Tommydag/BLDC-Motor-Controller/Documentation/PhotosOfBoard/IMG_7694.JPG

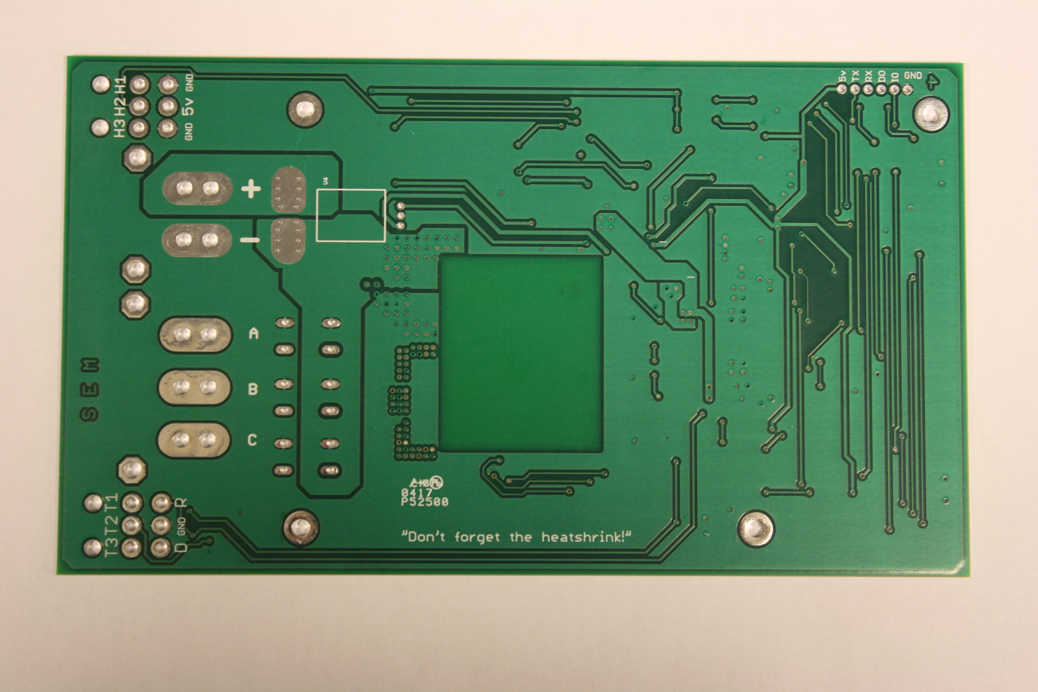
Documentation/PhotosOfBoard/IMG_7694.JPG
