Tommydag/BLDC-Motor-Controller/Documentation/PhotosOfBoard/IMG_7686.JPG

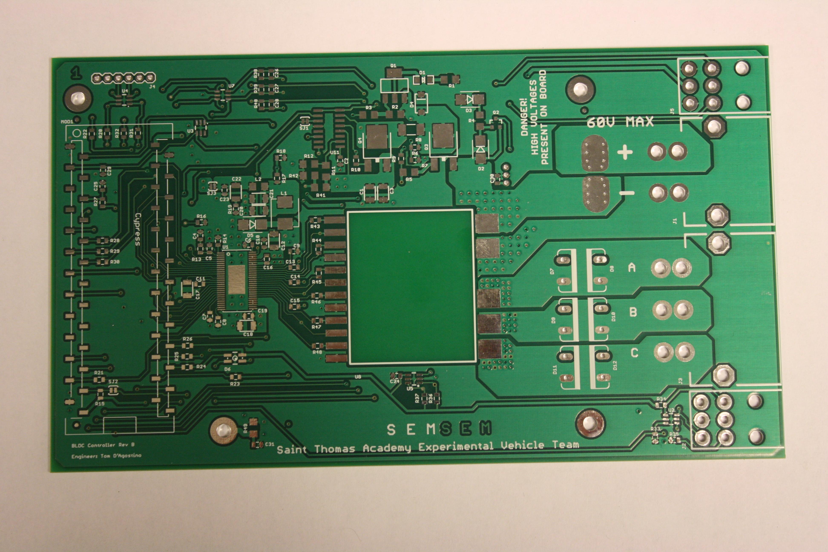
Documentation/PhotosOfBoard/IMG_7686.JPG
