Tommydag/BLDC-Motor-Controller/README.md

# BLDC-Motor-Controller
A BLDC Motor Controller for small electric vehicles
