Tommydag/BLDC-Motor-Controller/Documentation/RevC Documents/psoc_pinout.xlsx

PSOC Pin Planning
 |  |  |  |  |  |  | Signals that need to be routed | Type
PSOC Pin | Chip Region | Chip Features | Additional chip features | Side (L/R) | Board Features | Assigned Function | H1 | D in
2.0 | Mixed |  |  | L |  | reverse | H2 | D in
2.1 | Mixed |  |  | L | user LED |  | H3 | D in
2.2 | Mixed |  |  | L | user Pushbutton |  | T Alert | D in
2.3 | Mixed |  |  | L |  | inh a | GPIO_TBD | DIO
2.4 | Mixed |  |  | L |  | inl a | REVERSE | D in
2.5 | Mixed |  |  | L |  | inh b | VIN Fault | D in
2.6 | Mixed |  |  | L |  | inl b | disp_out | D out
2.7 | Mixed |  |  | L |  | inh c | disable | D in
12.7 | Mixed | SIO |  | L |  | inl c | led blue | D out
12.6 | Mixed | SIO |  | L |  | led blue | led green | Dout
12.5 | Mixed | SIO |  | L |  | led green | led red | D out
12.4 | Mixed | SIO |  | L |  | led red | inh a | D out
12.3 | Mixed | SIO |  | L |  | gpio_tbd | inl a | D out
12.2 | Mixed | SIO |  | L |  | H1 | inh b | D out
12.1 | Mixed | SIO |  | L |  | H2 | inl b | D out
12.0 | Mixed | SIO |  | L |  | H3 | inh c | D out
1.0 | Digital | DEBUG |  | L |  |  | inl c | D out
1.1 | Digital | DEBUG |  | L |  |  | monitor tx | D out
1.2 | Digital | reset |  | L |  | PULLUP | monitor rx | D in
1.3 | Digital | DEBUG |  | L |  |  | throttle | Analog in
1.4 | Digital |  |  | L |  | monitor tx | vbat in | Analog in
1.5 | Digital |  |  | L |  | monitor rx | ibat in | Analog in
1.6 | Digital |  |  | L |  | vin_fault | sda | DIO
1.7 | Digital |  |  | L |  | disp_out | scl | DO
3.0 | Analog |  |  | R |  | modeset 1
3.1 | Analog |  |  | R |  | modeset 2 | bypass cap adc1 | Analog in
3.2 | Analog | opamp3 inverting | internal reference bypass cap | R | Bypass cap | bypass cap | bypass cap adc2 | Analog in
3.3 | Analog | opamp3 non-inverting |  | R |  | modeset 3 | modeset 1 | D in
3.4 | Analog | opamp 1 inverting |  | R |  | modeset 4 | modeset 2 | D in
3.5 | Analog | opamp 1 non-inverting |  | R |  | throttle | modeset 3 | D in
3.6 | Analog | opamp1 out |  | R |  |  | modeset 4 | D in
3.7 | Analog | opamp3 out |  | R
15.0 | Digital |  |  | R |  | sda
15.1 | Digital |  |  | R |  | scl
15.2 | Digital |  |  | R |  | T alert
15.3 | Digital |  |  | R |  | disable
15.4 | Digital |  |  | R | cmod cap
15.5 | Digital |  |  | R
0.0 | Analog | OpAmp2 Out |  | R
0.1 | Analog | OpAmp0 Out |  | R |  | vbat in
0.2 | Analog | OpAmp0 non-inverting | SAR ADC refernce input | R | Bypass cap
0.3 | Analog | OpAmp0 inverting | internal reference bypass cap | R | Bypass cap | bypass cap
0.4 | Analog | OpAmp2 non-inverting |  | R | Bypass cap
0.5 | Analog | OpAmp2 inverting |  | R |  | ibat in
0.6 | Analog |  |  | R
0.7 | Analog |  |  | R
RST |  |  |  | R
