Tommydag/BLDC-Motor-Controller/Documentation/RevC Documents/PSU/LT8631 Vout1 Efficiency Chart.png

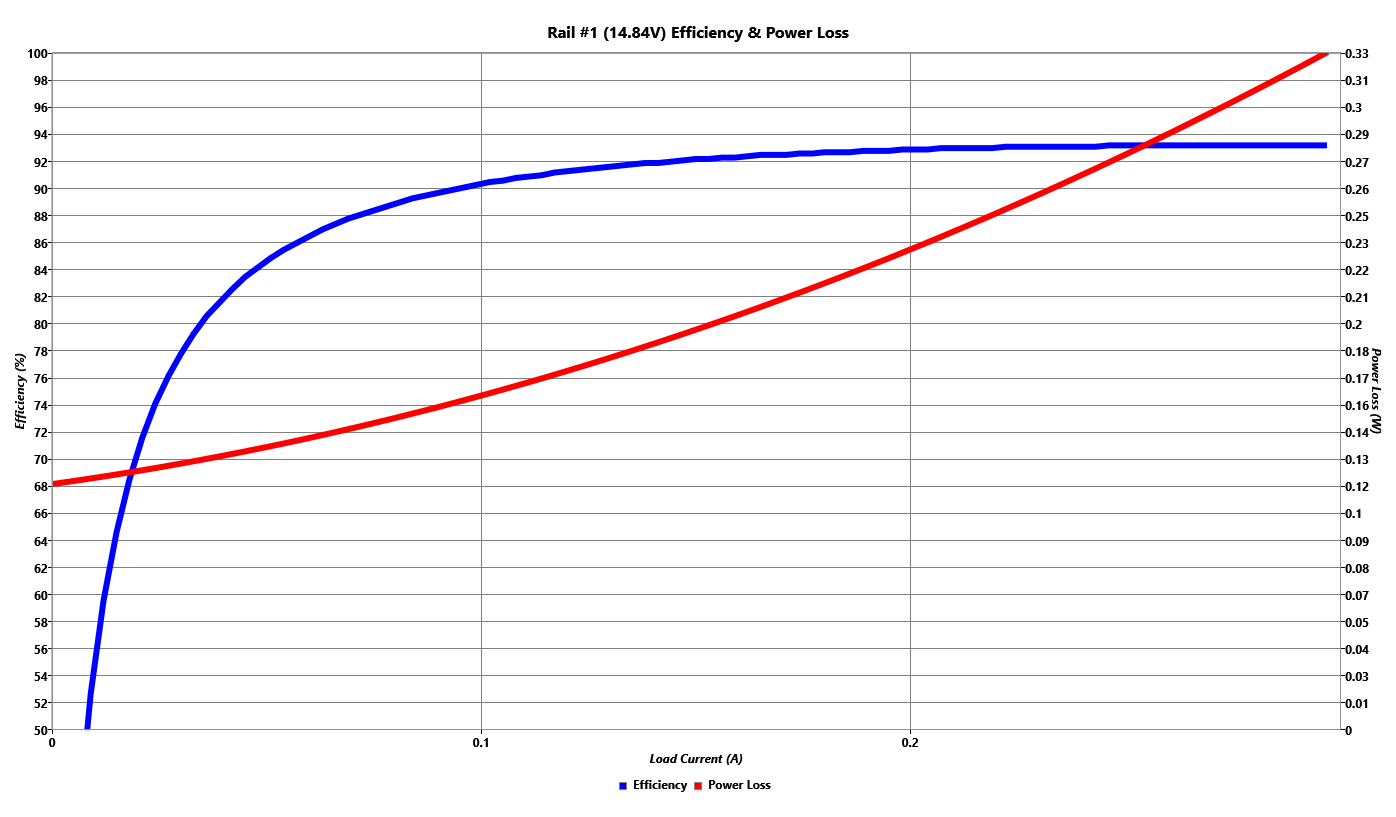
Documentation/RevC Documents/PSU/LT8631 Vout1 Efficiency Chart.png
