Tommydag/BLDC-Motor-Controller/PCBs/Projects/MotorController/CAM/BOM_reformatted.xlsx

 |  | PCB Revision: B | BOM Rev: 1
 |  | Engineer: Tom D'Agostino | Date: 1/20/2017
BOM Number | Qty | Value | Device | Package | Parts | Notes | Manufacturer | Manufacturer Part Number | Supplier | Supplier Part Number
1 | 4 | 4.7u | CAP1210 | 1210 | C1, C3, C12, C18 | 70v | Murata | GRM32ER71K475KE14L (https://www.digikey.com/product-detail/en/murata-electronics-north-america/GRM32ER71K475KE14L/490-9972-1-ND/5026477) | Digikey | 490-9972-1-ND (https://www.digikey.com/product-detail/en/murata-electronics-north-america/GRM32ER71K475KE14L/490-9972-1-ND/5026477)
2 | 9 | 0.1u | CAP0805 | 0805 | C10, C13, C14, C15, C16, C19, C24, C25, C30 | 70v | Samsung | CL21B104KCFNNNE | Digikey | 1276-6840-1-ND
3 | 1 | 2.2u | CAP1210 | 1210 | C17 | 25v | Samsung | CL32B225KAINNNE | Digikey | 1276-1313-1-ND
4 | 1 | 47n | CAP0805 | 0805 | C2 | 10v,NP0 | Kemet | C0805C473J3GACAUTO | Digikey | 399-6970-1-ND
5 | 3 | 47u | CAP1210 | 1210 | C20, C21, C22 | 10v | Taiyo Yuden | LMK325B7476MM-TR | Digikey | 587-2783-1-ND
6 | 2 | 0.01u | CAP0805 | 0805 | C23, C31 | 80v | AVX Corporation | 08051C103KAT2A | Digikey | 478-1358-1-ND
7 | 4 | 10n | CAP0805 | 0805 | C26, C27, C28, C29 | 10v | AVX Corporation | 08051C103KAT2A | Digikey | 478-1358-1-ND
8 | 1 | 6.8n | CAP0805 | 0805 | C4 | 70v,NP0 | TDK Corp. | CGA4J2C0G2A682J125AA | Digikey | 445-15555-1-ND
9 | 1 | 120p | CAP0805 | 0805 | C5 | 70v,NP0 | Yageo | CC0805JRNPO0BN121 | Digikey | 311-1836-1-ND
10 | 3 | 22n | CAP0805 | 0805 | C6, C9, C11 | 70v,NP0 | TDK Corp. | CGA4J1C0G2A223J125AC | Digikey | 445-172690-1-ND
11 | 2 | 1u | CAP0805 | 0805 | C7, C8 | 15v | Yageo | CC0805KKX7R7BB105 | Digikey | 311-1365-1-ND
12 | 1 | RED | LED-RED1206 | LED-1206 | D1 |  | Broadcom | HSMH-C150 (http://www.digikey.com/product-detail/en/broadcom-limited/HSMH-C150/516-1439-1-ND/637763) | Digikey | 516-1439-1-ND (http://www.digikey.com/product-detail/en/broadcom-limited/HSMH-C150/516-1439-1-ND/637763)
13 | 2 | S3BB | DIODES3BB | SMB-DIODE | D2, D3 |  | Diodes Inc. | S3BB-13-F | Digikey | S3BB-FDICT-ND
14 | 1 | SMAJ70CA | SMAJ70CA | SMA-DIODE | D4 |  | ON Semi. | 1SMA70CAT3G | Digikey | 1SMA70CAT3GOSCT-ND
15 | 1 | PMEG10030ELPX | PMEG10030ELPX | SMB-DIODE | D5 |  | NXP USA | PMEG10030ELPX | Digikey | 568-12696-1-ND
16 | 1 | CLV1A-FKB | 0.13_RGB_LEDCLV1A-FKB | P-LCC-4-3 | D6 |  | Cree Inc. | CLV1A-FKB-CK1N1G1BB7R4S3 | Digikey | CLV1A-FKB-CK1N1G1BB7R4S3TR-ND
17 | 6 | MBRF1090 | DIODE-SCHOTTKY-MBRF1090_V | TO220V_2 | D7, D8, D9, D10, D11, D12 |  | Vishay | MBRF10H100-E3/45 | Digikey | MBRF10H100-E3/45GI-ND
18 | 1 | Power header | M02MINIFIT-SR | MINIFIT_SR | J1 |  | Molex | 428202213 | Digikey | WM6461-ND
19 | 2 | Signals header | M03X2MINIFIT_JR | 2X03_MINIFIT_JR | J2, J5 |  | Molex | 39301061 | Digikey | WM1365-ND
20 | 1 | Motor header | M03MINIFIT-SR3 | MINIFIT-SRX3 | J3 |  | Molex | 428203213 | Digikey | WM11180-ND
21 | 1 | Optional Header | M06SILK_FEMALE_PTH | 1X06 | J4 | Optional | Sullins Connector | PPPC061LFBN-RC (http://www.digikey.com/product-detail/en/sullins-connector-solutions/PPPC061LFBN-RC/S7039-ND/810178) | Digikey | S7039-ND (http://www.digikey.com/product-detail/en/sullins-connector-solutions/PPPC061LFBN-RC/S7039-ND/810178)
22 | 1 | 22u | INDUCTORSRP7050TA-220M | IND_SMD_SRP7050TA | L1 | Shielded, 2.5A | Bourns, Inc. | SRP7050TA-220M (http://www.digikey.com/product-detail/en/bourns-inc/SRP7050TA-220M/SRP7050TA-220MCT-ND/5429771) | Digikey | SRP7050TA-220MCT-ND (http://www.digikey.com/product-detail/en/bourns-inc/SRP7050TA-220M/SRP7050TA-220MCT-ND/5429771)
23 | 1 |  | FERRITE-1206 | FB1206 | L2 | 2.5A | Wurth Electronics | 74279221601 (http://www.digikey.com/product-detail/en/wurth-electronics-inc/74279221601/732-6133-1-ND/5050869) | Digikey | 732-6133-1-ND (http://www.digikey.com/product-detail/en/wurth-electronics-inc/74279221601/732-6133-1-ND/5050869)
24 | 1 | PSOC5LP-DEVBRDCY8CKIT-059 | PSOC5LP-DEVBRDCY8CKIT-059 | CYKIT059 | MOD1 |  | Cypress Semi. | CY8CKIT-059 | Digikey | 428-3390-ND
25 | 1 | ZXMP10A17GQ | MOSFET-PCHANNELZXMP10A17GQ | SOT223 | Q1 |  | Diodes Inc. | ZXMP10A17GQTA | Digikey | ZXMP10A17GQTADICT-ND
26 | 1 | MMBT5551LT1G | TRANSISTOR_NPNMMBT5551LT1G | SOT23-3 | Q2 |  | ON Semi. | SMMBT5551LT1G (http://www.digikey.com/product-detail/en/on-semiconductor/SMMBT5551LT1G/SMMBT5551LT1GOSCT-ND/5213406) | Digikey | SMMBT5551LT1GOSCT-ND
27 | 2 | BUK9240-100A.118 | MOSFET-NCHANNELBUK9240-100A.118 | DPAK | Q3, Q4 |  | NXP USA | BUK9240-100A,118 | Digikey | 568-9670-1-ND
28 | 1 | 2.8k | RESISTOR1206 | 1206 | R1 |  | Yageo | RC1206FR-072K8L | Digikey | 311-2.80KFRCT-ND
29 | 8 | 10 | RESISTOR0805-RES | 0805 | R10, R19, R43, R44, R45, R46, R47, R48 | Non-Inductive | Rohm Semi. | ESR10EZPF10R0 (http://www.digikey.com/product-detail/en/rohm-semiconductor/ESR10EZPF10R0/RHM10.0AECT-ND/1983807) | Digikey | RHM10.0AECT-ND (http://www.digikey.com/product-detail/en/rohm-semiconductor/ESR10EZPF10R0/RHM10.0AECT-ND/1983807)
30 | 1 | 274K | RESISTOR1206 | 1206 | R11 | TOL 1% | Panasonic | ERJ-8ENF2743V (http://www.digikey.com/product-detail/en/panasonic-electronic-components/ERJ-8ENF2743V/P274KFCT-ND/89960) | Digikey | P274KFCT-ND (http://www.digikey.com/product-detail/en/panasonic-electronic-components/ERJ-8ENF2743V/P274KFCT-ND/89960)
31 | 1 | 4.99K | RESISTOR1206 | 1206 | R12 | TOL 1% | Yageo | RC1206FR-074K99L (http://www.digikey.com/product-detail/en/yageo/RC1206FR-074K99L/311-4.99KFRCT-ND/731843) | Digikey | 311-4.99KFRCT-ND (http://www.digikey.com/product-detail/en/yageo/RC1206FR-074K99L/311-4.99KFRCT-ND/731843)
32 | 1 | 16.2K | RESISTOR0805-RES | 0805 | R13 |  | Yageo | RC0805FR-0716K2L | Digikey | 311-16.2KCRCT-ND
33 | 1 | 249k | RESISTOR0805-RES | 0805 | R14 |  | Vishay Dale | TNPW0805249KBEEA (http://www.digikey.com/product-detail/en/vishay-dale/TNPW0805249KBEEA/TNP249KABCT-ND/1857110) | Digikey | TNP249KABCT-ND (http://www.digikey.com/product-detail/en/vishay-dale/TNPW0805249KBEEA/TNP249KABCT-ND/1857110)
34 | 1 | 47k | RESISTOR0805-RES | 0805 | R15 |  | Yageo | RC0805FR-0747KL (http://www.digikey.com/product-detail/en/yageo/RC0805FR-0747KL/311-47.0KCRCT-ND/730920) | Digikey | 311-47.0KCRCT-ND (http://www.digikey.com/product-detail/en/yageo/RC0805FR-0747KL/311-47.0KCRCT-ND/730920)
35 | 11 | 100 | RESISTOR0805-RES | 0805 | R16, R20, R21, R22, R23, R27, R28, R29, R30, R31, R32 |  | Stackpole Electronics | RNCP0805FTD100R (http://www.digikey.com/product-detail/en/stackpole-electronics-inc/RNCP0805FTD100R/RNCP0805FTD100RCT-ND/2240548) | Digikey | RNCP0805FTD100RCT-ND (http://www.digikey.com/product-detail/en/stackpole-electronics-inc/RNCP0805FTD100R/RNCP0805FTD100RCT-ND/2240548)
36 | 1 | 51k | RESISTOR0805-RES | 0805 | R17 |  | Panasonic | ERA-6AEB513V (http://www.digikey.com/product-detail/en/panasonic-electronic-components/ERA-6AEB513V/P51KDACT-ND/1465988) | Digikey | P51KDACT-ND (http://www.digikey.com/product-detail/en/panasonic-electronic-components/ERA-6AEB513V/P51KDACT-ND/1465988)
37 | 1 | 30k | RESISTOR1206 | 1206 | R2 |  | Yageo | RC1206FR-0730KL (http://www.digikey.com/product-detail/en/yageo/RC1206FR-0730KL/311-30.0KFRCT-ND/731746) | Digikey | 311-30.0KFRCT-ND (http://www.digikey.com/product-detail/en/yageo/RC1206FR-0730KL/311-30.0KFRCT-ND/731746)
38 | 3 | 330 | RESISTOR0805-RES | 0805 | R24, R25, R26 |  | Rohm Semi. | ESR10EZPF3300 (http://www.digikey.com/product-detail/en/rohm-semiconductor/ESR10EZPF3300/RHM330AECT-ND/1983845) | Digikey | RHM330AECT-ND (http://www.digikey.com/product-detail/en/rohm-semiconductor/ESR10EZPF3300/RHM330AECT-ND/1983845)
39 | 1 | 51 | RESISTOR1206 | 1206 | R3 |  | Yageo | RC1206FR-0751RL (http://www.digikey.com/product-detail/en/yageo/RC1206FR-0751RL/311-51.0FRCT-ND/731920) | Digikey | 311-51.0FRCT-ND (http://www.digikey.com/product-detail/en/yageo/RC1206FR-0751RL/311-51.0FRCT-ND/731920)
40 | 1 | 510k | RESISTOR0805-RES | 0805 | R33 |  | Yageo | RT0805BRD07510KL (http://www.digikey.com/product-detail/en/yageo/RT0805BRD07510KL/YAG1922CT-ND/5139370) | Digikey | YAG1922CT-ND (http://www.digikey.com/product-detail/en/yageo/RT0805BRD07510KL/YAG1922CT-ND/5139370)
41 | 2 | 1k | RESISTOR0805-RES | 0805 | R34, R35 | TOL 1% | Panasonic | ERA-6AEB102V (http://www.digikey.com/product-detail/en/panasonic-electronic-components/ERA-6AEB102V/P1.0KDACT-ND/1465947) | Digikey | P1.0KDACT-ND (http://www.digikey.com/product-detail/en/panasonic-electronic-components/ERA-6AEB102V/P1.0KDACT-ND/1465947)
42 | 2 | 4.7k | RESISTOR0805-RES | 0805 | R36, R37 |  | Panasonic | ERA-6AEB472V (http://www.digikey.com/product-detail/en/panasonic-electronic-components/ERA-6AEB472V/P4.7KDACT-ND/1465963) | Digikey | P4.7KDACT-ND (http://www.digikey.com/product-detail/en/panasonic-electronic-components/ERA-6AEB472V/P4.7KDACT-ND/1465963)
43 | 1 | 10k | RESISTOR1206 | 1206 | R4 |  | Yageo | RC1206FR-0710KL (http://www.digikey.com/product-detail/en/yageo/RC1206FR-0710KL/311-10.0KFRCT-ND/731430) | Digikey | 311-10.0KFRCT-ND (http://www.digikey.com/product-detail/en/yageo/RC1206FR-0710KL/311-10.0KFRCT-ND/731430)
44 | 1 | 100k | RESISTOR1206 | 1206 | R41 | TOL <1% | Yageo | RC1206FR-07100KL (http://www.digikey.com/product-detail/en/yageo/RC1206FR-07100KL/311-100KFRCT-ND/731439) | Digikey | 311-100KFRCT-ND (http://www.digikey.com/product-detail/en/yageo/RC1206FR-07100KL/311-100KFRCT-ND/731439)
45 | 1 | 5.1k | RESISTOR1206 | 1206 | R42 | TOL <1% | Yageo | RT1206DRD075K1L (http://www.digikey.com/product-detail/en/yageo/RT1206DRD075K1L/311-2947-1-ND/6129366) | Digikey | 311-2947-1-ND (http://www.digikey.com/product-detail/en/yageo/RT1206DRD075K1L/311-2947-1-ND/6129366)
46 | 1 | 1M | RESISTOR1206 | 1206 | R49 | Non-Inductive | Stackpole Electronics | RMCF1206FT1M00 (http://www.digikey.com/product-detail/en/stackpole-electronics-inc/RMCF1206FT1M00/RMCF1206FT1M00CT-ND/1942746) | Digikey | RMCF1206FT1M00CT-ND (http://www.digikey.com/product-detail/en/stackpole-electronics-inc/RMCF1206FT1M00/RMCF1206FT1M00CT-ND/1942746)
47 | 1 | 10 | RESISTOR1206 | 1206 | R5 |  | Panasonic | ERJ-8ENF10R0V (http://www.digikey.com/product-detail/en/panasonic-electronic-components/ERJ-8ENF10R0V/P10.0FCT-ND/89026) | Digikey | P10.0FCT-ND (http://www.digikey.com/product-detail/en/panasonic-electronic-components/ERJ-8ENF10R0V/P10.0FCT-ND/89026)
48 | 1 | 133k | RESISTOR0805-RES | 0805 | R6 | TOL 1% | Rohm Semi. | KTR10EZPF1333 (http://www.digikey.com/product-detail/en/rohm-semiconductor/KTR10EZPF1333/RHM133KAHCT-ND/4054299) | Digikey | RHM133KAHCT-ND (http://www.digikey.com/product-detail/en/rohm-semiconductor/KTR10EZPF1333/RHM133KAHCT-ND/4054299)
49 | 5 | 10k | RESISTOR0805-RES | 0805 | R7, R18, R38, R39, R40 | TOL 1% | Yageo | AT0805DRD0710KL (http://www.digikey.com/product-detail/en/yageo/AT0805DRD0710KL/311-2121-1-ND/6128540) | Digikey | 311-2121-1-ND (http://www.digikey.com/product-detail/en/yageo/AT0805DRD0710KL/311-2121-1-ND/6128540)
50 | 1 | 0.016 | RESISTOR2010 | R2010 | R8 | TOL <1% | Vishay Dale | WSL2010R0330FEA | Digikey | WSLE-.033CT-ND
51 | 1 | 1M | RESISTOR0805-RES | 0805 | R9 |  | Panasonic | ERJ-6ENF1004V (http://www.digikey.com/product-detail/en/panasonic-electronic-components/ERJ-6ENF1004V/P1.00MCCT-ND/119836) | Digikey | P1.00MCCT-ND (http://www.digikey.com/product-detail/en/panasonic-electronic-components/ERJ-6ENF1004V/P1.00MCCT-ND/119836)
52 | 4 | STANDOFF_ELECTRICAL | STANDOFF_ELECTRICAL | STANDOFF-ELECTRICAL | S1, S2, S3, S4 |  | Schurter | 9832.53 (http://www.digikey.com/product-detail/en/schurter-inc/9832.5300/486-2424-ND/3533952) | Digikey | 486-2424-ND (http://www.digikey.com/product-detail/en/schurter-inc/9832.5300/486-2424-ND/3533952)
53 | 1 | DRV8301 | DRV8301 | HTSSOP_56 | U1 |  | TI | DRV8301DCAR | Digikey | 296-29433-1-ND
54 | 1 | LT4356-2 | LT4356-2 | SOIC-16 | U11 |  | Linear Technologies | LT4356HS-2#PBF | Digikey | LT4356HS-2#PBF-ND
55 | 4 | ESDA6V1SC6Y | ESDA6V1SC6Y | SOT23-6 | U2, U3, U4, U7 |  | STMicro | ESDA6V1SC6Y | Digikey | 497-13409-1-ND
56 | 1 | TMP101 | TMP101 | SOT23-6 | U5 |  | TI | TMP101NA/3K (http://www.digikey.com/product-detail/en/texas-instruments/TMP101NA-3K/296-27725-1-ND/2356441) | Digikey | 296-27725-1-ND (http://www.digikey.com/product-detail/en/texas-instruments/TMP101NA-3K/296-27725-1-ND/2356441)
57 | 1 | ACS758LCB | ACS758LCB | CB5PIN | U6 |  | Allegro | ACS758LCB-100U-PFF-T | Digikey | 620-1354-ND
58 | 1 | MTI85W100GC | MTI85W100GC | ISOPLUS-DIL | U8 |  | IXYS | MTI85W100GC | Mouser | 747-MTI85W100GC
Non-PCB related items
59 | 1 | Receptical for J1 | MINIFIT_SR_RECEPT_2POS |  | CON1 |  | Molex | 428160212 | Digikey | WM1927-ND
60 | 1 | Receptical for J3 | MINIFIT_SR_RECEPT_3POS |  | CON2 |  | Molex | 428160312 | Digikey | WM1928-ND
61 | 5 | 8 AWG contacts for CON1 and CON2 | MINIFIT_SR_8AWG_CONTACTS |  |  | Choose if using 8AWG wiring | Molex | 428150032 | Digikey | WM9167CT-ND
62 | 5 | 10-12 AWG contacts for CON1 and CON2 | MINIFIT_SR_10-12AWG_CONTACTS |  |  | Choose if using 10-12AWG wiring | Molex | 428150012 (http://www.digikey.com/product-detail/en/molex-llc/0428150012/WM9166CT-ND/3829574) | Digikey | WM9166CT-ND (http://www.digikey.com/product-detail/en/molex-llc/0428150012/WM9166CT-ND/3829574)
63 | 2 | Receptical for J2,J5 | MINIFIT_JR_RECEPT_6POS |  | CON3,CON4 |  | Molex | 39039062 | Digikey | WM12978-ND
64 | 12 | 18-24AWG contacts for CON3 and CON4 | MINIFIT_JR_18-24AWG_CONTACTS |  |  |  | Molex | 39000182 | Digikey | WM18518-ND
65 | 2 | Receptical for MOD1 | MOD1_RECEPT_28POS |  | CON5,CON6 |  | Samtech | SSM-128-L-SV | Digikey | SAM1148-28-ND
66 | 2 | Headers for MOD1 | MOD1_HEADER_28POS |  |  |  | Sullins Connector | PRPC028SAAN-RC | Digikey | S1011EC-28-ND
67 | 1 |  | 16x2 LCD |  |  | Optional External LCD Display | Sparkfun | LCD-09395 | Sparkfun | LCD-09395
