Tommydag/BLDC-Motor-Controller/PCBs/Projects/MotorController/CAM/revC/revC-bom.xlsx

Sheet: Sheet1
Digi-Key Part Number | Manufacturer Name | Manufacturer Part Number | Customer Reference | Quantity 1 | Quantity 2

Sheet: Sheet2
 |  | PCB Revision: C | BOM Rev: 1
 |  | Engineer: Tom D'Agostino | Date: 3/9/2017
BOM Number | Qty | Value | Device | Package | Parts | Notes | Manufacturer | Manufacturer Part Number | Supplier | Supplier Part Number
 | 5 | 4.7u | CAP1210 | 1210 | C1,3,27,28,29 | 70v | Murata | GRM32ER71K475KE14L (https://www.digikey.com/product-detail/en/murata-electronics-north-america/GRM32ER71K475KE14L/490-9972-1-ND/5026477) | Digikey | 490-9972-1-ND (https://www.digikey.com/product-detail/en/murata-electronics-north-america/GRM32ER71K475KE14L/490-9972-1-ND/5026477)
 | 1 | 0.047u | CAP0805 | 0805 | C2 | 10v,NP0 | Kemet | C0805C473J3GACAUTO | Digikey | 399-6970-1-ND
 | 1 | 2.2u | CAP1210 | 1210 | C4 | 25v | Samsung | CL32B225KAINNNE | Digikey | 1276-1313-1-ND
 | 11 | 0.1u | CAP0805 | 0805 | C5,10,18,19,20,21,26,30,31,32,33 | 70v | Samsung | CL21B104KCFNNNE | Digikey | 1276-6840-1-ND
 | 2 | 10u | CAP1210 | 1210 | C6,15 | 80v | AVX Corporation | 08051C103KAT2A | Digikey | 478-1358-1-ND
 | 6 | 0.01u | CAP0805 | 0805 | C7,22,23,24,25,34 | 10v | AVX Corporation | 08051C103KAT2A | Digikey | 478-1358-1-ND
 | 1 | 5600p | CAP0805 | 0805 | C9 | 100v,NP0 | TDK Corp. | CGA4J2C0G2A562J125AA (http://www.digikey.com/product-detail/en/tdk-corporation/CGA4J2C0G2A562J125AA/445-15554-1-ND/4278727) | Digikey | 445-15554-1-ND (http://www.digikey.com/product-detail/en/tdk-corporation/CGA4J2C0G2A562J125AA/445-15554-1-ND/4278727)
 | 1 | 4.7u | CAP_POL1206 | EIA3216 | C11 | 10v,Tant-poly | Vishay | T55A475M010C0200 (http://www.digikey.com/product-detail/en/vishay-sprague/T55A475M010C0200/718-2007-1-ND/4989603) | Digikey | 718-2007-1-ND (http://www.digikey.com/product-detail/en/vishay-sprague/T55A475M010C0200/718-2007-1-ND/4989603)
 | 1 | 200p | CAP0805 | 0805 | C12 | 100v,NP0 | Murata | GQM2195C2A201GB12D (http://www.digikey.com/product-detail/en/murata-electronics-north-america/GQM2195C2A201GB12D/490-7182-1-ND/3900433) | Digikey | 490-7182-1-ND (http://www.digikey.com/product-detail/en/murata-electronics-north-america/GQM2195C2A201GB12D/490-7182-1-ND/3900433)
 | 1 | DNP | CAP0805 | 0805 | C13 | 35v | TDK Corp. | CGA4J1X7R1V225K125AE (http://www.digikey.com/product-detail/en/tdk-corporation/CGA4J1X7R1V225K125AE/445-8787-1-ND/3248549) | Digikey | 445-8787-1-ND (http://www.digikey.com/product-detail/en/tdk-corporation/CGA4J1X7R1V225K125AE/445-8787-1-ND/3248549)
 | 3 | 47u | CAP1210 | 1210 | C14,16,17 | 10v | Taiyo Yuden | LMK325B7476MM-TR | Digikey | 587-2783-1-ND
 | 1 | 2.2u | CAP0805 | 0805 | C8 | 35v | TDK Corp. | CGA4J1X7R1V225M125AE (http://www.digikey.com/product-detail/en/tdk-corporation/CGA4J1X7R1V225M125AE/445-7956-1-ND/2782524) | Digikey | 445-7956-1-ND (http://www.digikey.com/product-detail/en/tdk-corporation/CGA4J1X7R1V225M125AE/445-7956-1-ND/2782524)
 | 1 | RED | LED-RED1206 | LED-1206 | D1 |  | Broadcom | HSMH-C150 (http://www.digikey.com/product-detail/en/broadcom-limited/HSMH-C150/516-1439-1-ND/637763) | Digikey | 516-1439-1-ND (http://www.digikey.com/product-detail/en/broadcom-limited/HSMH-C150/516-1439-1-ND/637763)
 | 2 | S3BB | DIODES3BB | SMB-DIODE | D2,3 |  | Diodes Inc. | S3BB-13-F | Digikey | S3BB-FDICT-ND
 | 1 | SMAJ70CA | SMAJ70CABIDIRECTIONAL | SMA-DIODE-BI | D4 |  | ON Semi. | 1SMA70CAT3G | Digikey | 1SMA70CAT3GOSCT-ND
 | 2 | GREEN | LED-RED1206 | LED-1206 | D5,6 |  | Broadcom | HSMG-C150 (http://www.digikey.com/product-detail/en/broadcom-limited/HSMG-C150/516-1443-1-ND/637767) | Digikey | 516-1443-1-ND (http://www.digikey.com/product-detail/en/broadcom-limited/HSMG-C150/516-1443-1-ND/637767)
 | 1 | CLV1A-FKB | 0.13_RGB_LEDCLV1A-FKB | P-LCC-4-3 | D7 |  | Cree Inc. | CLV1A-FKB-CK1N1G1BB7R4S3 | Digikey | CLV1A-FKB-CK1N1G1BB7R4S3TR-ND
 | 3 | SZMM3Z18VST1G | DIODE-ZENERSZMM3Z18VST1G | SOD-323 | D8,9,10 |  | ON Semiconducto (http://www.digikey.com/en/supplier-centers/o/on-semiconductor) | SZMM3Z18VST1G (http://www.digikey.com/product-detail/en/on-semiconductor/SZMM3Z18VST1G/SZMM3Z18VST1GOSCT-ND/5969228) | Digikey | SZMM3Z18VST1GOSCT-ND (http://www.digikey.com/product-detail/en/on-semiconductor/SZMM3Z18VST1G/SZMM3Z18VST1GOSCT-ND/5969228)
 | 6 | MBRF10H100 | DIODE-SCHOTTKY-MBRF1090_V | TO220V_2 | D11,12,13,14,15,16 |  | Vishay | MBRF10H100-E3/45 | Digikey | MBRF10H100-E3/45GI-ND
 | 2 | B59607A120A62 | PTC1210 | 1210 | F1,2 |  | EPCOS | B59607A120A62 (http://www.digikey.com/product-detail/en/epcos-tdk/B59607A120A62/495-2417-1-ND/1087551) | Digikey | 495-2417-1-ND (http://www.digikey.com/product-detail/en/epcos-tdk/B59607A120A62/495-2417-1-ND/1087551)
 | 1 | M02MINIFIT-SR | MINIFIT_SR | 0.1 header | J1 |  | Molex | 428202213 | Digikey | WM6461-ND
 | 2 | M03X2MINIFIT_JR | 2X03_MINIFIT_JR | 2x3 .1 header | J2,5 |  | Molex | 39301061 | Digikey | WM1365-ND
 | 1 | M03MINIFIT-SR3 | MINIFIT-SRX3 | Header 3 | J3 |  | Molex | 428203213 | Digikey | WM11180-ND
 | 1 | M06SILK_FEMALE_PTH | 1X06 | Header 6 | J4 |  | Sullins Connector | PPPC061LFBN-RC (http://www.digikey.com/product-detail/en/sullins-connector-solutions/PPPC061LFBN-RC/S7039-ND/810178) | Digikey | S7039-ND (http://www.digikey.com/product-detail/en/sullins-connector-solutions/PPPC061LFBN-RC/S7039-ND/810178)
 | 1 | 22u | INDUCTORSRP7050TA-220M | IND_SMD_SRP7050TA | L1 |  | Bourns, Inc. | SRP7050TA-220M (http://www.digikey.com/product-detail/en/bourns-inc/SRP7050TA-220M/SRP7050TA-220MCT-ND/5429771) | Digikey | SRP7050TA-220MCT-ND (http://www.digikey.com/product-detail/en/bourns-inc/SRP7050TA-220M/SRP7050TA-220MCT-ND/5429771)
 | 1 | PSOC5LP-DEVBRDCY8CKIT-059 | PSOC5LP-DEVBRDCY8CKIT-059 | CYKIT059 | MOD1 |  | Cypress Semi. | CY8CKIT-059 | Digikey | 428-3390-ND
 | 1 | ZXMP10A17GQ | MOSFET-PCHANNELZXMP10A17GQ | SOT223 | Q1 |  | Diodes Inc. | ZXMP10A17GQTA | Digikey | ZXMP10A17GQTADICT-ND
 | 1 | MMBT5551LT1G | TRANSISTOR_NPNMMBT5551LT1G | SOT23-3 | Q2 |  | ON Semi. | SMMBT5551LT1G (http://www.digikey.com/product-detail/en/on-semiconductor/SMMBT5551LT1G/SMMBT5551LT1GOSCT-ND/5213406) | Digikey | SMMBT5551LT1GOSCT-ND
 | 2 | BUK9240-100A.118 | MOSFET-NCHANNELBUK9240-100A.118 | DPAK | Q3,4 |  | NXP USA | BUK9240-100A,118 | Digikey | 568-9670-1-ND | 568-9670-1-ND
 | 2 | NCV8440 | MOSFET-NCHANNELNCV8440 | SOT223 | Q5,6 |  | ON Semi. | NCV8440ASTT1G (http://www.digikey.com/product-detail/en/on-semiconductor/NCV8440ASTT1G/NCV8440ASTT1GOSCT-ND/5969305) | Digikey | NCV8440ASTT1GOSCT-ND (http://www.digikey.com/product-detail/en/on-semiconductor/NCV8440ASTT1G/NCV8440ASTT1GOSCT-ND/5969305)
 | 1 | 0.2 | RESISTOR1206 | 1206 | R8 |  | Vishay | WSL1206R2000FEA (http://www.digikey.com/product-detail/en/vishay-dale/WSL1206R2000FEA/WSLC-.20CT-ND/713435) | Digikey | WSLC-.20CT-ND (http://www.digikey.com/product-detail/en/vishay-dale/WSL1206R2000FEA/WSLC-.20CT-ND/713435)
 | 1 | 0.5 | RESISTOR0805-RES | 0805 | R14 |  | Yageo | RL0805FR-7W0R5L (http://www.digikey.com/product-detail/en/yageo/RL0805FR-7W0R5L/311-.5LUCT-ND/3885461) | Digikey | 311-.5LUCT-ND (http://www.digikey.com/product-detail/en/yageo/RL0805FR-7W0R5L/311-.5LUCT-ND/3885461)
 | 9 | 10 | RESISTOR0805-RES | 0805 | R5,10,13,56,57,58,59,60,61 | Non-Inductive | Rohm Semi. | ESR10EZPF10R0 (http://www.digikey.com/product-detail/en/rohm-semiconductor/ESR10EZPF10R0/RHM10.0AECT-ND/1983807) | Digikey | RHM10.0AECT-ND (http://www.digikey.com/product-detail/en/rohm-semiconductor/ESR10EZPF10R0/RHM10.0AECT-ND/1983807)
 | 15 | 100 | RESISTOR0805-RES | 0805 | R3,29,30,31,32,34,35,36,37,38,39,40,41,45,47 |  | Stackpole Electronics | RNCP0805FTD100R (http://www.digikey.com/product-detail/en/stackpole-electronics-inc/RNCP0805FTD100R/RNCP0805FTD100RCT-ND/2240548) | Digikey | RNCP0805FTD100RCT-ND (http://www.digikey.com/product-detail/en/stackpole-electronics-inc/RNCP0805FTD100R/RNCP0805FTD100RCT-ND/2240548)
 | 1 | 100k | RESISTOR1206 | 1206 | R48 | TOL <1% | Yageo | RC1206FR-07100KL (http://www.digikey.com/product-detail/en/yageo/RC1206FR-07100KL/311-100KFRCT-ND/731439) | Digikey | 311-100KFRCT-ND (http://www.digikey.com/product-detail/en/yageo/RC1206FR-07100KL/311-100KFRCT-ND/731439)
 | 7 | 10k | RESISTOR0805-RES | 0805 | R4,7,17,26,50,51,52 |  | Yageo | RC1206FR-0710KL (http://www.digikey.com/product-detail/en/yageo/RC1206FR-0710KL/311-10.0KFRCT-ND/731430) | Digikey | 311-10.0KFRCT-ND (http://www.digikey.com/product-detail/en/yageo/RC1206FR-0710KL/311-10.0KFRCT-ND/731430)
 | 2 | 124k | RESISTOR0805-RES | 0805 | R6,16 |  | Panasonic | ERJ-6ENF1243V (http://www.digikey.com/product-detail/en/panasonic-electronic-components/ERJ-6ENF1243V/P124KCCT-ND/119578) | Digikey | P124KCCT-ND (http://www.digikey.com/product-detail/en/panasonic-electronic-components/ERJ-6ENF1243V/P124KCCT-ND/119578)
 | 1 | 140k | RESISTOR0805-RES | 0805 | R25 |  | Panasonic | ERJ-6ENF1403V (http://www.digikey.com/product-detail/en/panasonic-electronic-components/ERJ-6ENF1403V/P140KCCT-ND/119593) | Digikey | P140KCCT-ND (http://www.digikey.com/product-detail/en/panasonic-electronic-components/ERJ-6ENF1403V/P140KCCT-ND/119593)
 | 6 | 1k | RESISTOR0805-RES | 0805 | R28,42,43,44,54,55 | TOL 1% | Panasonic | ERA-6AEB102V (http://www.digikey.com/product-detail/en/panasonic-electronic-components/ERA-6AEB102V/P1.0KDACT-ND/1465947) | Digikey | P1.0KDACT-ND (http://www.digikey.com/product-detail/en/panasonic-electronic-components/ERA-6AEB102V/P1.0KDACT-ND/1465947)
 | 2 | 1M | RESISTOR0805-RES | 0805 | R9,22 |  | Panasonic | ERJ-6ENF1004V (http://www.digikey.com/product-detail/en/panasonic-electronic-components/ERJ-6ENF1004V/P1.00MCCT-ND/119836) | Digikey | P1.00MCCT-ND (http://www.digikey.com/product-detail/en/panasonic-electronic-components/ERJ-6ENF1004V/P1.00MCCT-ND/119836)
 | 1 | 1M | RESISTOR1206 | 1206 | R62 | Non-Inductive | Stackpole Electronics | RMCF1206FT1M00 (http://www.digikey.com/product-detail/en/stackpole-electronics-inc/RMCF1206FT1M00/RMCF1206FT1M00CT-ND/1942746) | Digikey | RMCF1206FT1M00CT-ND (http://www.digikey.com/product-detail/en/stackpole-electronics-inc/RMCF1206FT1M00/RMCF1206FT1M00CT-ND/1942746)
 | 1 | 2 | RESISTOR1206 | 1206 | R15 |  | Vishay | PCNM1206K2R00FST5 (http://www.digikey.com/product-detail/en/vishay-thin-film/PCNM1206K2R00FST5/764-1258-1-ND/6073265) | Digikey | 764-1258-1-ND (http://www.digikey.com/product-detail/en/vishay-thin-film/PCNM1206K2R00FST5/764-1258-1-ND/6073265)
 | 1 | 2.7k | RESISTOR0805-RES | 0805 | R27 |  | Yageo | RC0805FR-072K7L (http://www.digikey.com/product-detail/en/yageo/RC0805FR-072K7L/311-2.70KCRCT-ND/730653) | Digikey | 311-2.70KCRCT-ND (http://www.digikey.com/product-detail/en/yageo/RC0805FR-072K7L/311-2.70KCRCT-ND/730653)
 | 1 | 2.8k | RESISTOR1206 | 1206 | R1 |  | Panasonic | ERJ-8ENF2801V (http://www.digikey.com/product-detail/en/panasonic-electronic-components/ERJ-8ENF2801V/P2.80KFCT-ND/89737) | Digikey | P2.80KFCT-ND (http://www.digikey.com/product-detail/en/panasonic-electronic-components/ERJ-8ENF2801V/P2.80KFCT-ND/89737)
 | 1 | 25.5k | RESISTOR0805-RES | 0805 | R19 |  | Panasonic | ERJ-6ENF2552V (http://www.digikey.com/product-detail/en/panasonic-electronic-components/ERJ-6ENF2552V/P25.5KCCT-ND/119378) | Digikey | P25.5KCCT-ND (http://www.digikey.com/product-detail/en/panasonic-electronic-components/ERJ-6ENF2552V/P25.5KCCT-ND/119378)
 | 1 | 274k | RESISTOR0805-RES | 0805 | R11 | TOL 1% | Panasonic | ERJ-8ENF2743V (http://www.digikey.com/product-detail/en/panasonic-electronic-components/ERJ-8ENF2743V/P274KFCT-ND/89960) | Digikey | P274KFCT-ND (http://www.digikey.com/product-detail/en/panasonic-electronic-components/ERJ-8ENF2743V/P274KFCT-ND/89960)
 | 2 | 4.7k | RESISTOR0805-RES | 0805 | R33,46 |  | Panasonic | ERA-6AEB472V (http://www.digikey.com/product-detail/en/panasonic-electronic-components/ERA-6AEB472V/P4.7KDACT-ND/1465963) | Digikey | P4.7KDACT-ND (http://www.digikey.com/product-detail/en/panasonic-electronic-components/ERA-6AEB472V/P4.7KDACT-ND/1465963)
 | 1 | 4.99k | RESISTOR0805-RES | 0805 | R12 | TOL 1% | Yageo | RC1206FR-074K99L (http://www.digikey.com/product-detail/en/yageo/RC1206FR-074K99L/311-4.99KFRCT-ND/731843) | Digikey | 311-4.99KFRCT-ND (http://www.digikey.com/product-detail/en/yageo/RC1206FR-074K99L/311-4.99KFRCT-ND/731843)
 | 3 | 47k | RESISTOR0805-RES | 0805 | R2,18,21 |  | Yageo | RC0805FR-0747KL (http://www.digikey.com/product-detail/en/yageo/RC0805FR-0747KL/311-47.0KCRCT-ND/730920) | Digikey | 311-47.0KCRCT-ND (http://www.digikey.com/product-detail/en/yageo/RC0805FR-0747KL/311-47.0KCRCT-ND/730920)
 | 1 | 49.9k | RESISTOR0805-RES | 0805 | R24 |  | Stackpole Electronics | RMCF0805FT49K9 (http://www.digikey.com/product-detail/en/stackpole-electronics-inc/RMCF0805FT49K9/RMCF0805FT49K9CT-ND/1942474) | Digikey | RMCF0805FT49K9CT-ND (http://www.digikey.com/product-detail/en/stackpole-electronics-inc/RMCF0805FT49K9/RMCF0805FT49K9CT-ND/1942474)
 | 1 | 499 | RESISTOR0805-RES | 0805 | R20 |  | Stackpole Electronics | RMCF0805FT499R (http://www.digikey.com/product-detail/en/stackpole-electronics-inc/RMCF0805FT499R/RMCF0805FT499RCT-ND/1942358) | Digikey | RMCF0805FT499RCT-ND (http://www.digikey.com/product-detail/en/stackpole-electronics-inc/RMCF0805FT499R/RMCF0805FT499RCT-ND/1942358)
 | 1 | 5.1k | RESISTOR1206 | 1206 | R49 | TOL <1% | Yageo | RT1206DRD075K1L (http://www.digikey.com/product-detail/en/yageo/RT1206DRD075K1L/311-2947-1-ND/6129366) | Digikey | 311-2947-1-ND (http://www.digikey.com/product-detail/en/yageo/RT1206DRD075K1L/311-2947-1-ND/6129366)
 | 1 | 510k | RESISTOR0805-RES | 0805 | R53 |  | Yageo | RT0805BRD07510KL (http://www.digikey.com/product-detail/en/yageo/RT0805BRD07510KL/YAG1922CT-ND/5139370) | Digikey | YAG1922CT-ND (http://www.digikey.com/product-detail/en/yageo/RT0805BRD07510KL/YAG1922CT-ND/5139370)
 | 1 | 57.6k | RESISTOR0805-RES | 0805 | R23 |  | Panasonic | ERJ-6ENF5762V (http://www.digikey.com/product-detail/en/panasonic-electronic-components/ERJ-6ENF5762V/P57.6KCCT-ND/119481) | Digikey | P57.6KCCT-ND (http://www.digikey.com/product-detail/en/panasonic-electronic-components/ERJ-6ENF5762V/P57.6KCCT-ND/119481)
 | 1 | CD16RM0SBR | DIP-SWTCH-16POSCD16RM0SBR | DIP-8MM | SW1 |  | C&K | CD16RM0SBR (http://www.digikey.com/product-detail/en/c-k/CD16RM0SBR/CKN10630CT-ND/5799616) | Digikey | CKN10630CT-ND (http://www.digikey.com/product-detail/en/c-k/CD16RM0SBR/CKN10630CT-ND/5799616)
 | 17 | RCT-0C | TEST-POINTRCT-0C | TEST-POINT-MINI | TP1-17 |  | TE Connectivity | RCT-0C (http://www.digikey.com/product-detail/en/te-connectivity-amp-connectors/RCT-0C/A106144CT-ND/3477801) | Digikey | A106144CT-ND (http://www.digikey.com/product-detail/en/te-connectivity-amp-connectors/RCT-0C/A106144CT-ND/3477801)
 | 1 | LT4356-2 | LT4356-2 | SOIC-16 | U1 |  | Linear Technologies | LT4356HS-2#PBF | Digikey | LT4356HS-2#PBF-ND
 | 1 | LT8631 | LT8631 | TSSOP-20-FE | U2 |  | Linear Technologies | LT8631IFE#PBF | Digikey | LT8631IFE#PBF-ND
 | 1 | LT3045 | LT3045 | MSOP-12-EP | U3 |  | Linear Technologies | LT3045IMSE#PBF (http://www.digikey.com/product-detail/en/linear-technology/LT3045IMSE-PBF/LT3045IMSE-PBF-ND/6234773) | Digikey | LT3045IMSE#PBF-ND (http://www.digikey.com/product-detail/en/linear-technology/LT3045IMSE-PBF/LT3045IMSE-PBF-ND/6234773)
 | 1 | TMP101 | TMP101 | SOT23-6 | U4 |  | TI | TMP101NA/3K (http://www.digikey.com/product-detail/en/texas-instruments/TMP101NA-3K/296-27725-1-ND/2356441) | Digikey | 296-27725-1-ND (http://www.digikey.com/product-detail/en/texas-instruments/TMP101NA-3K/296-27725-1-ND/2356441)
 | 1 | ACS758LCB | ACS758LCB | CB5PIN | U5 |  | Allegro | ACS758LCB-100U-PFF-T | Digikey | 620-1354-ND
 | 4 | ESDA6V1SC6Y | ESDA6V1SC6Y | SOT23-6 | U6,7,8,9 |  | STMicro | ESDA6V1SC6Y | Digikey | 497-13409-1-ND
 | 3 | UCC27211A-Q1 | UCC27211A-Q1 | SOIC-8-EP | U10,11,12 |  | TI | UCC27211AQDDARQ1 (http://www.digikey.com/product-detail/en/texas-instruments/UCC27211AQDDARQ1/296-43737-1-ND/5825160) | Digikey | 296-43737-1-ND (http://www.digikey.com/product-detail/en/texas-instruments/UCC27211AQDDARQ1/296-43737-1-ND/5825160)
 | 1 | MTI85W100GC | MTI85W100GC | ISOPLUS-DIL | U13 |  | IXYS | MTI85W100GC | Mouser | 747-MTI85W100GC
