Tommydag/BLDC-Motor-Controller/(list of files, cad)

Other CAD files:
PCBs/Projects/MotorController/CAM/RevAFiles/Output2ForQuote/motorcon_fab.DWG
