Tommydag/BLDC-Motor-Controller/Documentation/Datasheets/CY8CKIT-059_Assembly.pdf

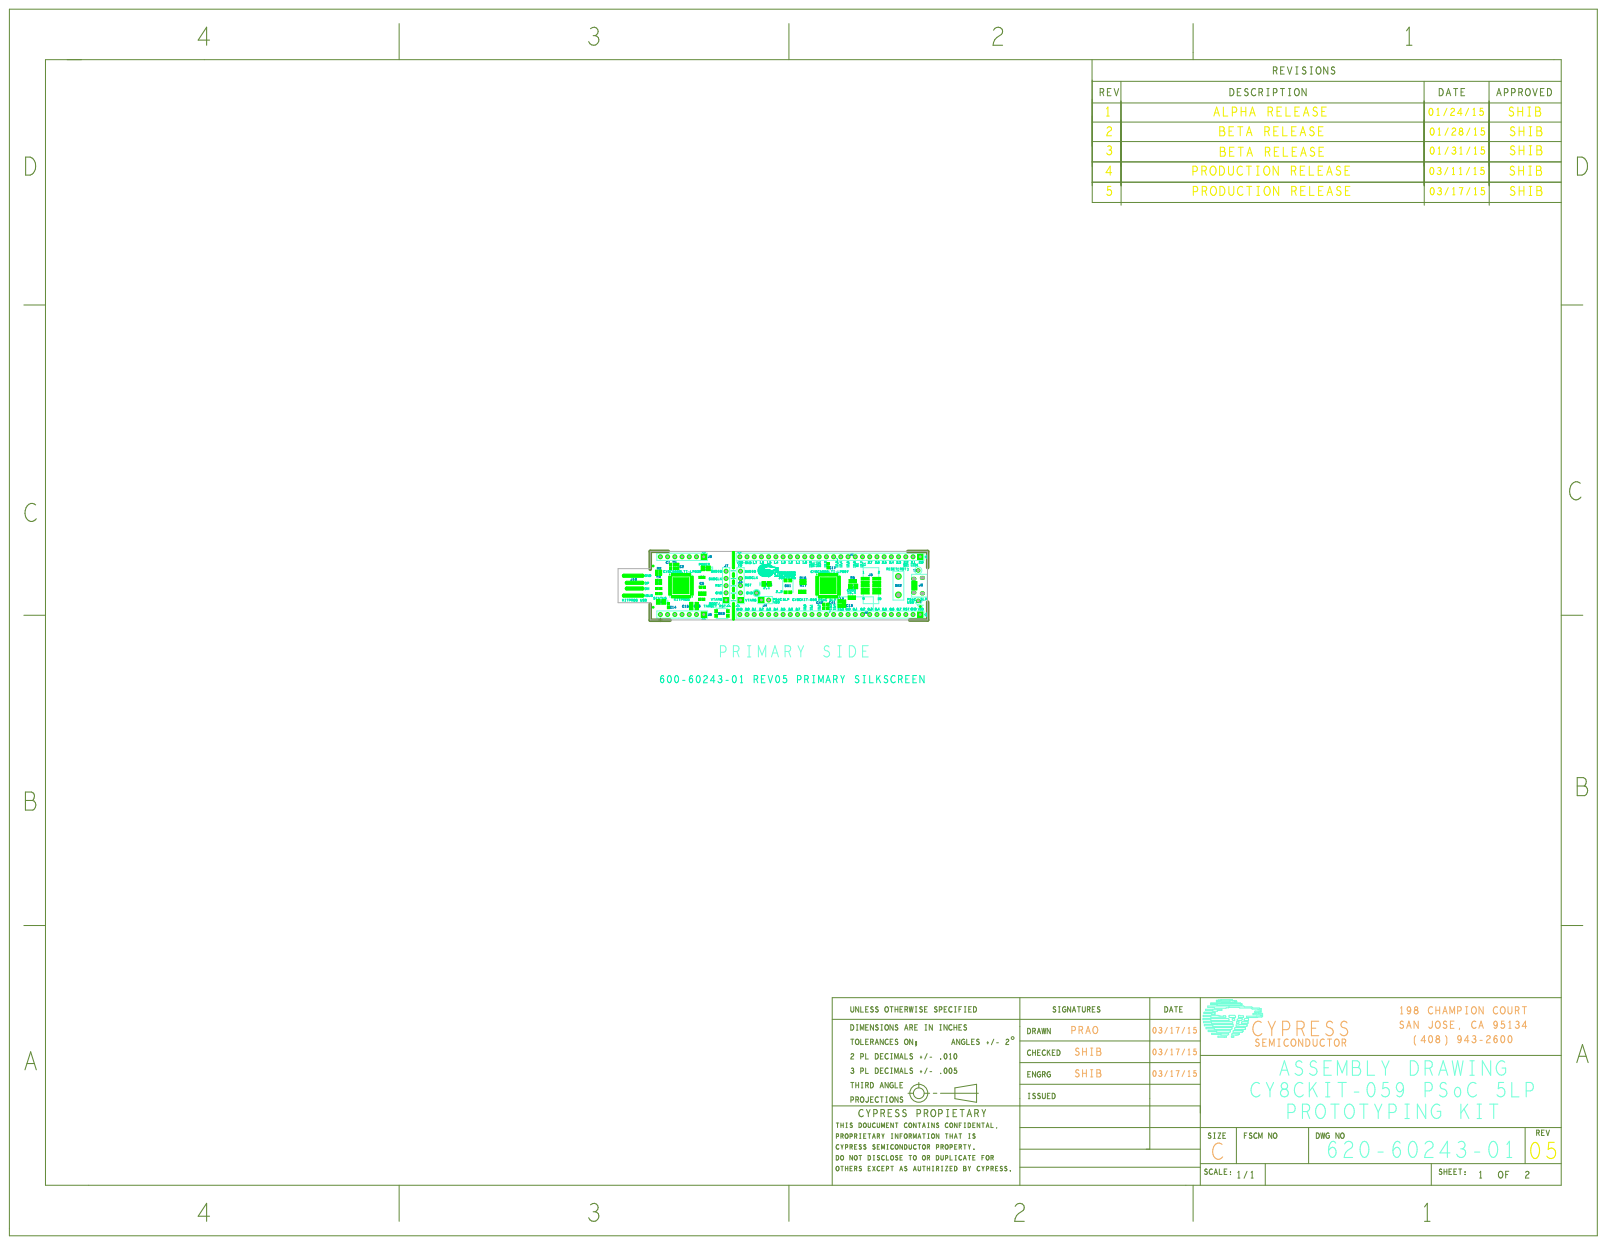
[picture p4: page 1]

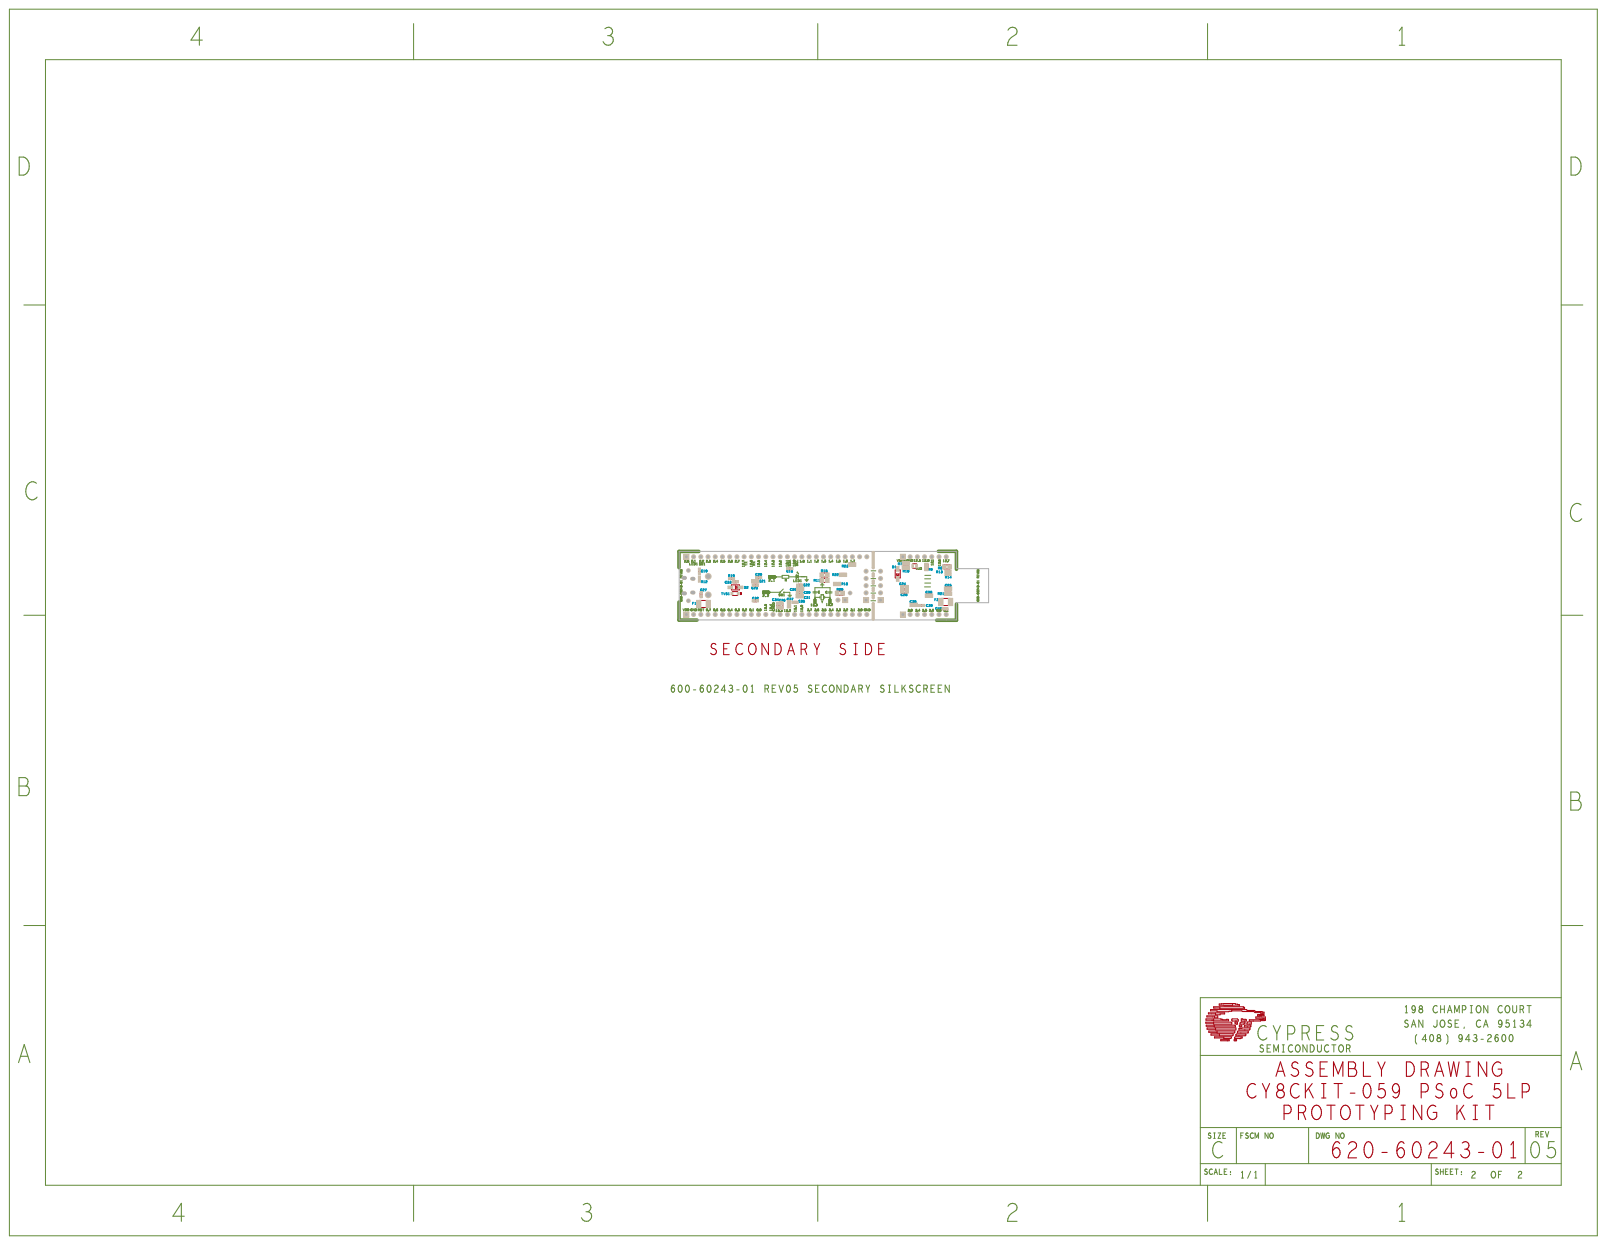
[picture p5: page 2]
