Tommydag/BLDC-Motor-Controller/PCBs/Projects/MotorController/CAM/RevAFiles/Output2ForQuote/freeDFMresult.pdf

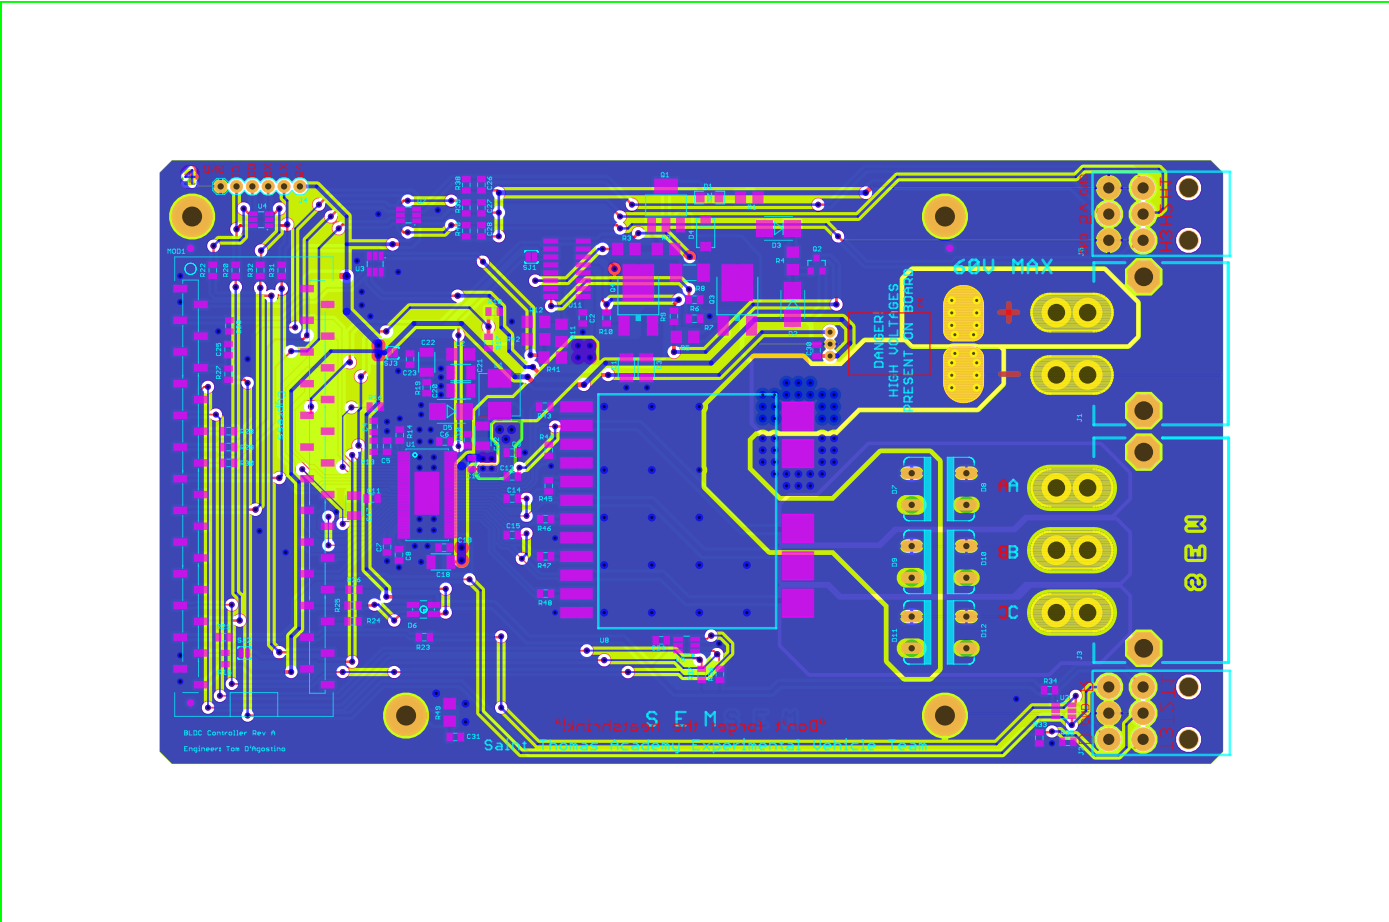
[picture p6: page 1]
