Tommydag/BLDC-Motor-Controller/Documentation/RevB Documents/revB_schematic.pdf

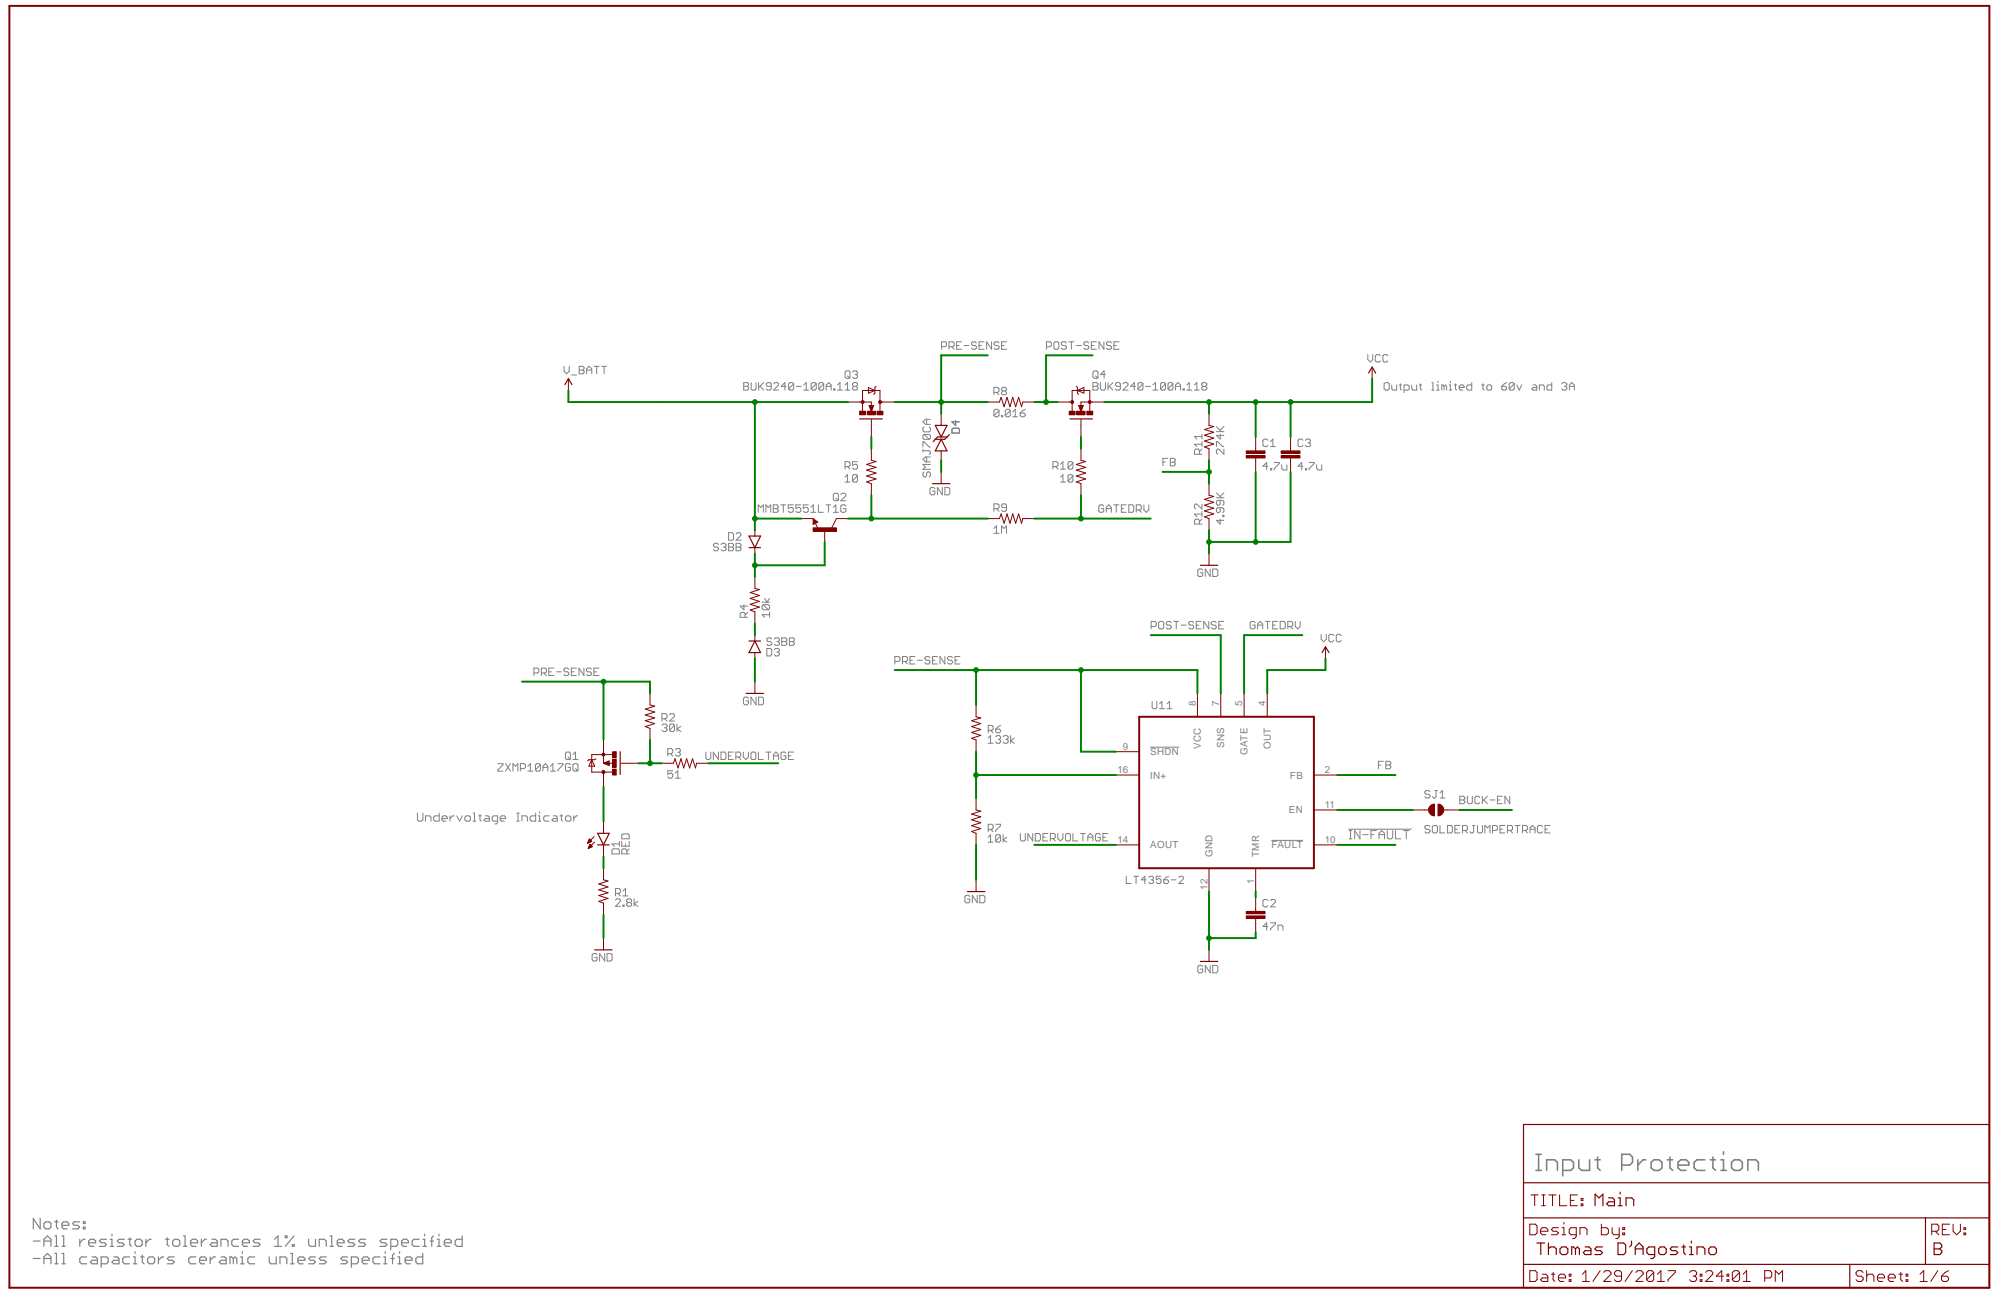
[picture p7: page 1]
SHDN 9; AOUT 14; FAULT; GND 12; TMR; VCC; SNS; GATE; OUT

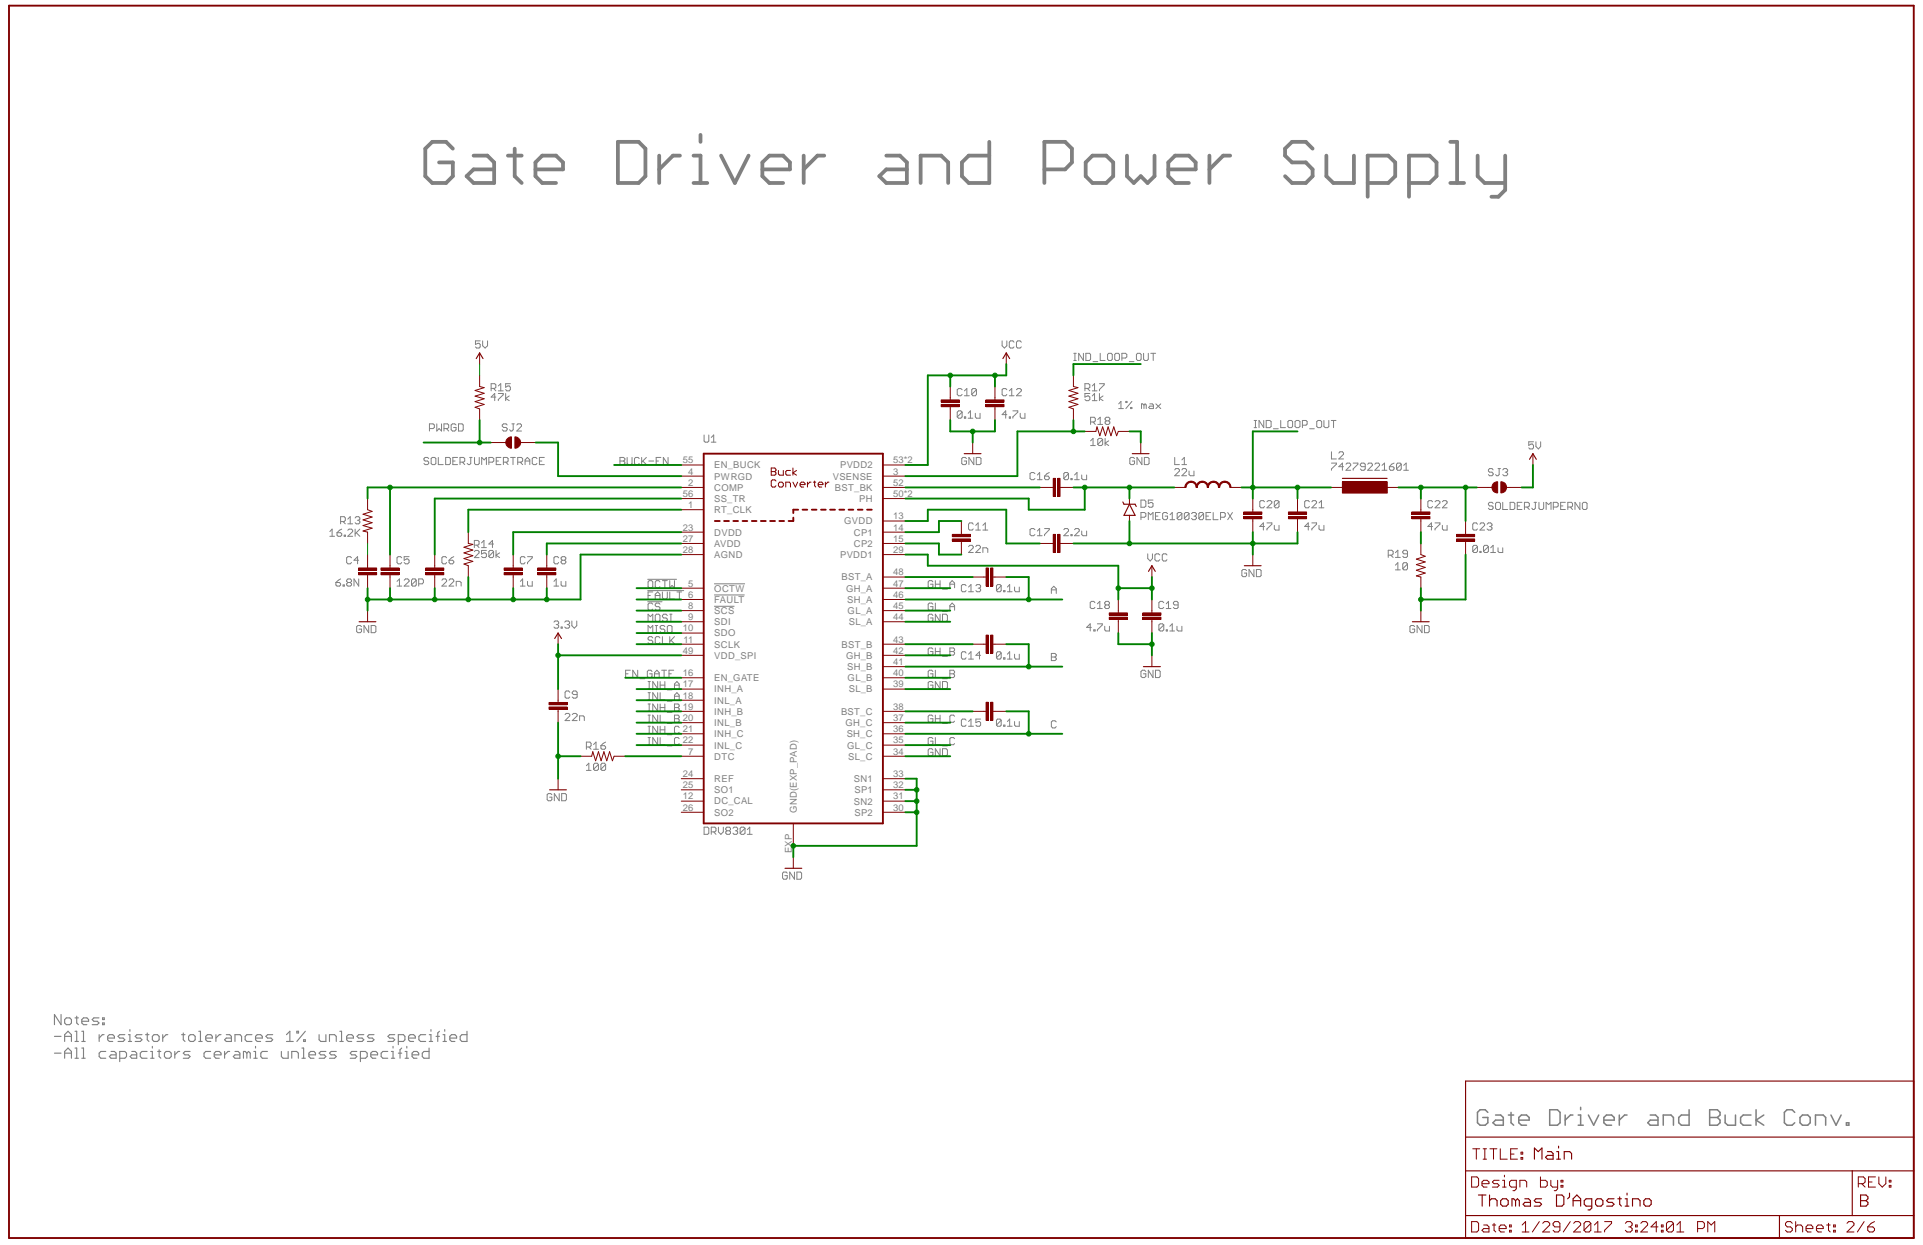
[picture p8: page 2]
RT_CLK; COMP; VSENSE; PWRGD; OCTW; FAULT; DTC; SCS; SDO 10; SDI 9; SCLK 11; DC_CAL 12; GVDD; INH_A 17; EN_GATE 16; INL_A 18; INL_C 22; INH_C 21; DVDD 23; REF 24 SO1 25; AVDD 27; AGND 28; PVDD1; 37 BST_C; 42 BST_B; 47 BST_A; VDD_SPI 49; 50*2 BST_BK; PVDD2; 53*2 EN_BUCK 55; GND(EXP_PAD) EXP

INH_B 19
INL_B 20

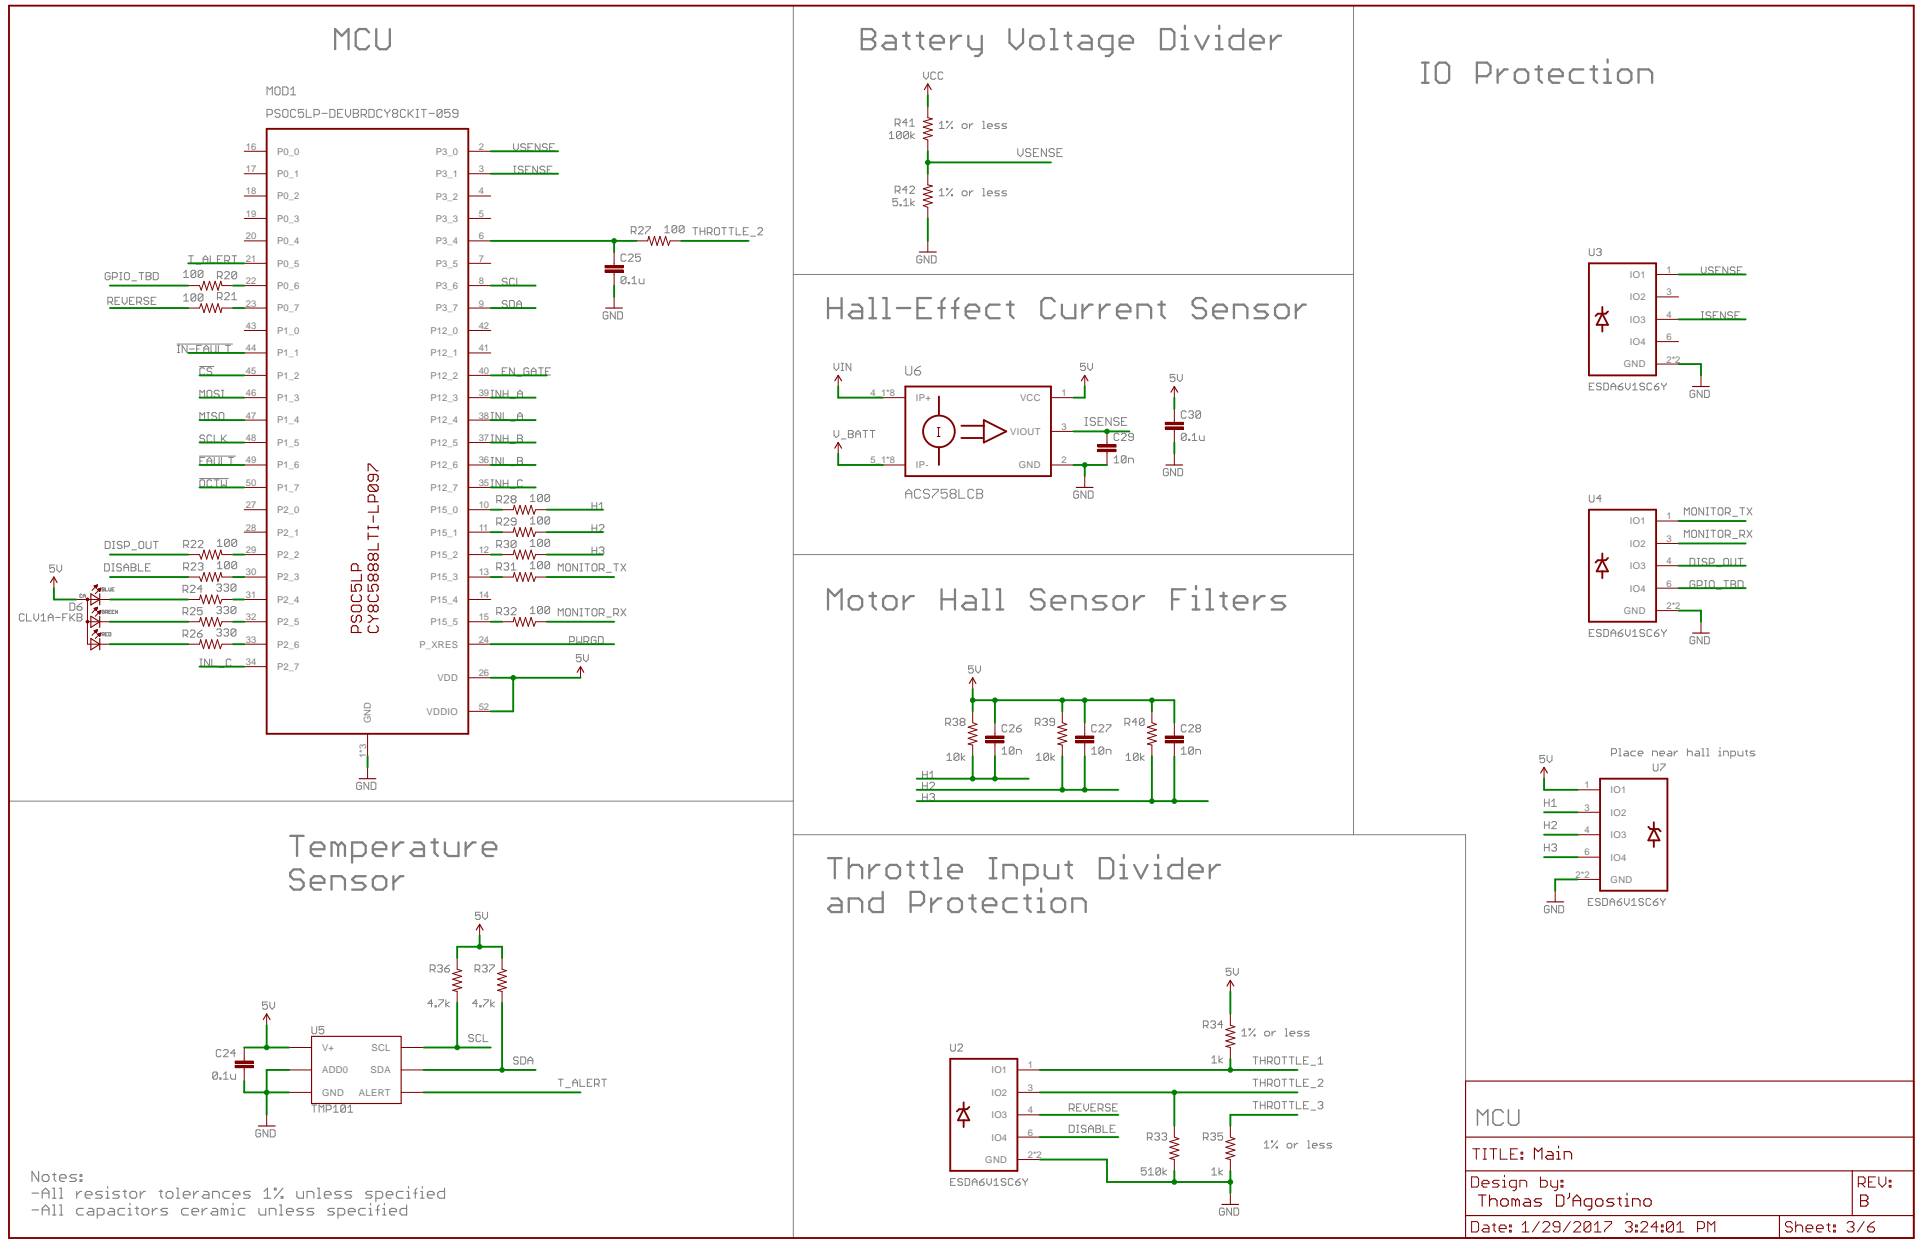
[picture p9: page 3]
GND; SCL; ADD0; SDA; ALERT; VCC; VIOUT; GND 1*3; P_XRES; VDD; VDDIO

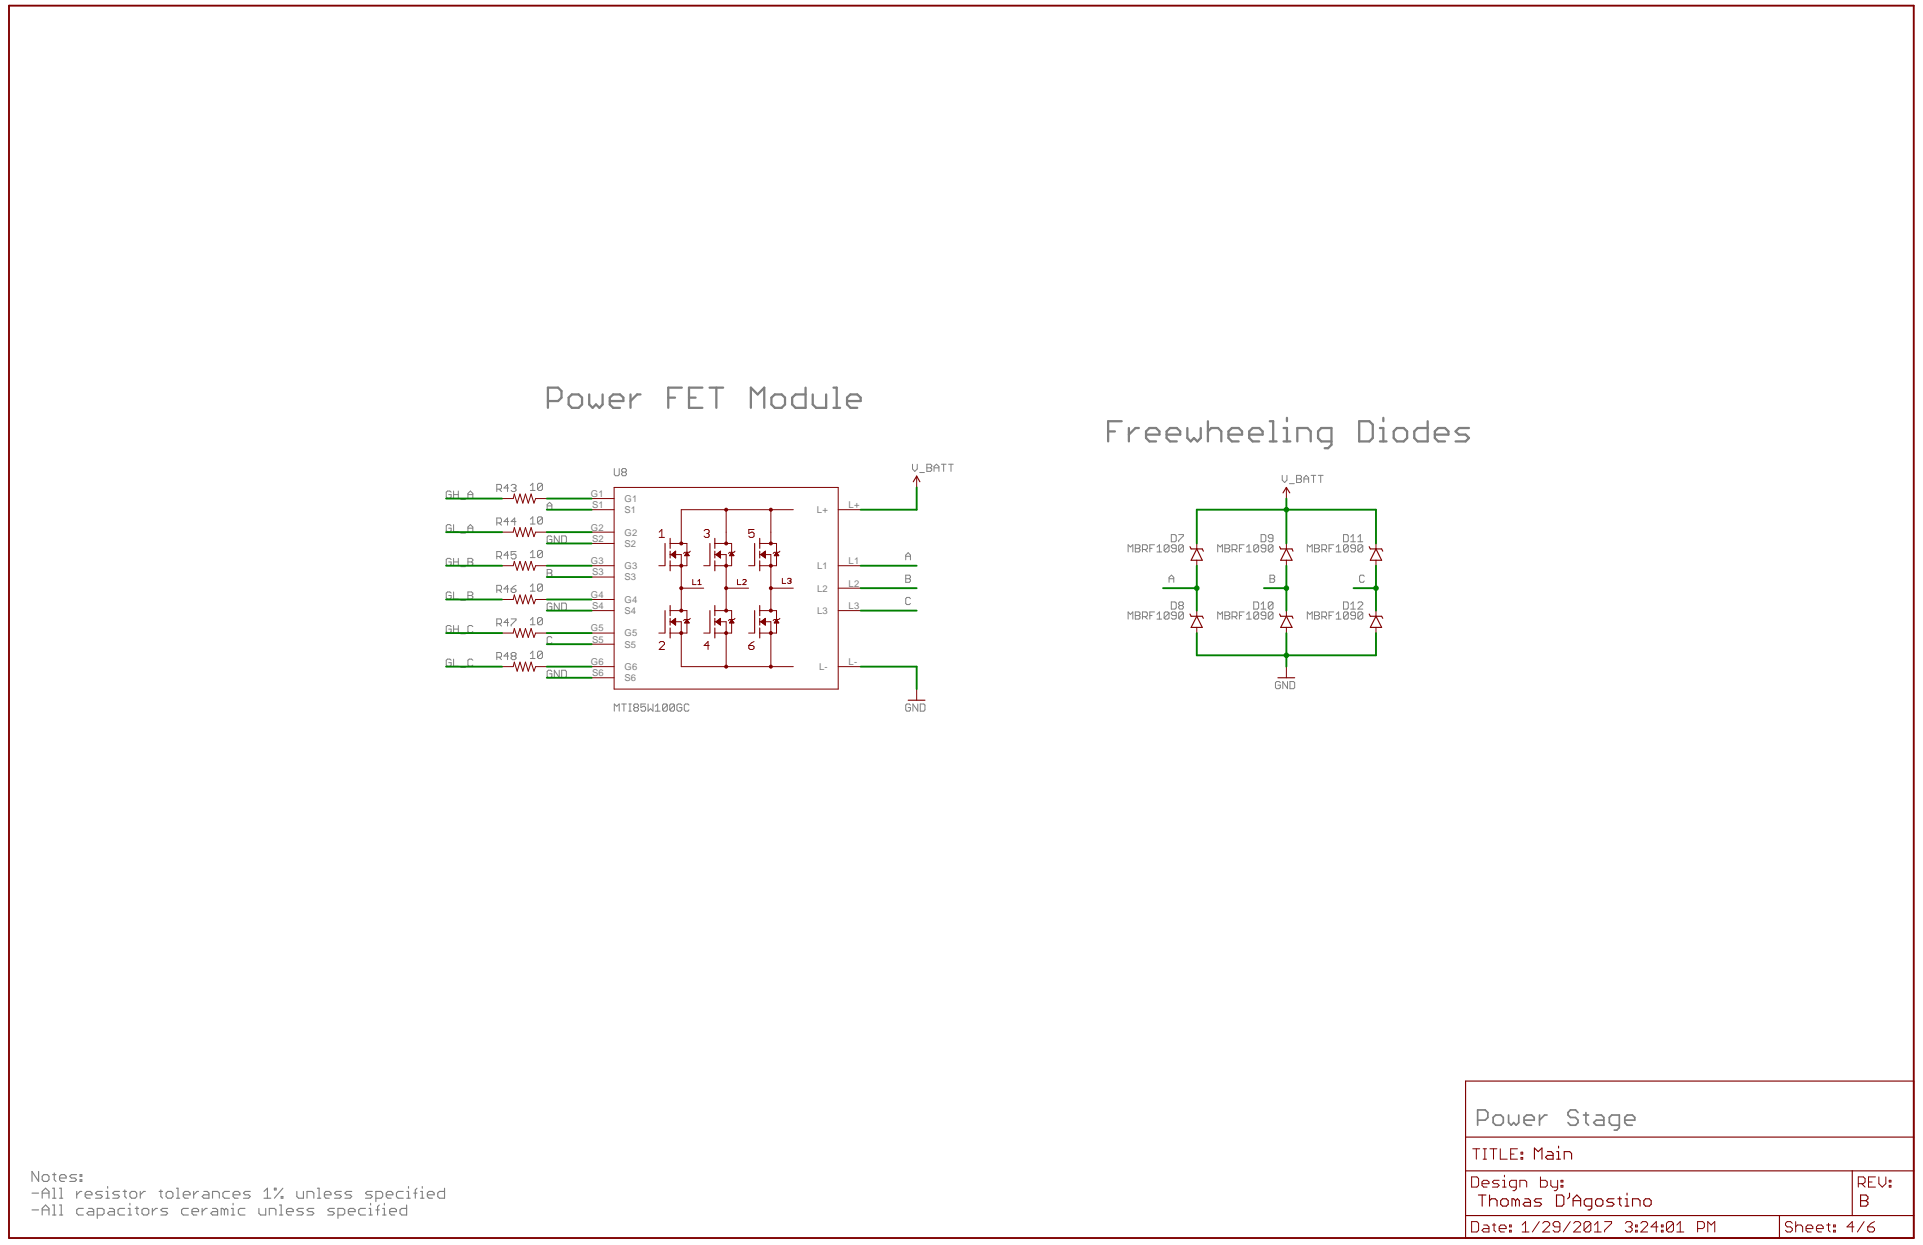
[picture p10: page 4]

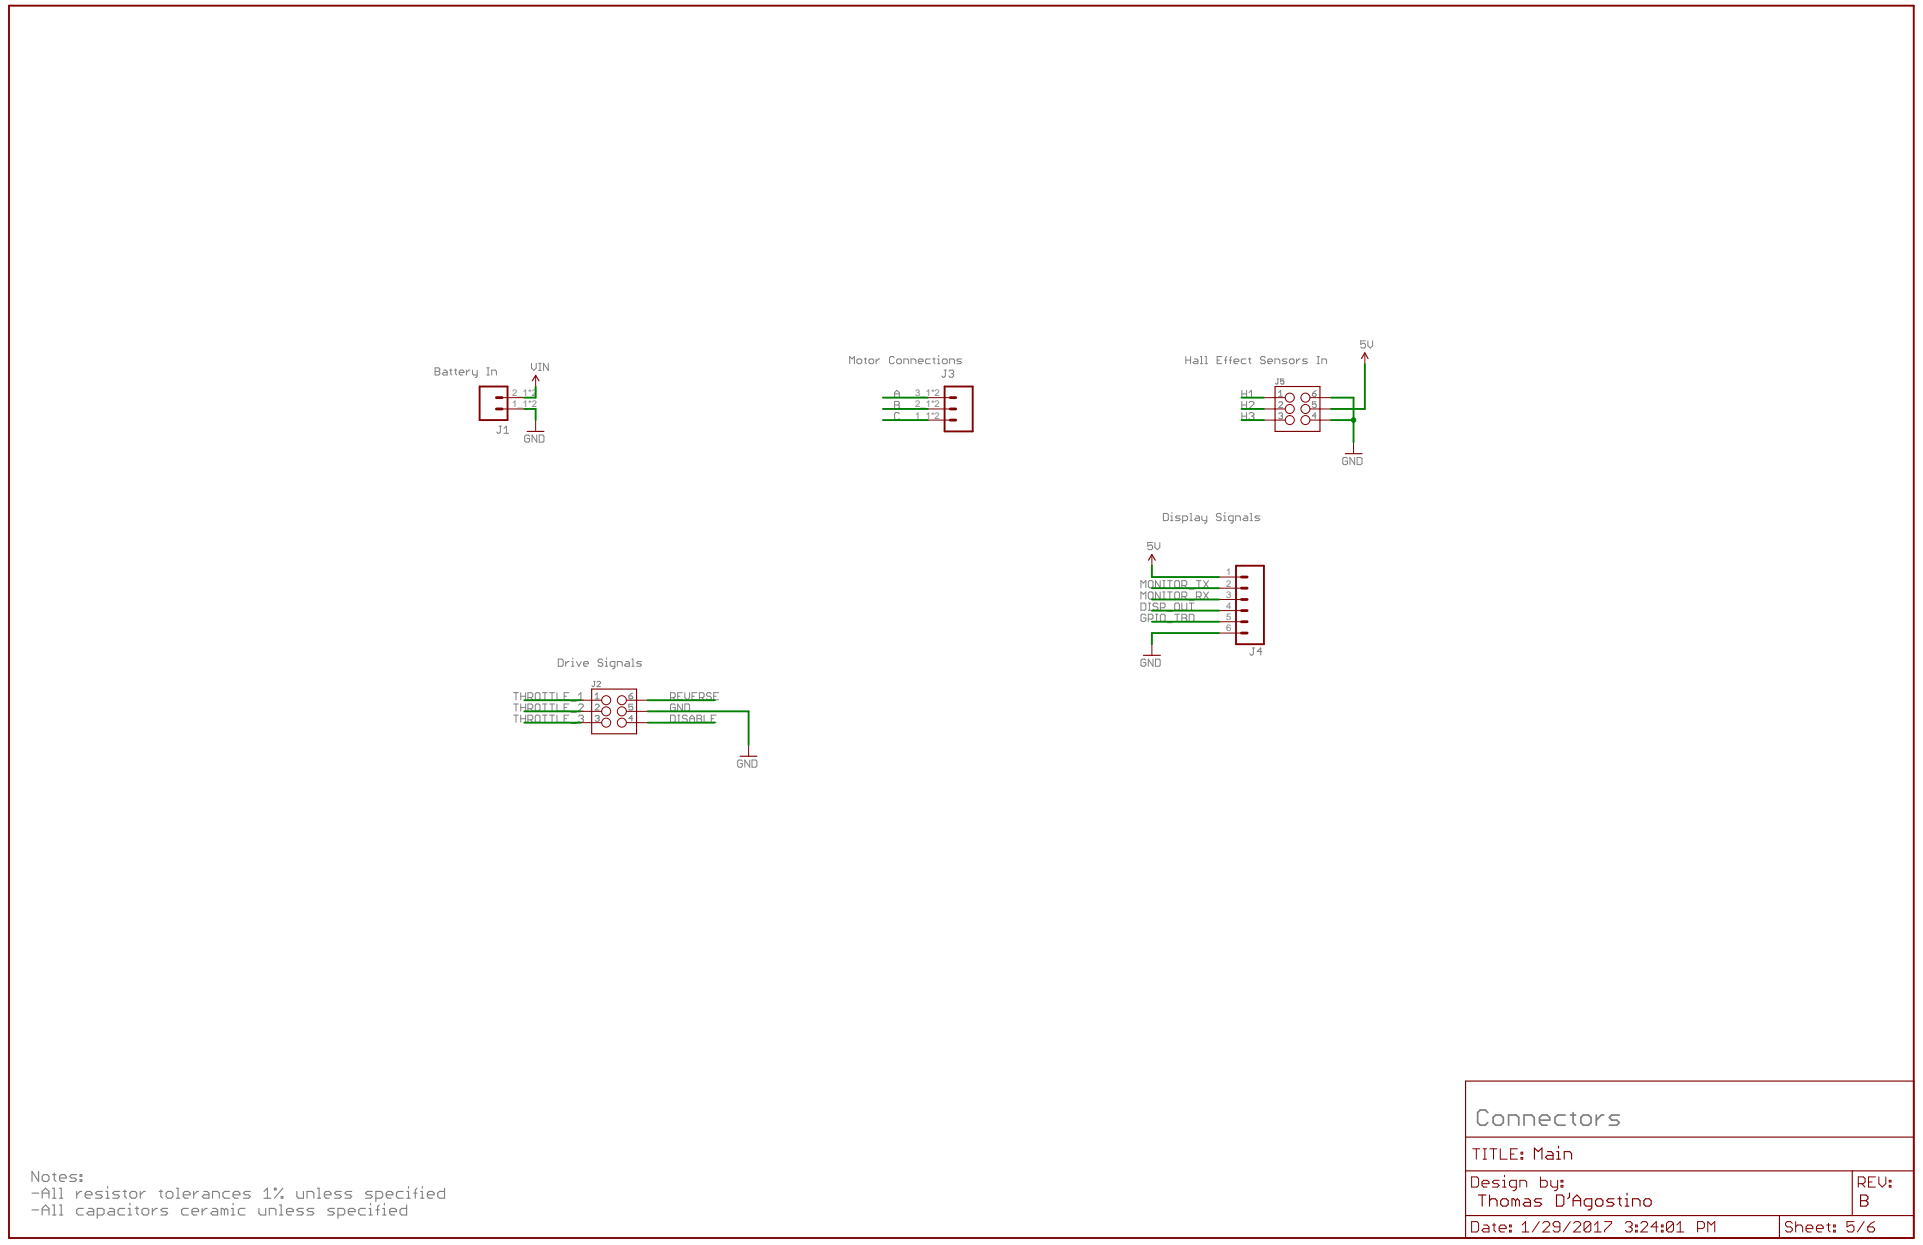
[picture p11: page 5]

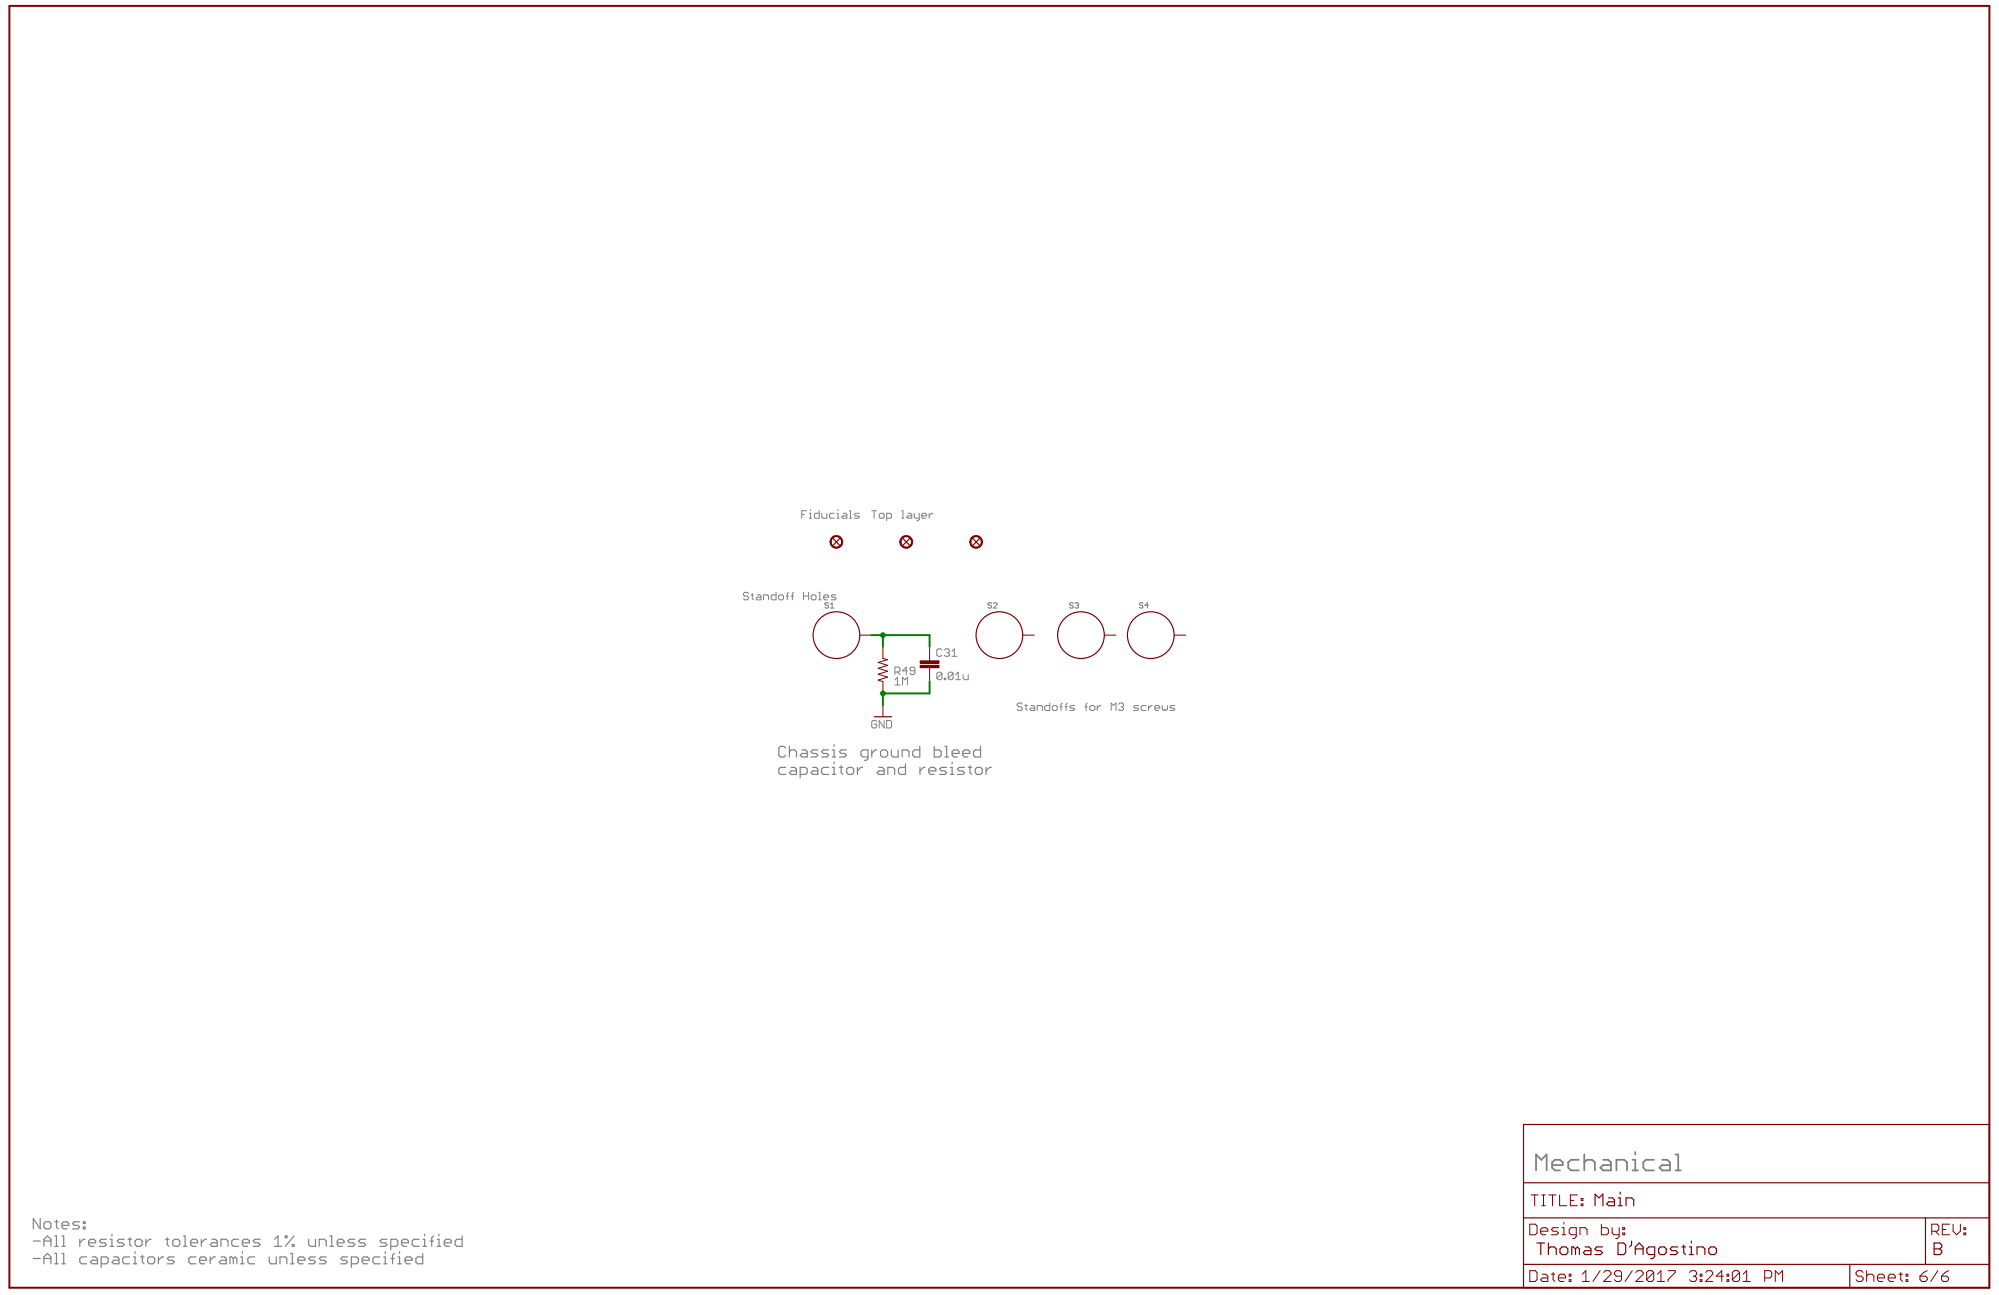
[picture p12: page 6]
