Tommydag/BLDC-Motor-Controller/Documentation/RevB Documents/revB_board.pdf

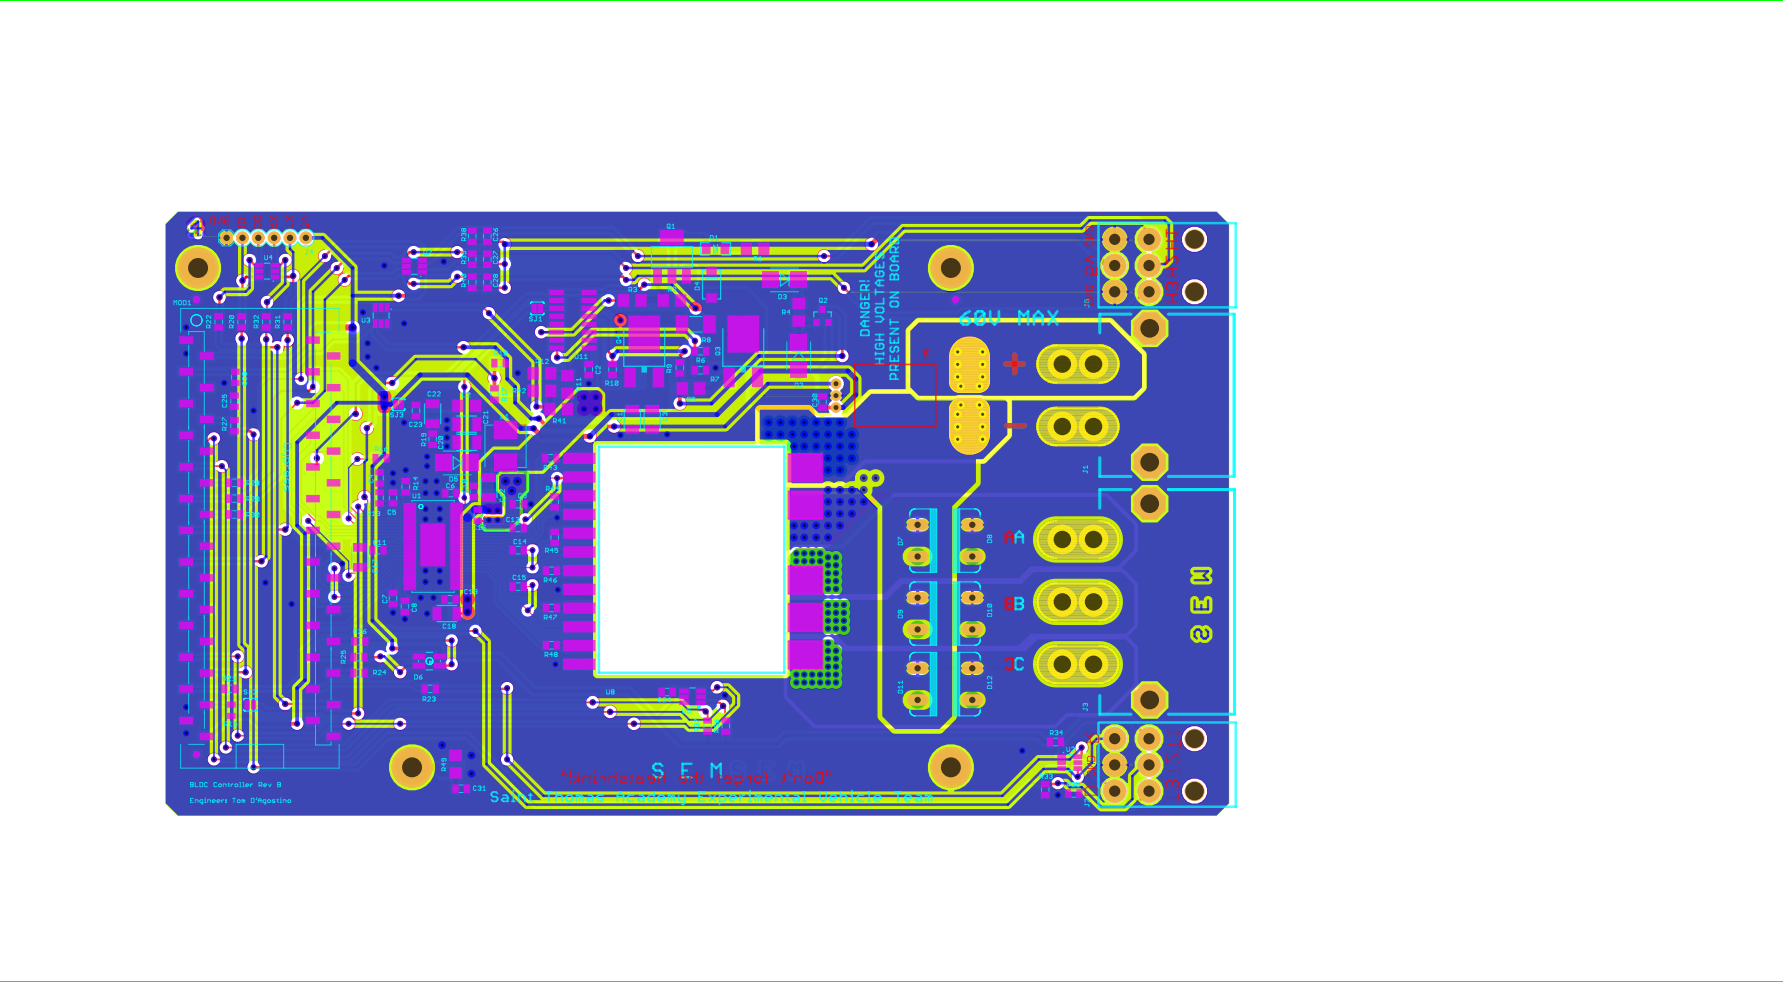
[picture p13: page 1]
