Tommydag/BLDC-Motor-Controller/Documentation/RevC Documents/PSU/revCpsu_LTSPICE.asc

C1: cap; 0.47µ; V=100 Irms=2.1 Rser=0.0501362 Lser=0 mfg="KEMET" pn="C1812C474K1RAC" type="X7R"
C2: cap; 4.7µ; V=25 Irms=0 Rser=0.003365 Lser=0.797504f mfg="Wuerth Elektronik" pn="885012208068 WCAP-CSGP 1206" type="X7R"
C3: cap; 0.0056µ; V=25 Irms=293m Rser=0.574834 Lser=0 mfg="KEMET" pn="C1210C562K3RAC" type="X7R"
C4: cap; 0.001µ; V=100 Irms=83.8m Rser=2.70485 Lser=0 mfg="KEMET" pn="C0805C102K1RAC" type="X7R"
C5: cap; 10µ; V=10 Irms=0 Rser=0.002889 Lser=0.748357f mfg="Wuerth Elektronik" pn="885012208018 WCAP-CSGP 1206" type="X7R"
C6: cap; .1µ
C7: cap; 1µ; V=18 Irms=1.78 Rser=0.0675534 Lser=0
C9: cap; 2.2µ
CfbBot1: cap; {CfbBot1}
CfbTop1: cap; {CfbTop1}
Cinb1: polcap; 4.7µ; x{nCinb1}; V=63 Irms=1.73205 Rser=0.075 Lser=0 mfg="KEMET" pn="T521D475M063ATE075" type="Tantalum"
Cinc1: cap; {Cinc1}; x{nCinc1}
Cob1: polcap; {Cob1}; x{nCob1}; Rser={ESRb1} Lser={ESLb1}
Coc1: cap; {Coc1}; x{nCoc1}; Rser={ESRc1} Lser={ESLc1}
I1: current; PULSE(50u 140m 2.865m 50u 100u 3 6); load
L1: ind; 1.0µ; Rser=0.05 Cpar=100p
Lo1: ind; {Lo1}; Rser={DCR1}
LoadStep1: current; PULSE(0 1.5 1.5m 100n 100n 1u 33.3u)
LoadStep2: current; PULSE(0 1.5 1.543m 100n 100n 1u 33.3u)
R1: res; 100k
R2: res; 10
R3: res; 1
R4: res; 2
R5: res; 140k
R6: res; 124k
R7: res; 10k
R8: res; 140k
R9: res; 10k
R10: res; 0.01
R11: res; 0.001
R12: res; 49.9k
R13: res; 604
R14: res; 40
RfbBot1: res; {RfbBot1}
RfbTop1: res; {RfbTop1}
Rfreq_1: res; 25.5k
U1: LT8631
U2: LT3045
Vin1: voltage; PULSE(0 52 25n 100n 0 2 5); Rser=0.01 Cpar=9u
Named nets: 0, IN, OUT1, OUT2, 15v_pg, 5vout, pgfb_node, setnode
parameter imported from LTPowerCAD Design Tool:
.tran 0 6.5m 0 100n startup
Note: Simulation is running at the default switching frequency for the part.
Please manually adjust for additional switching frequency options.
.params Vin1=50 Cinb1=4.7u CinbESR1=20m nCinb1=1 Cinc1=2.2u CincESR1=7m nCinc1=1 fsw1=397k  
.params RfbTop1=1000k RfbBot1=57.6k CfbTop1=200p CfbBot1=0p  
.params Rth1=0k Cth1=0p Cthp1=0p  
.params SenseRs1=0k SenseC1=0u SenseRp1=0k  
.params Rsense1=25m RsenseFilterR1=0 RsenseFilterC1=0n  
.params Lo1=22u DCR1=150m  
.params Cob1=47u ESRb1=5m ESLb1=0.2n nCob1=1  
.params Coc1=47u ESRc1=5m ESLc1=0.2n nCoc1=1  
.params Rfreq_1=25.5k Rfreq2_1=0k  
.params LoadStepHigh1=0.3 LoadStepLow1=0
