Tommydag/BLDC-Motor-Controller/PCBs/Projects/MotorController/Main.brd

## EAGLE design PCBs/Projects/MotorController/Main.brd (2017-03-16)

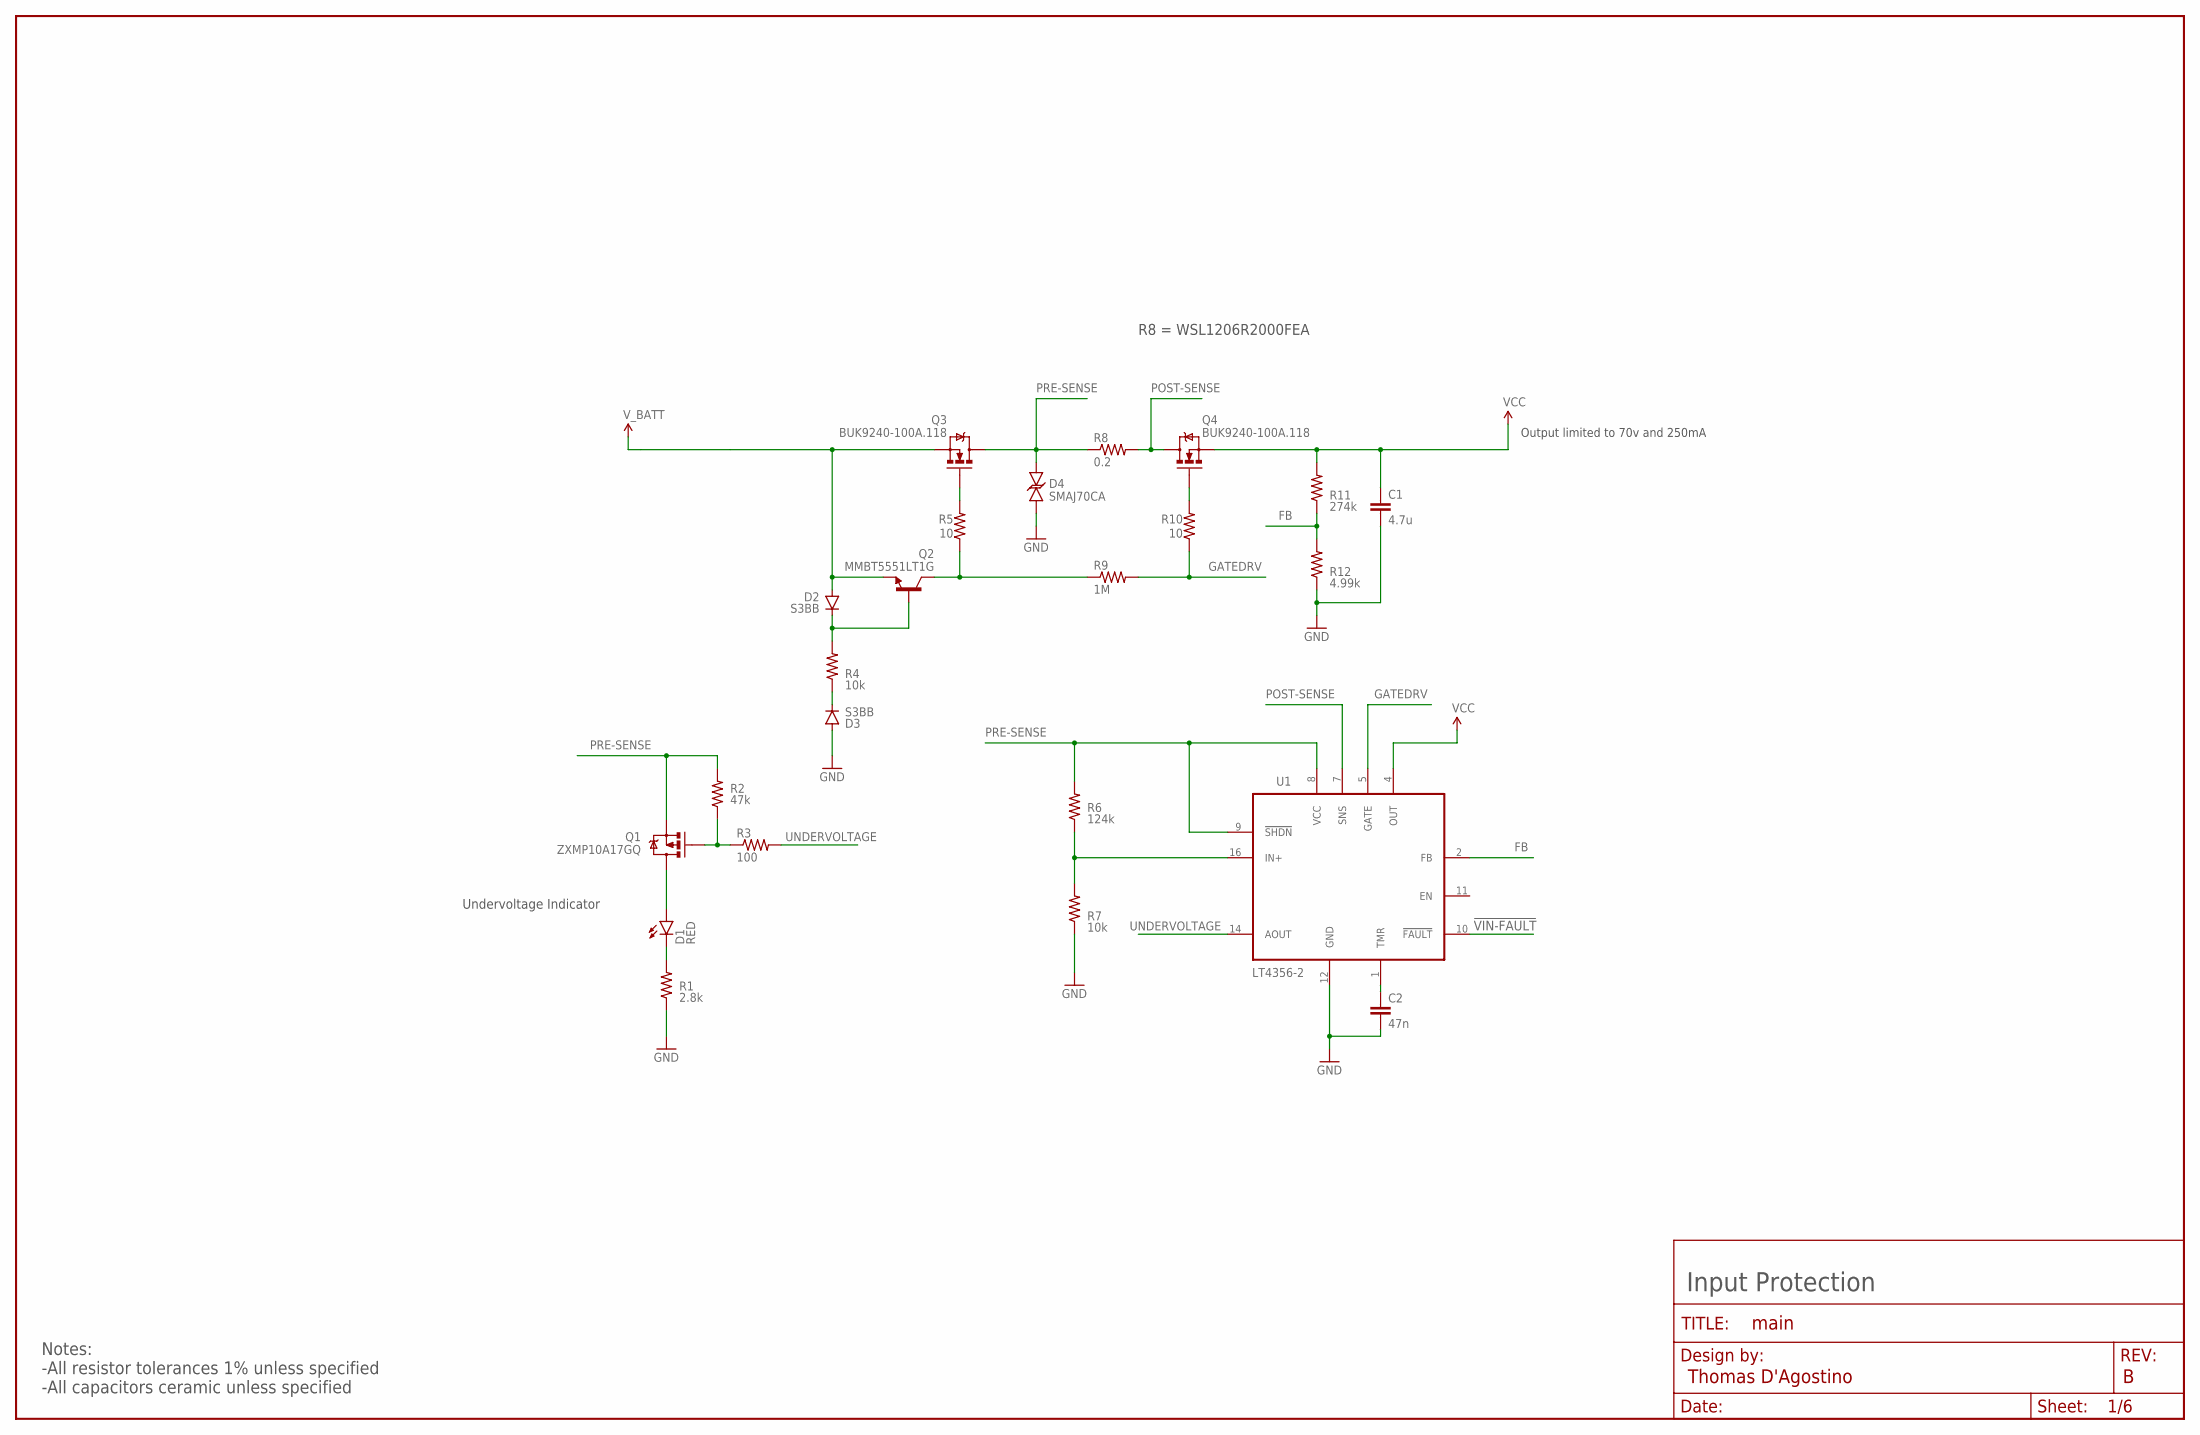
[picture p14: schematic Main.sch, sheet 1, Control Input Protection]

Parts:
C1: 4.7u; 1210
C2: 47n; 0805
D1: RED; LED-1206
D2, D3: S3BB; SMB-DIODE
D4: SMAJ70CA; SMA-DIODE-BI
FRAME1: FRAME-LEDGER; CREATIVE_COMMONS
Q1: ZXMP10A17GQ; SOT223
Q2: MMBT5551LT1G; SOT23-3
Q3, Q4: BUK9240-100A.118; DPAK
R1: 2.8k; 1206
R2: 47k; 0805
R3: 100; 0805
R4, R7: 10k; 0805
R5, R10: 10; 0805
R6: 124k; 0805
R8: 0.2; 1206
R9: 1M; 0805
R11: 274k; 0805
R12: 4.99k; 0805
U1: LT4356-2; SOIC-16

Connections:
!VIN-FAULT: U1.10 (!FAULT); also elsewhere on the board
FB: R11.1, R12.2, U1.2 (FB)
GATEDRV: R9.2, R10.1, U1.5 (GATE)
GND: C1.2, C2.2, D3.A, D4.A, R1.1, R7.1, R12.1, U1.12 (GND); also elsewhere on the board
unnamed: C2.1, U1.1 (TMR)
unnamed: D1.C, R1.2
unnamed: Q3.1 (G), R5.2
unnamed: D2.C, Q2.1 (B), R4.2
unnamed: Q4.1 (G), R10.2
unnamed: R6.1, R7.2, U1.16 (IN+)
unnamed: Q1.1 (G), R2.1, R3.1
unnamed: Q2.3 (C), R5.1, R9.1
unnamed: D1.A, Q1.2 (D), Q1.4 (D)
unnamed: D3.C, R4.1
POST-SENSE: Q4.4 (D), R8.2, U1.7 (SNS)
PRE-SENSE: D4.C, Q1.3 (S), Q3.4 (D), R2.2, R6.2, R8.1, U1.8 (VCC), U1.9 (!SHDN)
UNDERVOLTAGE: R3.2, U1.14 (AOUT)
VCC: C1.1, Q4.3 (S), R11.2, U1.4 (OUT); also elsewhere on the board
V_BATT: D2.A, Q2.2 (E), Q3.3 (S); also elsewhere on the board

Notes on the sheet:
Output limited to 70v and 250mA
Undervoltage Indicator
Input Protection
Notes: -All resistor tolerances 1% unless specified -All capacitors ceramic unless specified
R8 = WSL1206R2000FEA

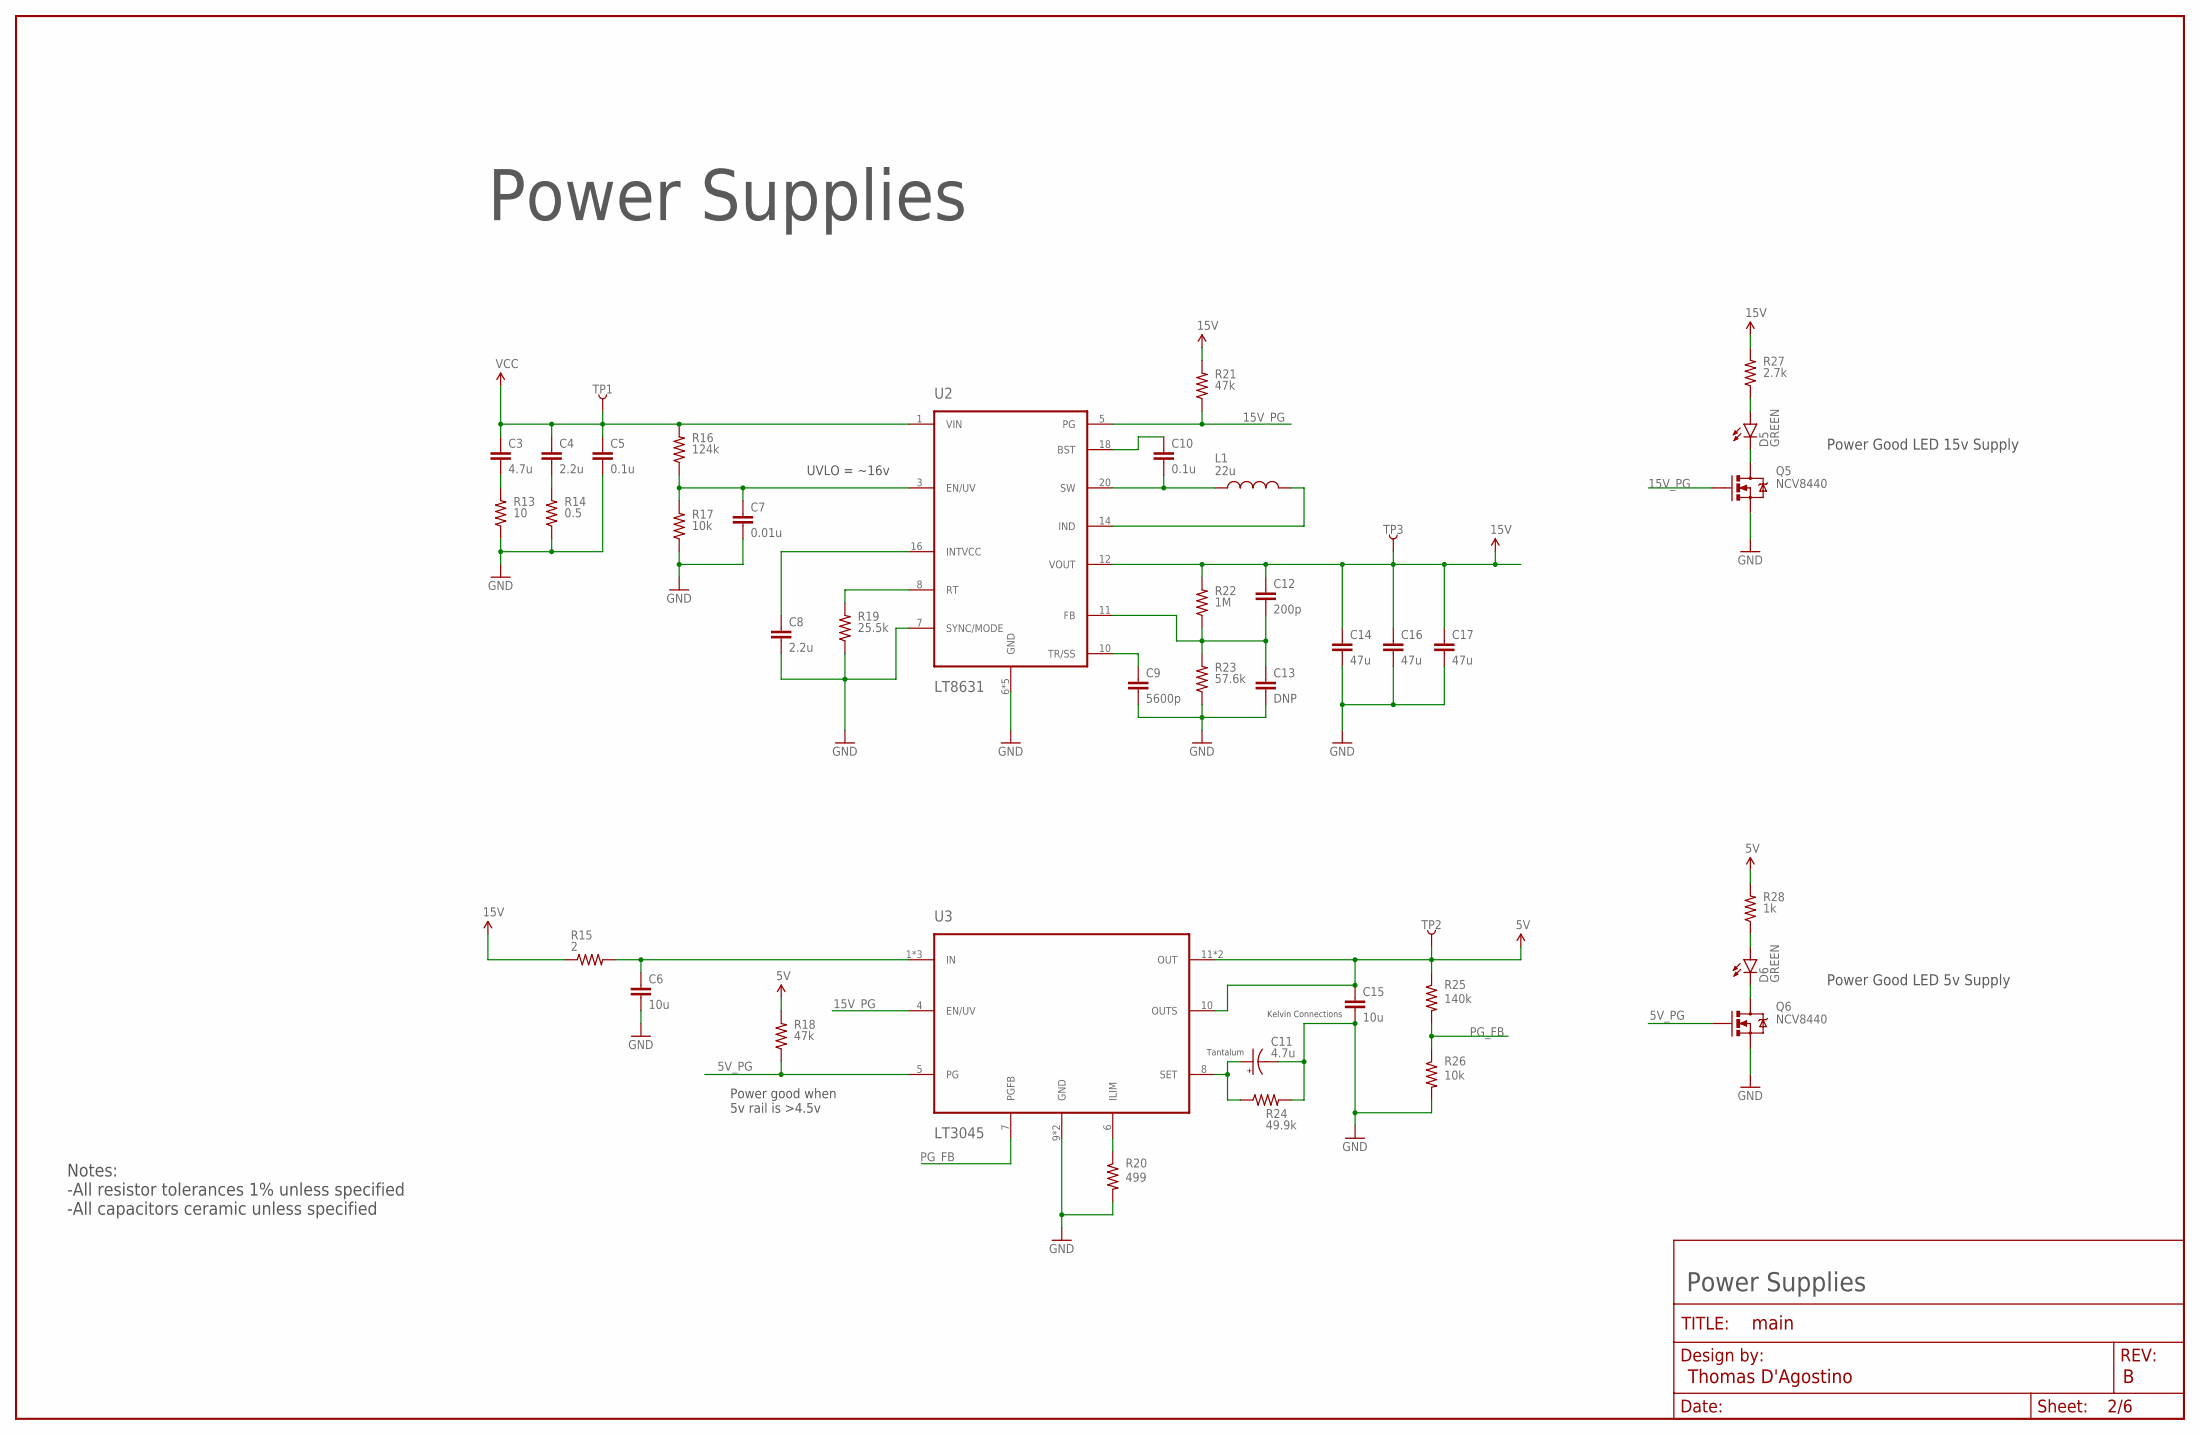
[picture p15: schematic Main.sch, sheet 2, Power Supply]

Parts:
C3: 4.7u; 1210
C4: 2.2u; 1210
C5, C10: 0.1u; 0805
C6, C15: 10u; 1210
C7: 0.01u; 0805
C8: 2.2u; 0805
C9: 5600p; 0805
C11: 4.7u; EIA3216
C12: 200p; 0805
C13: DNP; 0805
C14, C16, C17: 47u; 1210
D5, D6: GREEN; LED-1206
FRAME2: FRAME-LEDGER; CREATIVE_COMMONS
L1: 22u; IND_SMD_SRP7050TA
Q5, Q6: NCV8440; SOT223
R13: 10; 0805
R14: 0.5; 0805
R15: 2; 1206
R16: 124k; 0805
R17, R26: 10k; 0805
R18, R21: 47k; 0805
R19: 25.5k; 0805
R20: 499; 0805
R22: 1M; 0805
R23: 57.6k; 0805
R24: 49.9k; 0805
R25: 140k; 0805
R27: 2.7k; 0805
R28: 1k; 0805
TP1, TP2, TP3: TEST-POINTRCT-0C; TEST-POINT-MINI
U2: LT8631; TSSOP-20-FE
U3: LT3045; MSOP-12-EP

Connections:
5V: C15.1, R18.2, R25.1, R28.2, TP2.P$1, U3.10 (OUTS), U3.11 (OUT), U3.12 (OUT); also elsewhere on the board
5V_PG: Q6.1 (G), R18.1, U3.5 (PG)
5V_SET_CONNECTION: C11.A (+), R24.1, U3.8 (SET)
15V: C12.1, C14.1, C16.1, C17.1, R15.1, R21.2, R22.2, R27.2, TP3.P$1, U2.12 (VOUT); also elsewhere on the board
15V_PG: Q5.1 (G), R21.1, U2.5 (PG), U3.4 (EN/UV)
GND: C5.2, C6.2, C7.2, C8.2, C9.2, C11.C (-), C13.2, C14.2, C15.2, C16.2, C17.2, Q5.3 (S), Q6.3 (S), R13.1, R14.1, R17.1, R19.1, R20.2, R23.1, R24.2, R26.2, U2.6 (GND), U2.7 (SYNC/MODE), U2.9 (GND), U2.13 (GND), U2.15 (GND), U2.EXP (GND), U3.9 (GND), U3.EXP (GND); also elsewhere on the board
ILIMIT_5V: R20.1, U3.6 (ILIM)
unnamed: C10.2, L1.P$1 (1), U2.20 (SW)
unnamed: L1.P$2 (2), U2.14 (IND)
unnamed: C10.1, U2.18 (BST)
unnamed: C7.1, R16.1, R17.2, U2.3 (EN/UV)
unnamed: C8.1, U2.16 (INTVCC)
unnamed: R19.2, U2.8 (RT)
unnamed: C9.1, U2.10 (TR/SS)
unnamed: C12.2, C13.1, R22.1, R23.2, U2.11 (FB)
unnamed: C6.1, R15.2, U3.1 (IN), U3.2 (IN), U3.3 (IN)
unnamed: C3.2, R13.2
unnamed: C4.2, R14.2
unnamed: D5.C, Q5.2 (D), Q5.4 (D)
unnamed: D5.A, R27.1
unnamed: D6.A, R28.1
unnamed: D6.C, Q6.2 (D), Q6.4 (D)
PG_FB: R25.2, R26.1, U3.7 (PGFB)
VCC: C3.1, C4.1, C5.1, R16.2, TP1.P$1, U2.1 (VIN); also elsewhere on the board

Notes on the sheet:
Power Supplies
Notes: -All resistor tolerances 1% unless specified -All capacitors ceramic unless specified
UVLO = ~16v
Kelvin Connections
Power good when 5v rail is >4.5v
Tantalum
Power Good LED 15v Supply
Power Good LED 5v Supply

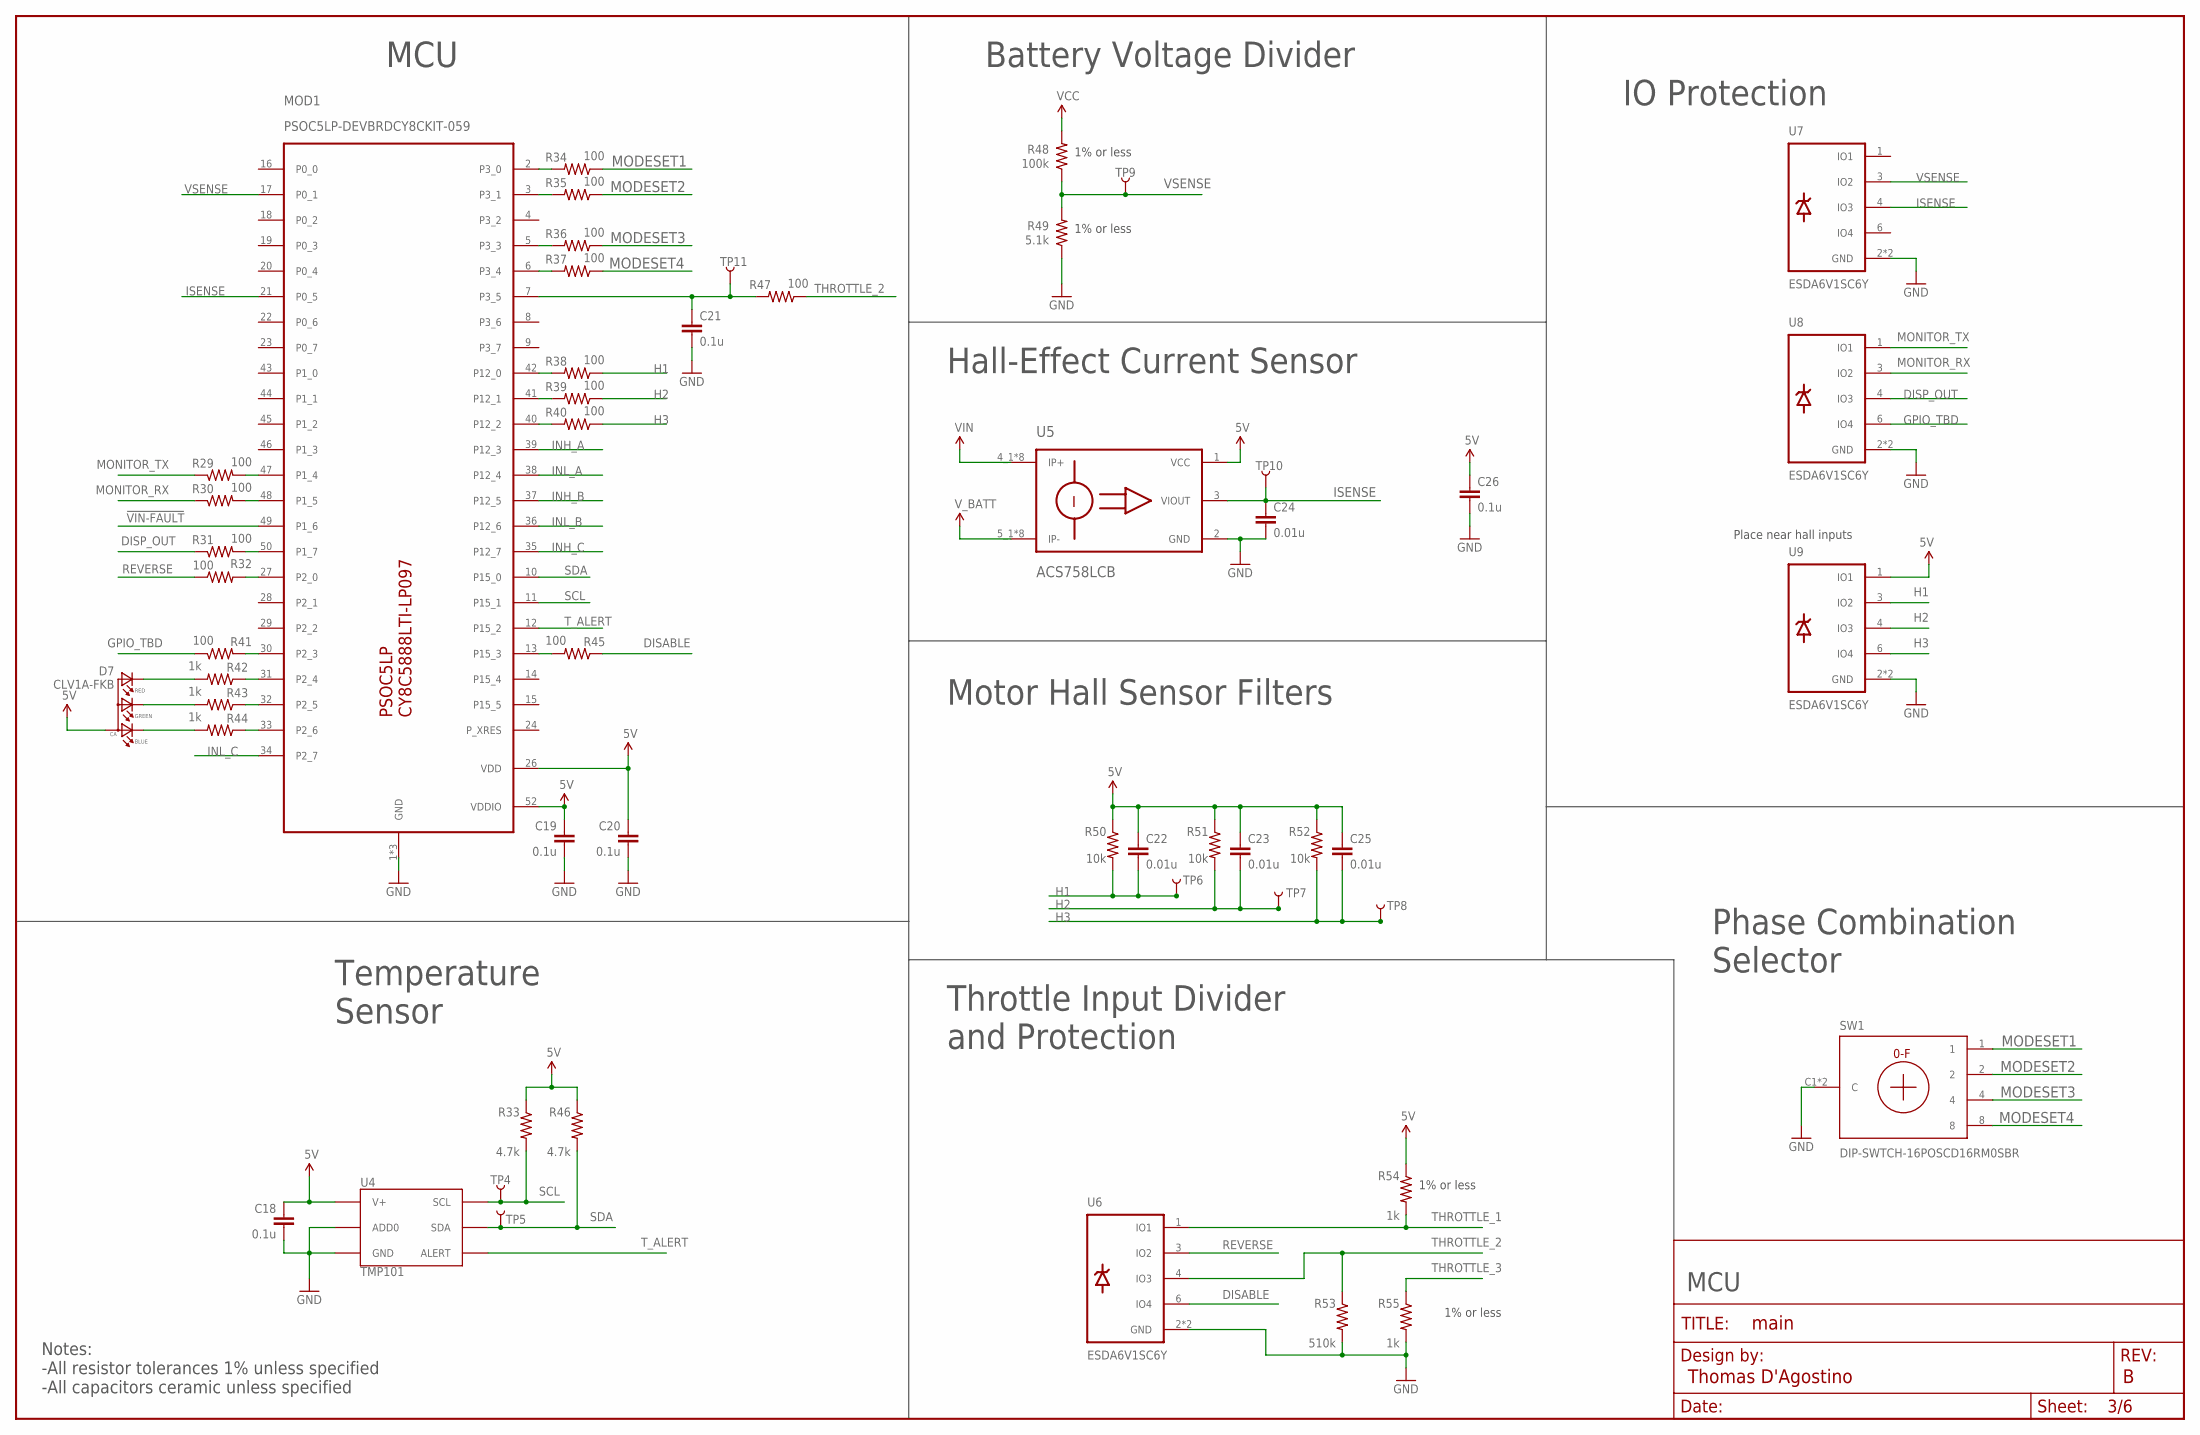
[picture p16: schematic Main.sch, sheet 3, MCU]

Parts:
C18, C19, C20, C21, C26: 0.1u; 0805
C22, C23, C24, C25: 0.01u; 0805
D7: CLV1A-FKB; P-LCC-4-3
FRAME3: FRAME-LEDGER; CREATIVE_COMMONS
MOD1: PSOC5LP-DEVBRDCY8CKIT-059; CYKIT059
R29, R30, R31, R32, R34, R35, R36, R37, R38, R39, R40, R41, R45, R47: 100; 0805
R33, R46: 4.7k; 0805
R42, R43, R44, R54, R55: 1k; 0805
R48: 100k; 1206
R49: 5.1k; 1206
R50, R51, R52: 10k; 0805
R53: 510k; 0805
SW1: DIP-SWTCH-16POSCD16RM0SBR; DIP-8MM
TP4, TP5, TP6, TP7, TP8, TP9, TP10, TP11: TEST-POINTRCT-0C; TEST-POINT-MINI
U4: TMP101; SOT23-6
U5: ACS758LCB; CB5PIN
U6, U7, U8, U9: ESDA6V1SC6Y; SOT23-6

Connections:
5V: C18.1, C19.1, C20.1, C22.1, C23.1, C25.1, C26.1, D7.2 (ANODE), MOD1.26 (VDD), MOD1.52 (VDDIO), R33.1, R46.1, R50.1, R51.1, R52.1, R54.1, U4.4 (V+), U5.1 (VCC), U9.1 (IO1); also elsewhere on the board
!VIN-FAULT: MOD1.49 (P1_6); also elsewhere on the board
DISABLE: R45.1, U6.6 (IO4); also elsewhere on the board
DISP_OUT: R31.1, U8.6 (IO4); also elsewhere on the board
GND: C18.2, C19.2, C20.2, C21.2, C24.2, C26.2, MOD1.1 (GND), MOD1.25 (GND), MOD1.51 (GND), R49.1, R53.2, R55.2, SW1.C1 (C), SW1.C2 (C), U4.2 (GND), U4.5 (ADD0), U5.2 (GND), U6.2 (GND), U6.5 (GND), U7.2 (GND), U7.5 (GND), U8.2 (GND), U8.5 (GND), U9.2 (GND), U9.5 (GND); also elsewhere on the board
GPIO_TBD: R41.1, U8.4 (IO3); also elsewhere on the board
H1: C22.2, R38.1, R50.2, TP6.P$1, U9.3 (IO2); also elsewhere on the board
H2: C23.2, R39.1, R51.2, TP7.P$1, U9.4 (IO3); also elsewhere on the board
H3: C25.2, R40.1, R52.2, TP8.P$1, U9.6 (IO4); also elsewhere on the board
INH_A: MOD1.39 (P12_3); also elsewhere on the board
INH_B: MOD1.37 (P12_5); also elsewhere on the board
INH_C: MOD1.35 (P12_7); also elsewhere on the board
INL_A: MOD1.38 (P12_4); also elsewhere on the board
INL_B: MOD1.36 (P12_6); also elsewhere on the board
INL_C: MOD1.34 (P2_7); also elsewhere on the board
ISENSE: C24.1, MOD1.21 (P0_5), TP10.P$1, U5.3 (VIOUT), U7.4 (IO3)
MODESET1: R34.1, SW1.1
MODESET2: R35.1, SW1.2
MODESET3: R36.1, SW1.4
MODESET4: R37.1, SW1.8
MONITOR_RX: R30.1, U8.1 (IO1); also elsewhere on the board
MONITOR_TX: R29.1, U8.3 (IO2); also elsewhere on the board
unnamed: MOD1.42 (P12_0), R38.2
unnamed: MOD1.13 (P15_3), R45.2
unnamed: MOD1.5 (P3_3), R36.2
unnamed: MOD1.33 (P2_6), R44.1
unnamed: MOD1.32 (P2_5), R43.1
unnamed: MOD1.31 (P2_4), R42.1
unnamed: D7.3 (BLUE), R44.2
unnamed: D7.4 (GREEN), R43.2
unnamed: D7.1 (RED), R42.2
unnamed: C21.1, MOD1.7 (P3_5), R47.2, TP11.P$1
unnamed: MOD1.50 (P1_7), R31.2
unnamed: MOD1.30 (P2_3), R41.2
unnamed: MOD1.47 (P1_4), R29.2
unnamed: MOD1.48 (P1_5), R30.2
unnamed: MOD1.41 (P12_1), R39.2
unnamed: MOD1.40 (P12_2), R40.2
unnamed: MOD1.27 (P2_0), R32.2
unnamed: MOD1.3 (P3_1), R35.2
unnamed: MOD1.2 (P3_0), R34.2
unnamed: MOD1.6 (P3_4), R37.2
REVERSE: R32.1, U6.3 (IO2); also elsewhere on the board
SCL: MOD1.11 (P15_1), R33.2, TP4.P$1, U4.1 (SCL)
SDA: MOD1.10 (P15_0), R46.2, TP5.P$1, U4.6 (SDA)
THROTTLE_1: R54.2, U6.1 (IO1); also elsewhere on the board
THROTTLE_2: R47.1, R53.1, U6.4 (IO3); also elsewhere on the board
THROTTLE_3: R55.1; also elsewhere on the board
T_ALERT: MOD1.12 (P15_2), U4.3 (ALERT)
VCC: R48.2; also elsewhere on the board
VIN: U5.4_1 (IP+), U5.4_2 (IP+), U5.4_3 (IP+), U5.4_4 (IP+), U5.4_5 (IP+), U5.4_6 (IP+), U5.4_7 (IP+), U5.4_8 (IP+); also elsewhere on the board
VSENSE: MOD1.17 (P0_1), R48.1, R49.2, TP9.P$1, U7.3 (IO2)
V_BATT: U5.5_1 (IP-), U5.5_2 (IP-), U5.5_3 (IP-), U5.5_4 (IP-), U5.5_5 (IP-), U5.5_6 (IP-), U5.5_7 (IP-), U5.5_8 (IP-); also elsewhere on the board

Notes on the sheet:
Place near hall inputs
1% or less
MCU
Temperature Sensor
Battery Voltage Divider
Hall-Effect Current Sensor
Motor Hall Sensor Filters
Throttle Input Divider and Protection
IO Protection
Notes: -All resistor tolerances 1% unless specified -All capacitors ceramic unless specified
Phase Combination Selector

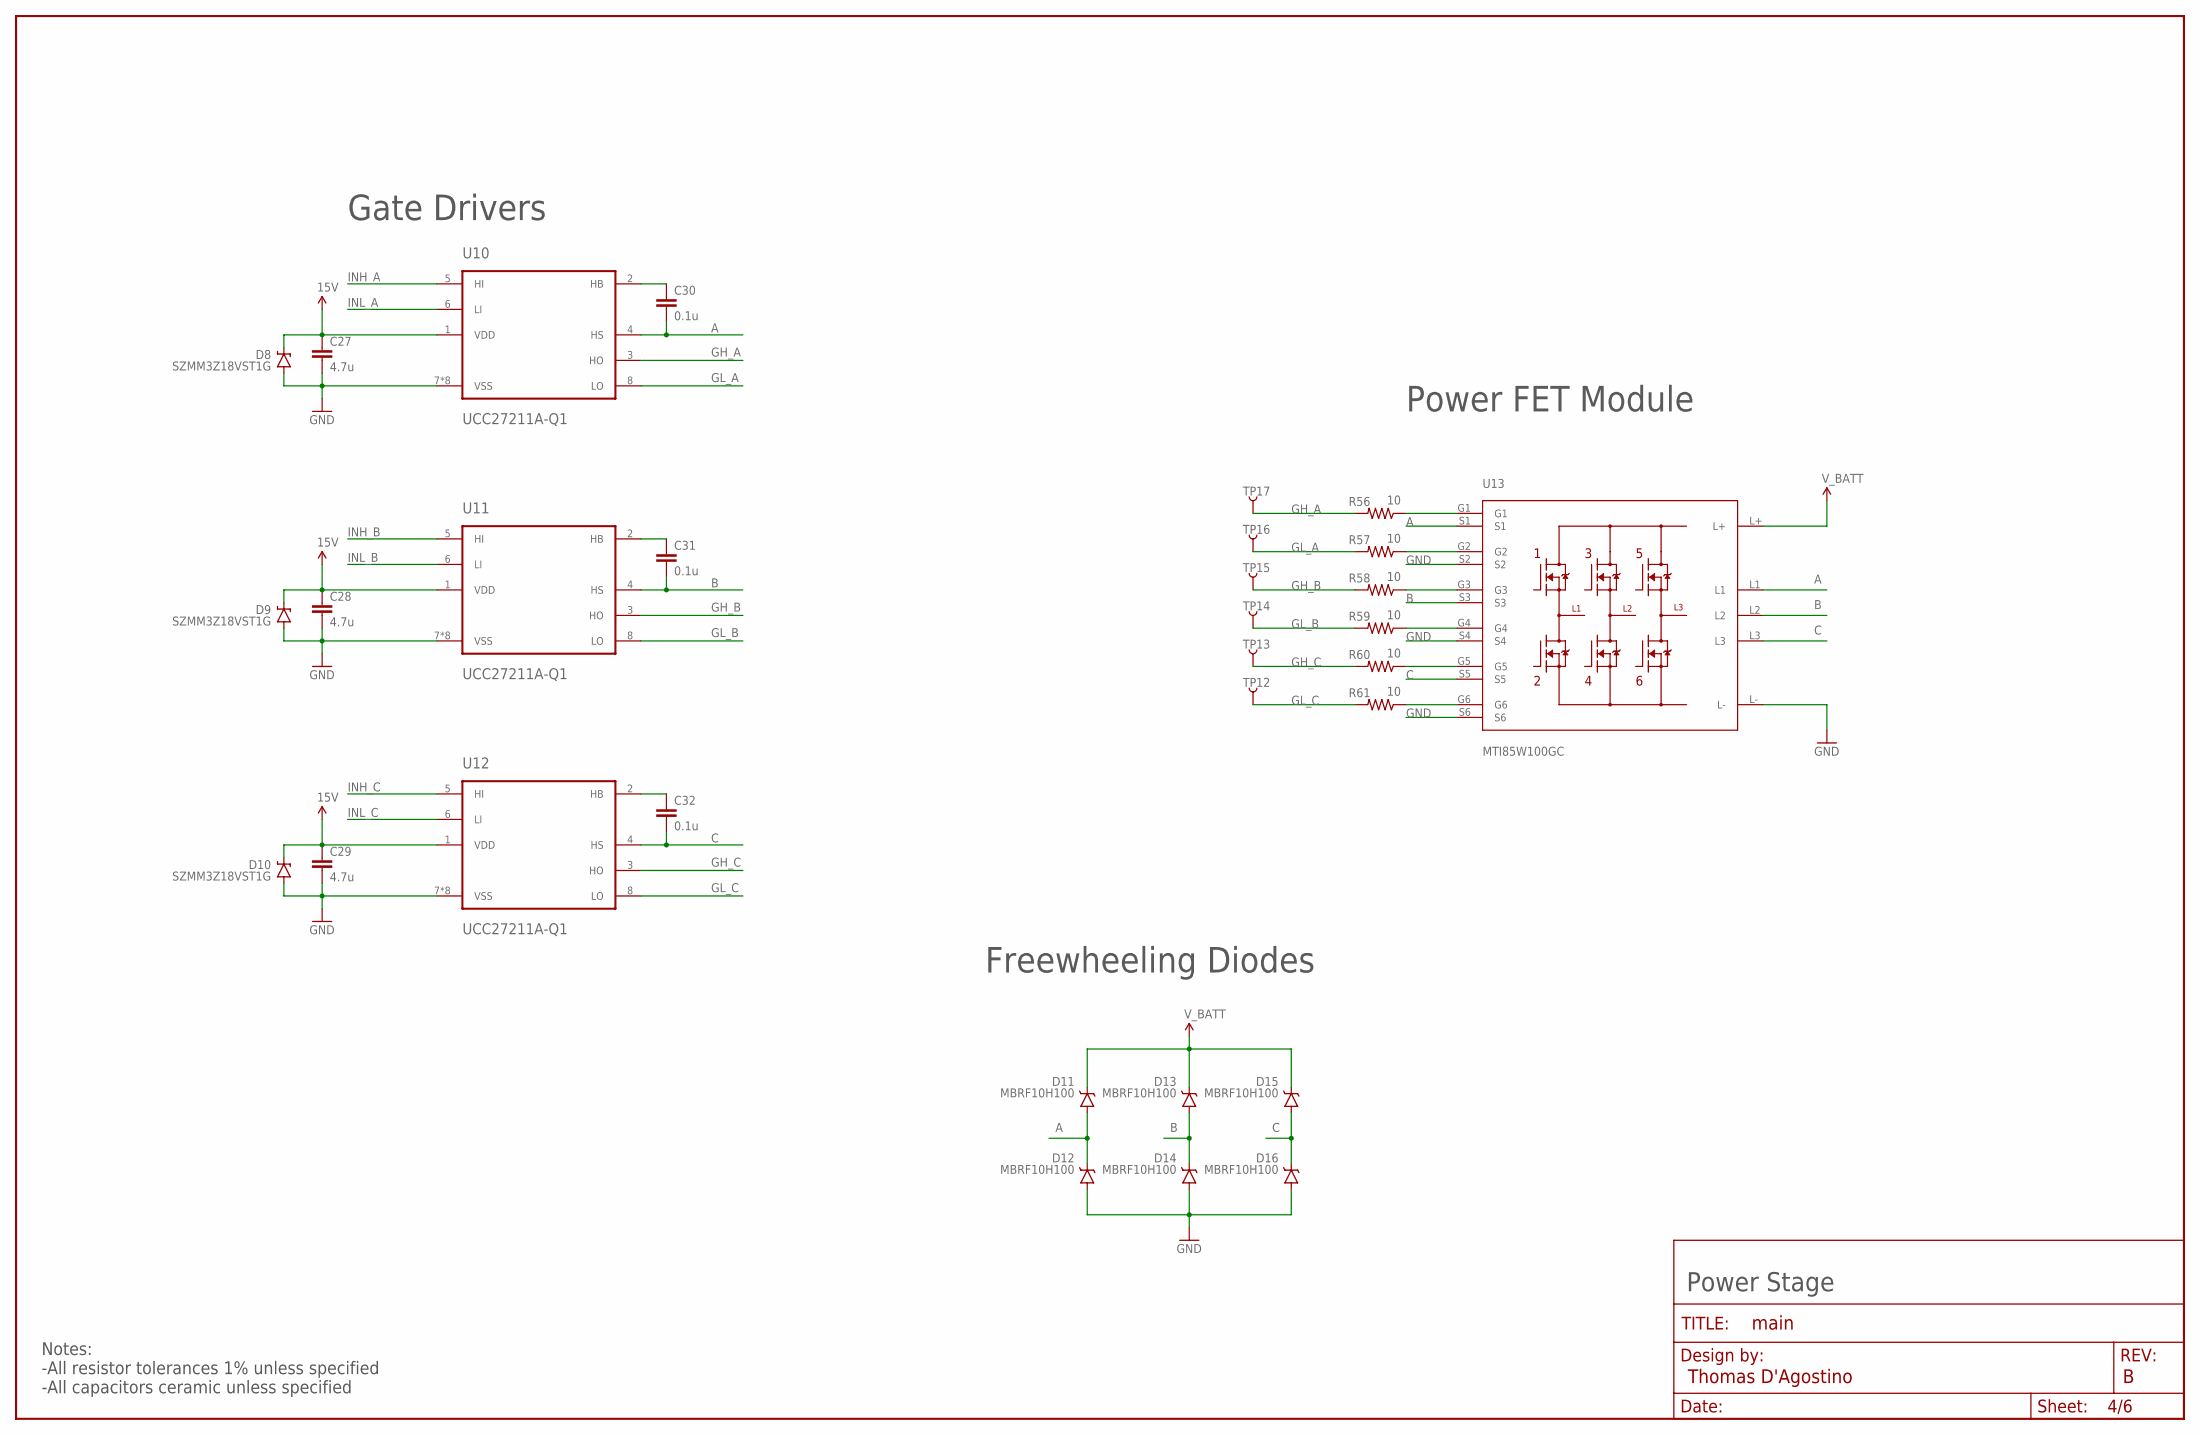
[picture p17: schematic Main.sch, sheet 4, Power Output]

Parts:
C27, C28, C29: 4.7u; 1210
C30, C31, C32: 0.1u; 0805
D8, D9, D10: SZMM3Z18VST1G; SOD-323
D11, D12, D13, D14, D15, D16: MBRF10H100; TO220V_2
FRAME4: FRAME-LEDGER; CREATIVE_COMMONS
R56, R57, R58, R59, R60, R61: 10; 0805
TP12, TP13, TP14, TP15, TP16, TP17: TEST-POINTRCT-0C; TEST-POINT-MINI
U10, U11, U12: UCC27211A-Q1; SOIC-8-EP
U13: MTI85W100GC; ISOPLUS-DIL

Connections:
15V: C27.1, C28.1, C29.1, D8.C, D9.C, D10.C, U10.1 (VDD), U11.1 (VDD), U12.1 (VDD); also elsewhere on the board
A: C30.2, D11.2 (A), D12.1 (C), U10.4 (HS), U13.L1, U13.S1; also elsewhere on the board
B: C31.2, D13.2 (A), D14.1 (C), U11.4 (HS), U13.L2, U13.S3; also elsewhere on the board
C: C32.2, D15.2 (A), D16.1 (C), U12.4 (HS), U13.L3, U13.S5; also elsewhere on the board
GH_A: R56.2, TP17.P$1, U10.3 (HO)
GH_B: R58.2, TP15.P$1, U11.3 (HO)
GH_C: R60.2, TP13.P$1, U12.3 (HO)
GL_A: R57.2, TP16.P$1, U10.8 (LO)
GL_B: R59.2, TP14.P$1, U11.8 (LO)
GL_C: R61.2, TP12.P$1, U12.8 (LO)
GND: C27.2, C28.2, C29.2, D8.A, D9.A, D10.A, D12.2 (A), D14.2 (A), D16.2 (A), U10.7 (VSS), U10.EP1 (VSS), U10.EP2 (VSS), U10.EP3 (VSS), U10.EP4 (VSS), U10.EP5 (VSS), U10.EP6 (VSS), U10.EXP (VSS), U11.7 (VSS), U11.EP1 (VSS), U11.EP2 (VSS), U11.EP3 (VSS), U11.EP4 (VSS), U11.EP5 (VSS), U11.EP6 (VSS), U11.EXP (VSS), U12.7 (VSS), U12.EP1 (VSS), U12.EP2 (VSS), U12.EP3 (VSS), U12.EP4 (VSS), U12.EP5 (VSS), U12.EP6 (VSS), U12.EXP (VSS), U13.L-, U13.S2, U13.S4, U13.S6; also elsewhere on the board
INH_A: U10.5 (HI); also elsewhere on the board
INH_B: U11.5 (HI); also elsewhere on the board
INH_C: U12.5 (HI); also elsewhere on the board
INL_A: U10.6 (LI); also elsewhere on the board
INL_B: U11.6 (LI); also elsewhere on the board
INL_C: U12.6 (LI); also elsewhere on the board
unnamed: C30.1, U10.2 (HB)
unnamed: C31.1, U11.2 (HB)
unnamed: C32.1, U12.2 (HB)
unnamed: R58.1, U13.G3
unnamed: R56.1, U13.G1
unnamed: R57.1, U13.G2
unnamed: R59.1, U13.G4
unnamed: R60.1, U13.G5
unnamed: R61.1, U13.G6
V_BATT: D11.1 (C), D13.1 (C), D15.1 (C), U13.L+; also elsewhere on the board

Notes on the sheet:
Freewheeling Diodes
Power FET Module
Power Stage
Notes: -All resistor tolerances 1% unless specified -All capacitors ceramic unless specified
Gate Drivers

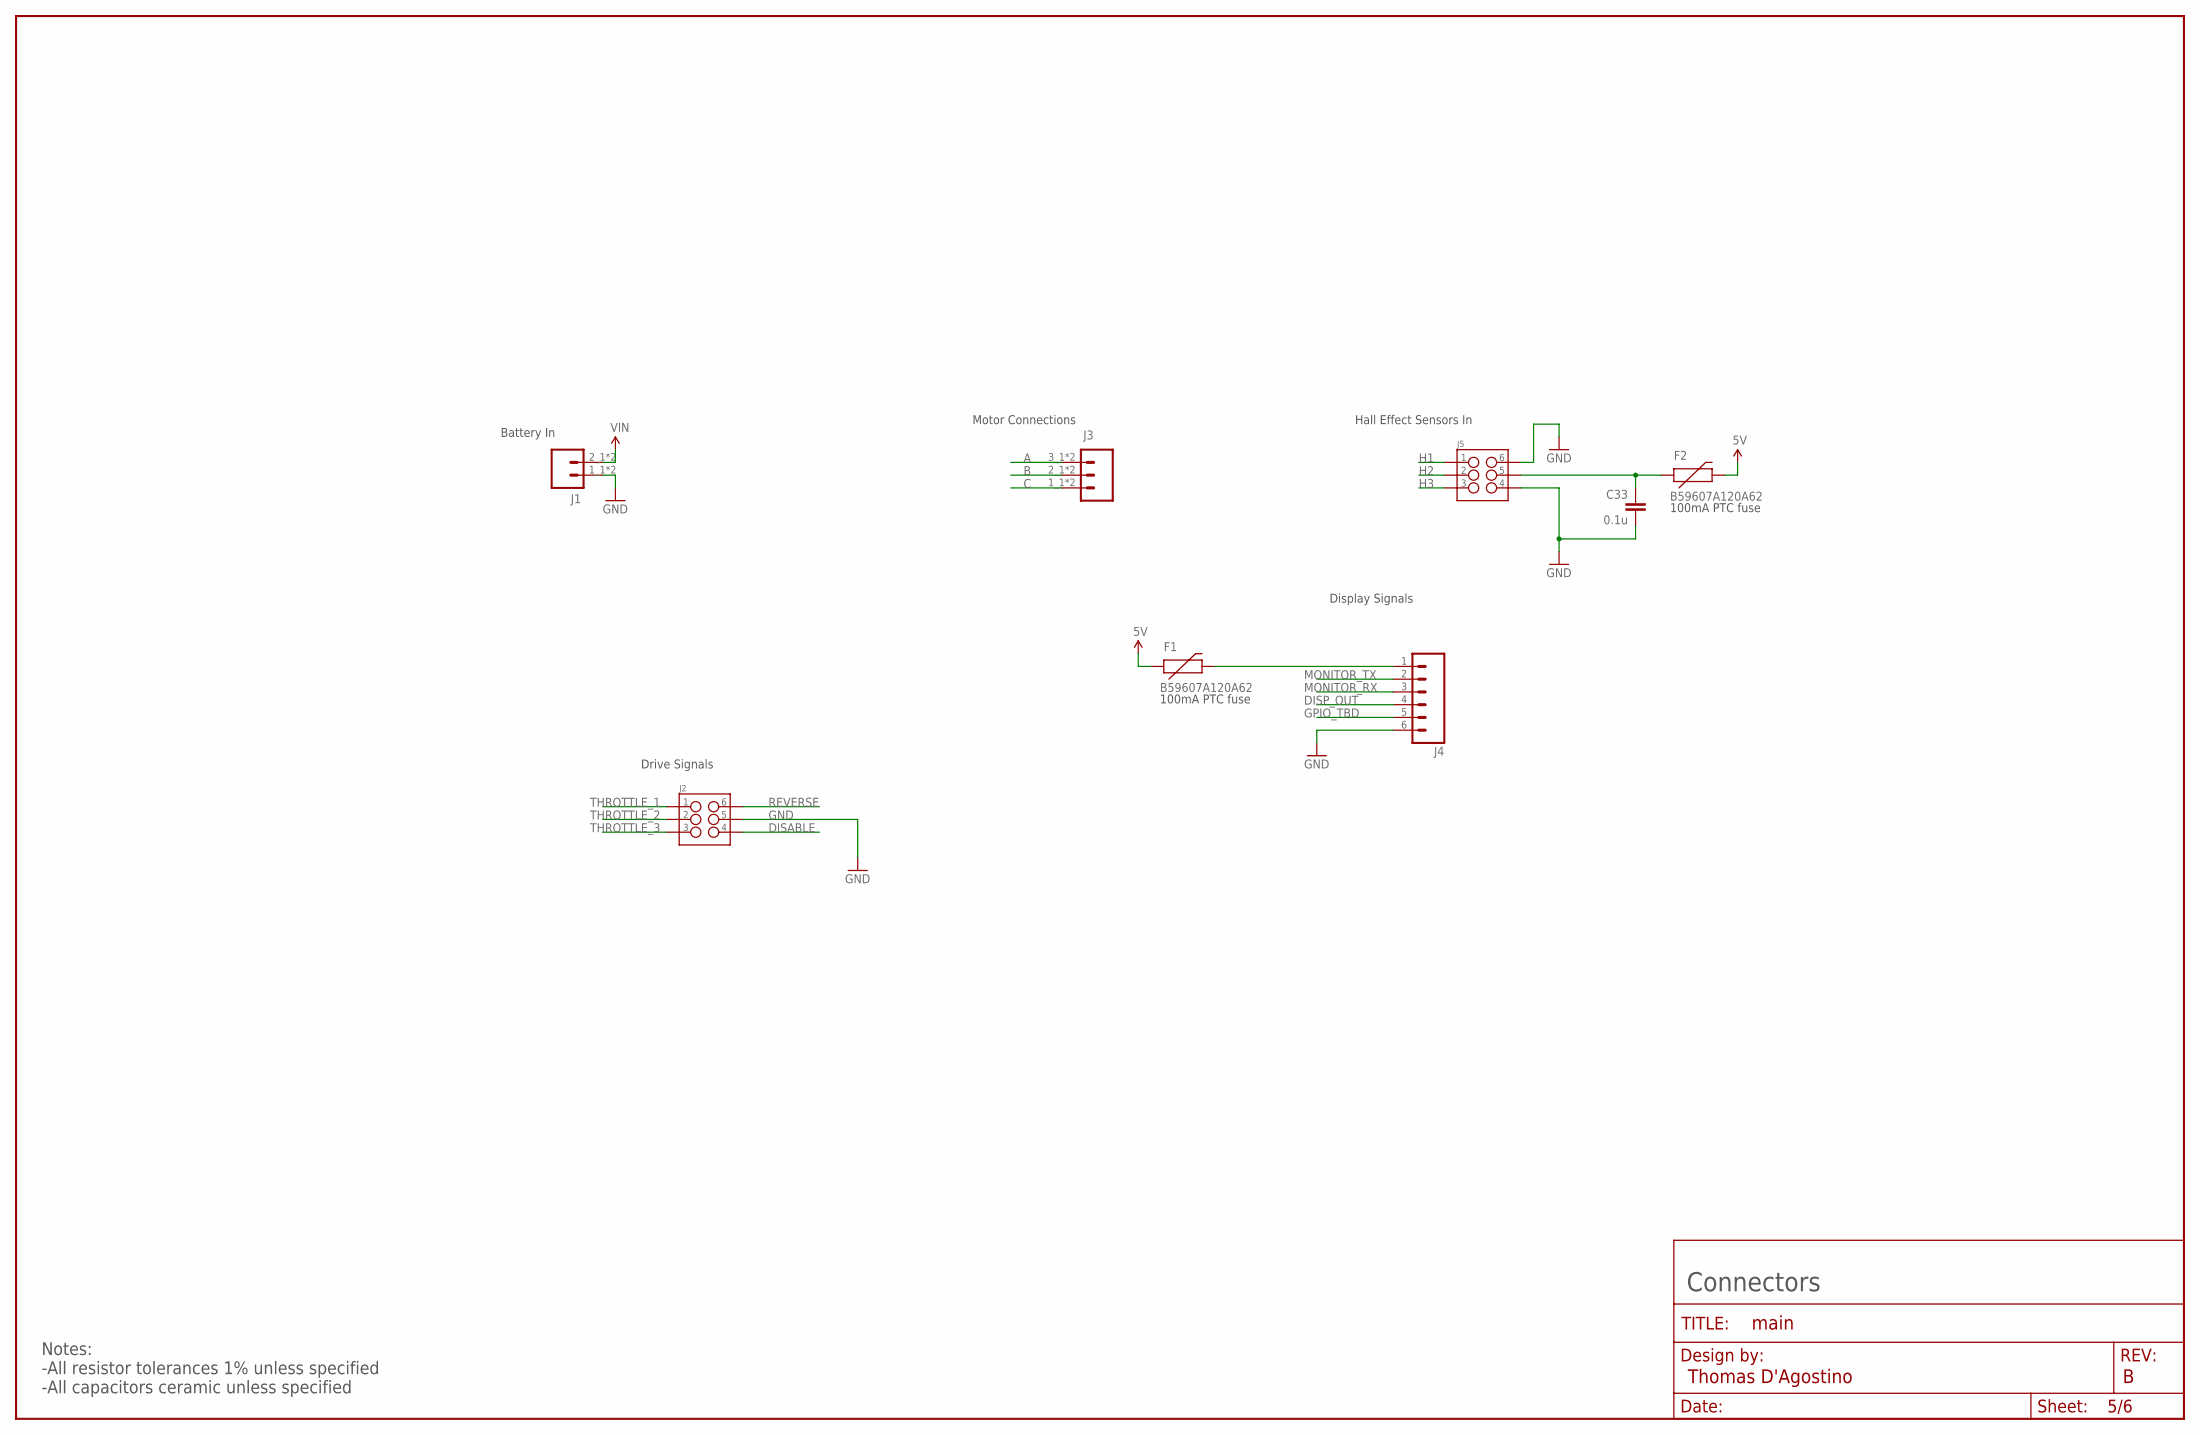
[picture p18: schematic Main.sch, sheet 5, Connectors]

Parts:
C33: 0.1u; 0805
F1, F2: B59607A120A62; 1210
FRAME5: FRAME-LEDGER; CREATIVE_COMMONS
J1: M02MINIFIT-SR; MINIFIT_SR
J2, J5: M03X2MINIFIT_JR; 2X03_MINIFIT_JR
J3: M03MINIFIT-SR3; MINIFIT-SRX3
J4: M06SILK_FEMALE_PTH; 1X06

Connections:
5V: F1.1, F2.2; also elsewhere on the board
A: J3.3_1 (3), J3.3_2 (3); also elsewhere on the board
B: J3.2_1 (2), J3.2_2 (2); also elsewhere on the board
C: J3.1_1 (1), J3.1_2 (1); also elsewhere on the board
DISABLE: J2.4; also elsewhere on the board
DISP_OUT: J4.4; also elsewhere on the board
GND: C33.2, J1.1_1 (1), J1.1_2 (1), J2.5, J4.6, J5.4, J5.6; also elsewhere on the board
GPIO_TBD: J4.5; also elsewhere on the board
H1: J5.1; also elsewhere on the board
H2: J5.2; also elsewhere on the board
H3: J5.3; also elsewhere on the board
MONITOR_RX: J4.3; also elsewhere on the board
MONITOR_TX: J4.2; also elsewhere on the board
unnamed: F1.2, J4.1
unnamed: C33.1, F2.1, J5.5
REVERSE: J2.6; also elsewhere on the board
THROTTLE_1: J2.1; also elsewhere on the board
THROTTLE_2: J2.2; also elsewhere on the board
THROTTLE_3: J2.3; also elsewhere on the board
VIN: J1.2_1 (2), J1.2_2 (2); also elsewhere on the board

Notes on the sheet:
Hall Effect Sensors In
Battery In
Drive Signals
Motor Connections
Display Signals
Connectors
Notes: -All resistor tolerances 1% unless specified -All capacitors ceramic unless specified
100mA PTC fuse
