Tommydag/BLDC-Motor-Controller/PCBs/Projects/MotorController/Main.brd

## EAGLE design PCBs/Projects/MotorController/Main.brd (continued)

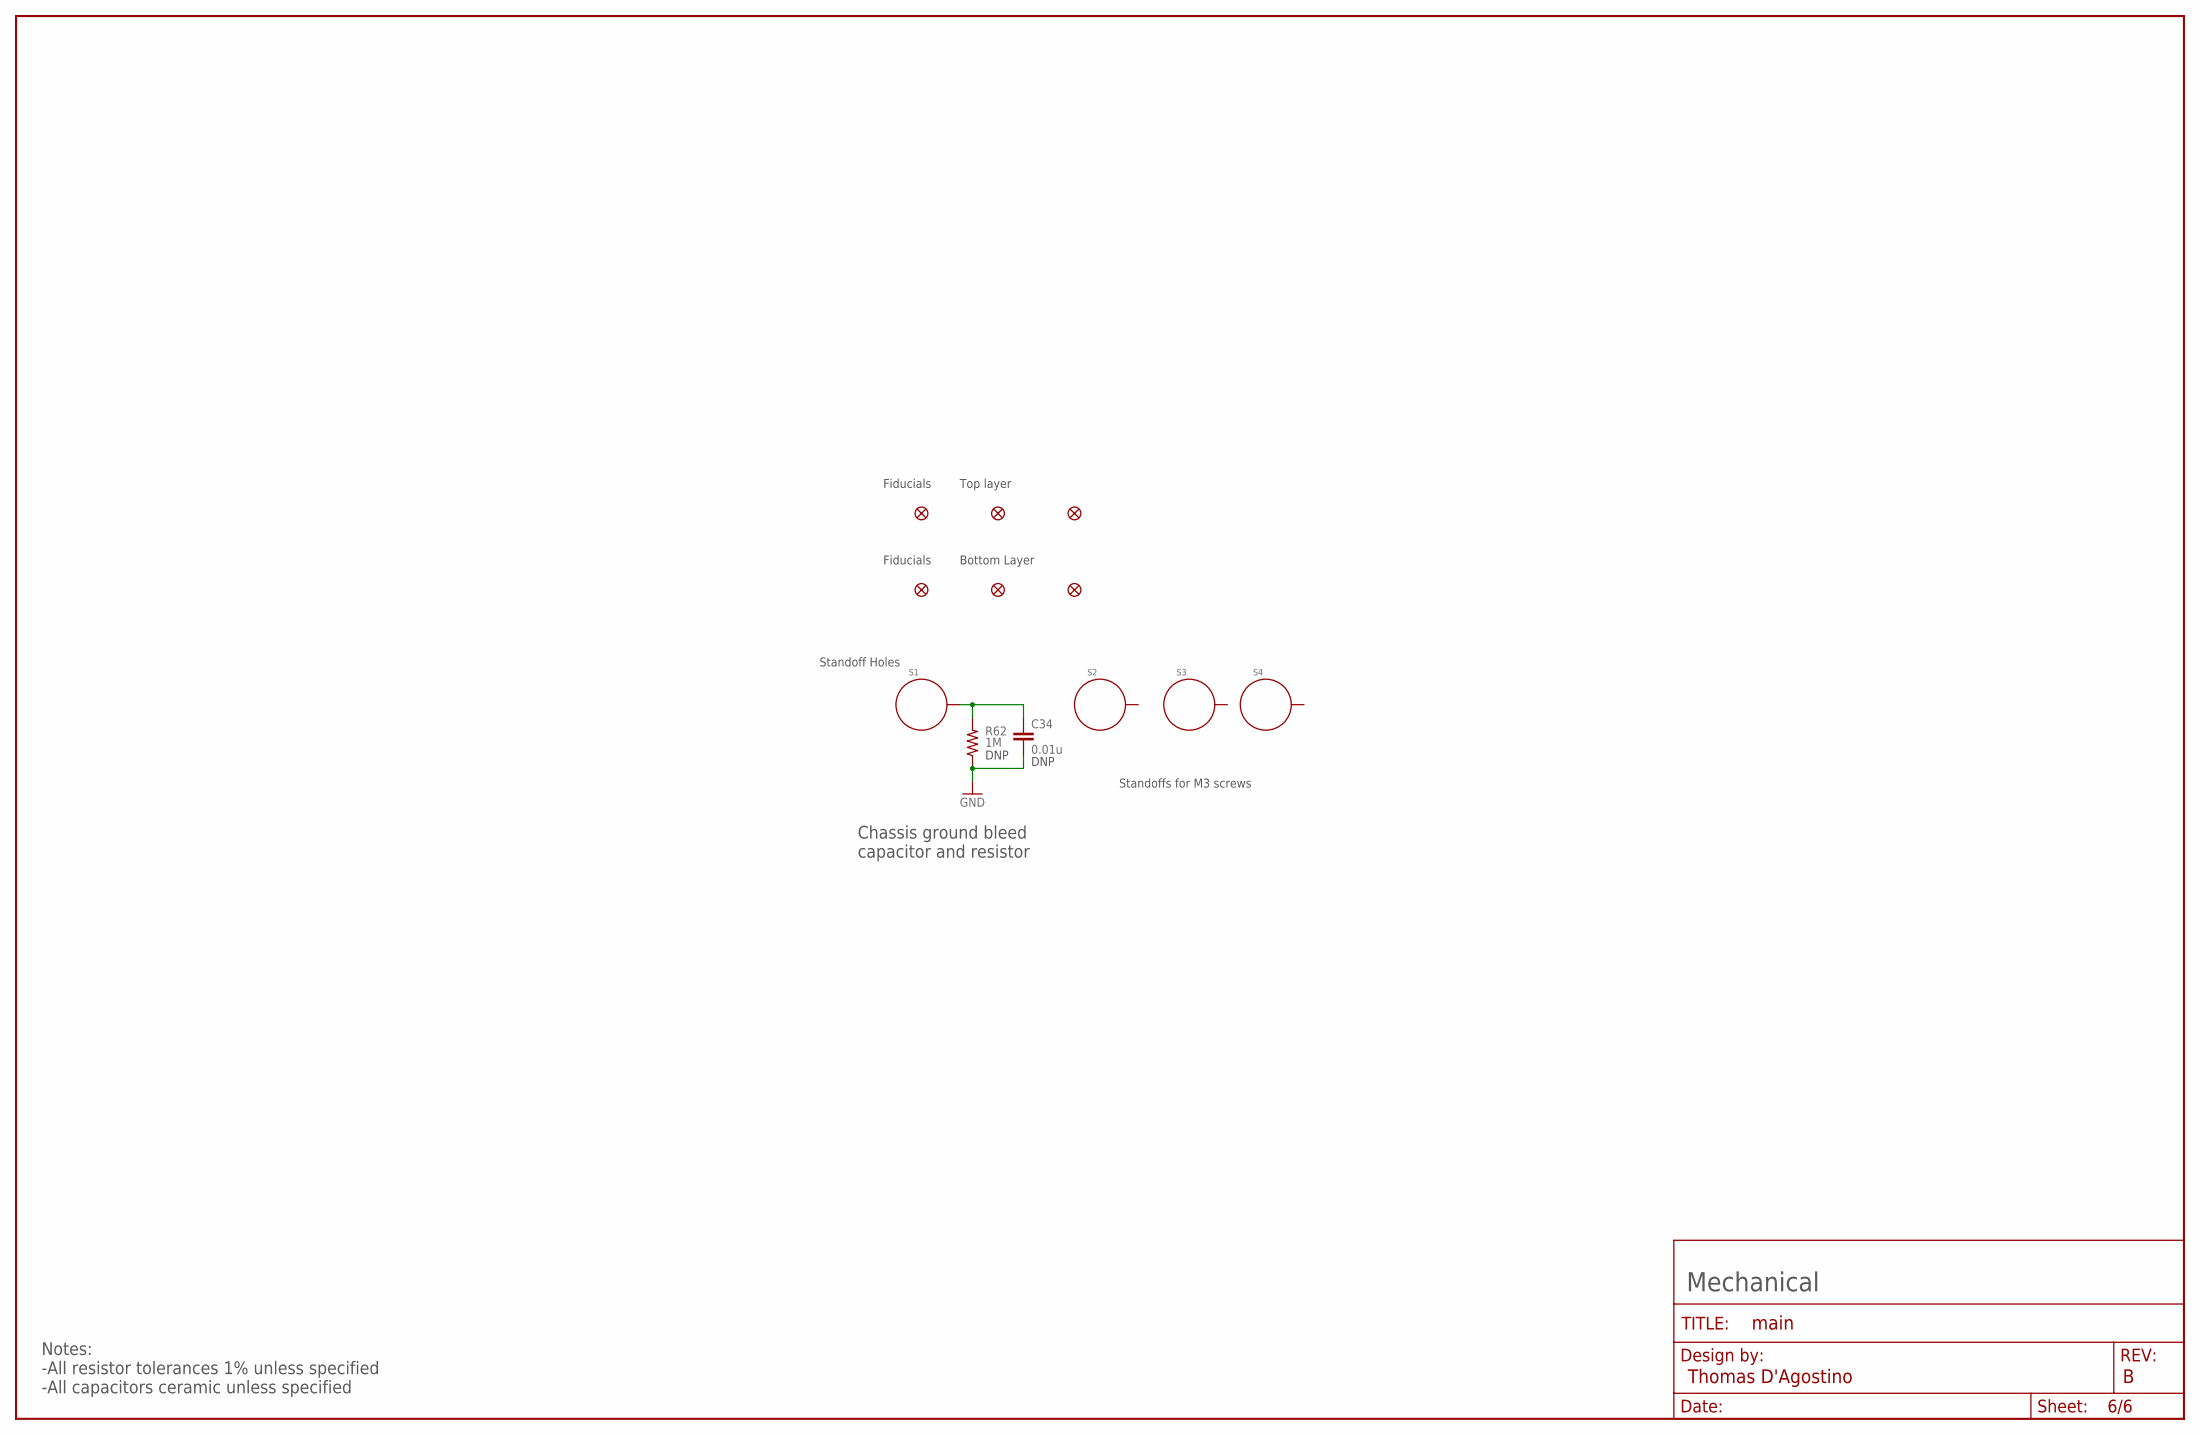
[picture p19: schematic Main.sch, sheet 6, Mechanical]

Parts:
C34: 0.01u; 0805
FD1, FD2, FD3, FD4, FD5, FD6: FIDUCIAL1X2; FIDUCIAL-1X2
FRAME6: FRAME-LEDGER; CREATIVE_COMMONS
R62: 1M; 1206
S1, S2, S3, S4: STANDOFF_ELECTRICAL; STANDOFF-ELECTRICAL

Connections:
GND: C34.2, R62.1; also elsewhere on the board
unnamed: C34.1, R62.2, S1.P1

Notes on the sheet:
Fiducials
Standoff Holes
Top layer
Standoffs for M3 screws
Mechanical
Chassis ground bleed capacitor and resistor
Notes: -All resistor tolerances 1% unless specified -All capacitors ceramic unless specified
Bottom Layer
DNP

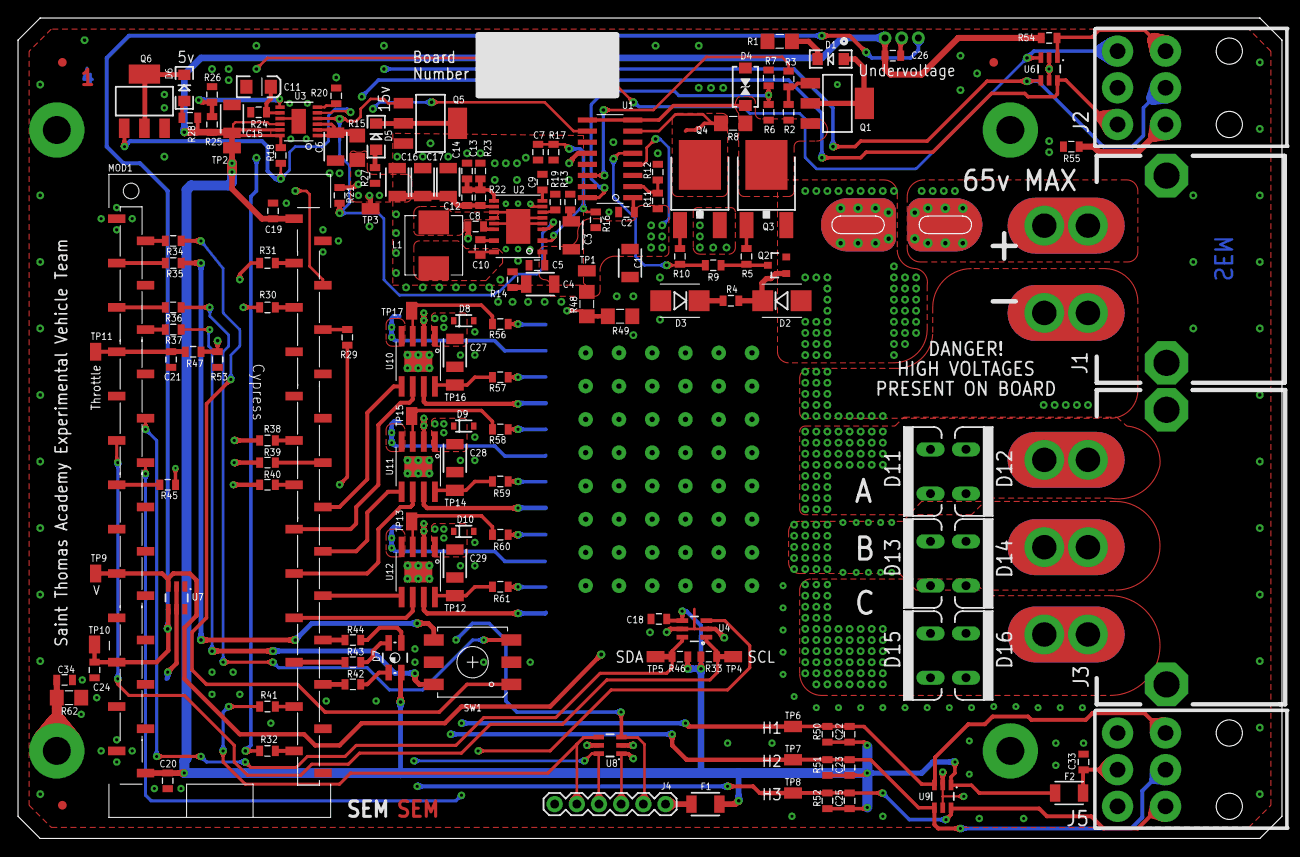
[picture p20: board Main.brd from above]

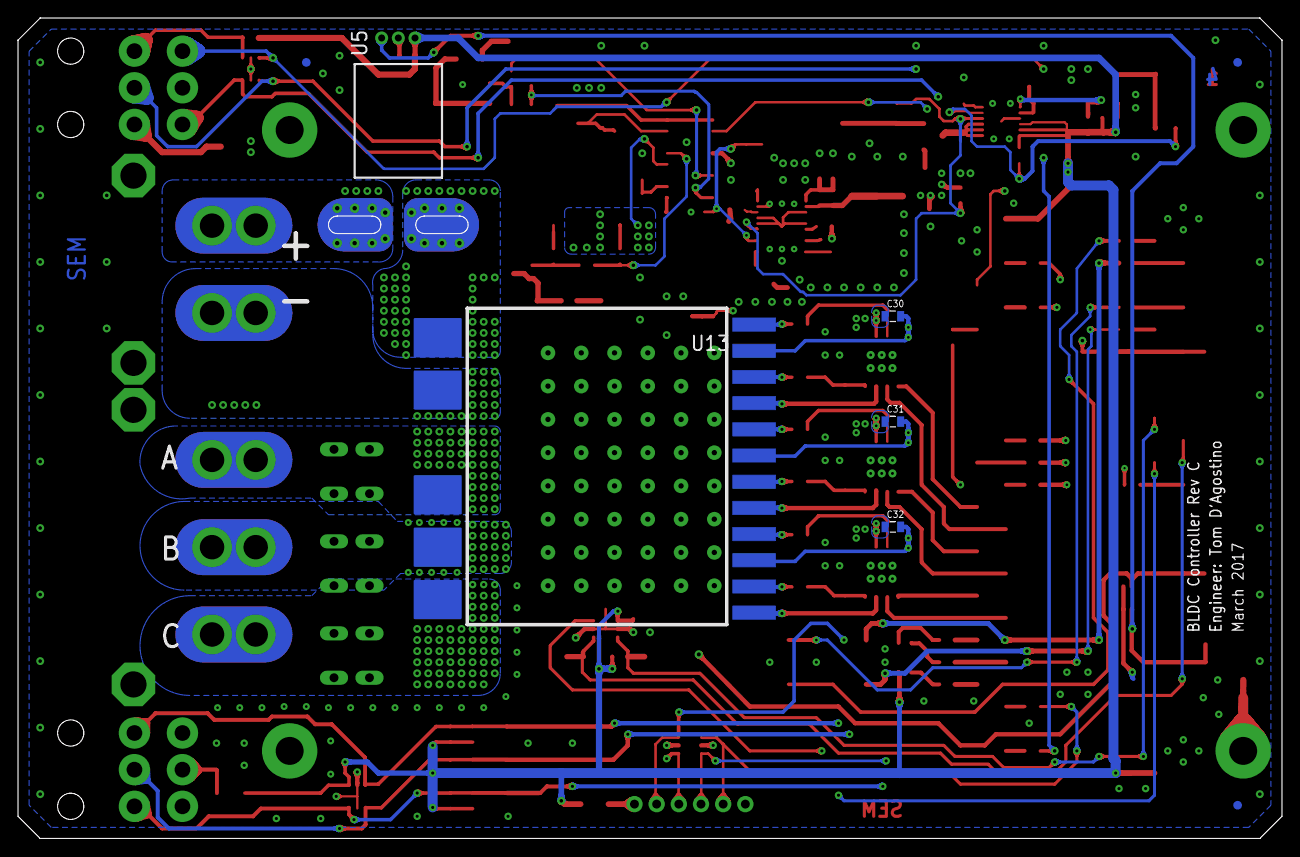
[picture p21: board Main.brd from below]

Board: 4 copper layers, 144.8 x 94.0 mm, 174 parts (8 on the bottom side), 110 nets.
