Tommydag/BLDC-Motor-Controller/PCBs/Projects/GateDriverProto/gateDriverProto.brd

## EAGLE design PCBs/Projects/GateDriverProto/gateDriverProto.brd (2017-01-29)

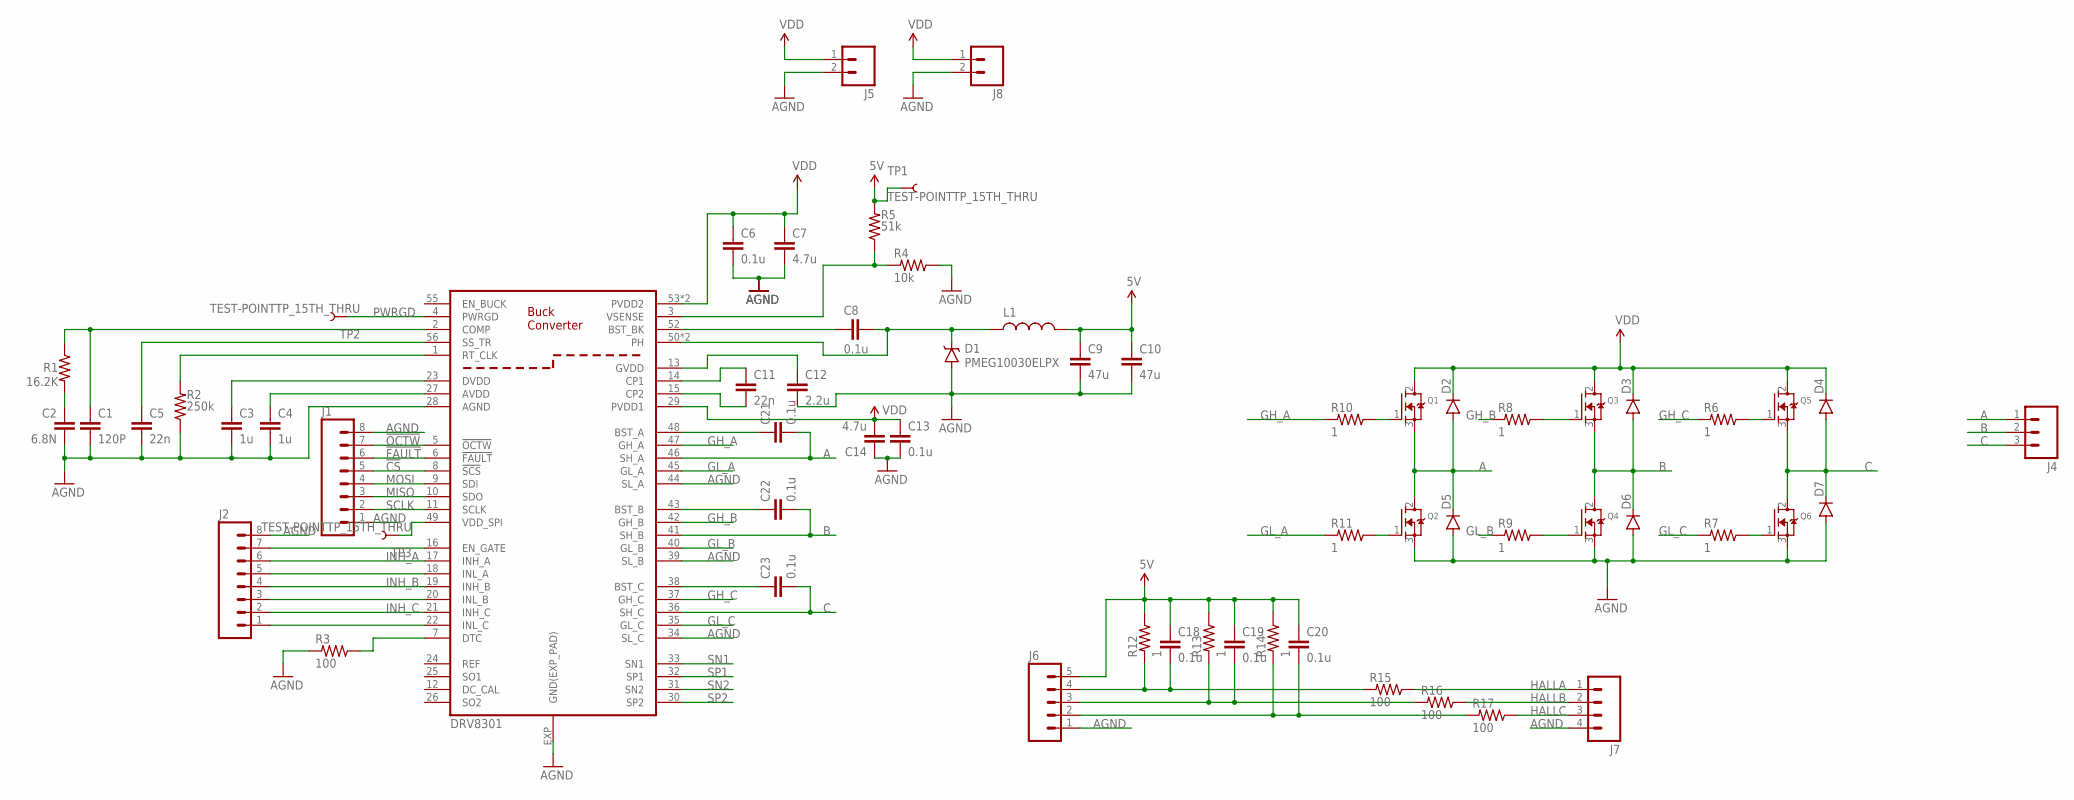
[picture p22: schematic gateDriverProto.sch]

Parts:
C1: 120P; 0805
C2: 6.8N; 0805
C3, C4: 1u; 0805
C5, C11: 22n; 0805
C6, C8, C13, C18, C19, C20: 0.1u; 0805
C7, C14: 4.7u; 1210
C9, C10: 47u; 1210
C12: 2.2u; 1210
C21, C22, C23: 0.1u; CAP-PTH-SMALL
D1: PMEG10030ELPX; SMB-DIODE
D2, D3, D4, D5, D6, D7: DIODEPTH; DIODE-1N4001
J1, J2: M08; 1X08_ROUND
J4: M03LONGPADS; 1X03_LONGPADS
J5, J8: M02LOCK_LONGPADS; 1X02_LOCK_LONGPADS
J6: M05PTH_LONGPADS; 1X05_LONGPADS
J7: M04PTH; 1X04
L1: INDUCTORPWR; CDRH125
Q1, Q2, Q3, Q4, Q5, Q6: MOSFET-NGDS_TO220V; TO220V
R1: 16.2K; AXIAL-0.1
R2: 250k; AXIAL-0.1
R3, R15, R16, R17: 100; AXIAL-0.1
R4: 10k; AXIAL-0.1
R5: 51k; AXIAL-0.1
R6, R7, R8, R9, R10, R11, R12, R13, R14: 1; AXIAL-0.1
TP1, TP2, TP3: TEST-POINTTP_15TH_THRU; TP_15TH
U1: DRV8301; HTSSOP_56

Connections:
5V: C9.1, C10.1, C18.1, C19.1, C20.1, J6.5, L1.2, R5.P$2 (2), R12.P$1 (1), R13.P$1 (1), R14.P$1 (1), TP1.P$1
!CS: J1.5, U1.8 (!SCS)
!FAULT: J1.6, U1.6 (!FAULT)
!OCTW: J1.7, U1.5 (!OCTW)
A: C21.2, D2.A, D5.C, J4.1, Q1.3 (S), Q2.2 (D), U1.46 (SH_A)
AGND: C1.2, C2.2, C3.2, C4.2, C5.2, C6.2, C7.2, C9.2, C10.2, C12.2, C13.2, C14.1, D1.A, D5.A, D6.A, D7.A, J1.1, J1.8, J2.8, J5.2, J6.1, J7.4, J8.2, Q2.3 (S), Q4.3 (S), Q6.3 (S), R2.P$1 (1), R3.P$2 (2), R4.P$1 (1), U1.28 (AGND), U1.34 (SL_C), U1.39 (SL_B), U1.44 (SL_A), U1.EXP (GND(EXP_PAD))
B: C22.2, D3.A, D6.C, J4.2, Q3.3 (S), Q4.2 (D), U1.41 (SH_B)
C: C23.2, D4.A, D7.C, J4.3, Q5.3 (S), Q6.2 (D), U1.36 (SH_C)
GH_A: R10.P$2 (2), U1.47 (GH_A)
GH_B: R8.P$2 (2), U1.42 (GH_B)
GH_C: R6.P$2 (2), U1.37 (GH_C)
GL_A: R11.P$2 (2), U1.45 (GL_A)
GL_B: R9.P$2 (2), U1.40 (GL_B)
GL_C: R7.P$2 (2), U1.35 (GL_C)
HALLA: J7.1, R15.P$1 (1)
HALLB: J7.2, R16.P$1 (1)
HALLC: J7.3, R17.P$1 (1)
INH_A: J2.6, U1.17 (INH_A)
INH_B: J2.4, U1.19 (INH_B)
INH_C: J2.2, U1.21 (INH_C)
MISO: J1.3, U1.10 (SDO)
MOSI: J1.4, U1.9 (SDI)
unnamed: R2.P$2 (2), U1.1 (RT_CLK)
unnamed: C2.1, R1.P$2 (2)
unnamed: C5.1, U1.56 (SS_TR)
unnamed: J2.7, U1.16 (EN_GATE)
unnamed: C3.1, U1.23 (DVDD)
unnamed: C1.1, R1.P$1 (1), U1.2 (COMP)
unnamed: C4.1, U1.27 (AVDD)
unnamed: R3.P$1 (1), U1.7 (DTC)
unnamed: R4.P$2 (2), R5.P$1 (1), U1.3 (VSENSE)
unnamed: C8.1, U1.52 (BST_BK)
unnamed: C8.2, D1.C, L1.1, U1.50 (PH), U1.51 (PH)
unnamed: C12.1, U1.13 (GVDD)
unnamed: C22.1, U1.43 (BST_B)
unnamed: C21.1, U1.48 (BST_A)
unnamed: C18.2, J6.4, R12.P$2 (2), R15.P$2 (2)
unnamed: C11.2, U1.15 (CP2)
unnamed: C11.1, U1.14 (CP1)
unnamed: TP3.P$1, U1.49 (VDD_SPI)
unnamed: C19.2, J6.3, R13.P$2 (2), R16.P$2 (2)
unnamed: C23.1, U1.38 (BST_C)
unnamed: C20.2, J6.2, R14.P$2 (2), R17.P$2 (2)
unnamed: Q5.1 (G), R6.P$1 (1)
unnamed: J2.5, U1.18 (INL_A)
unnamed: Q6.1 (G), R7.P$1 (1)
unnamed: J2.1, U1.22 (INL_C)
unnamed: Q3.1 (G), R8.P$1 (1)
unnamed: Q4.1 (G), R9.P$1 (1)
unnamed: Q2.1 (G), R11.P$1 (1)
unnamed: Q1.1 (G), R10.P$1 (1)
unnamed: J2.3, U1.20 (INL_B)
PWRGD: TP2.P$1, U1.4 (PWRGD)
SCLK: J1.2, U1.11 (SCLK)
SN1: U1.33 (SN1)
SN2: U1.31 (SN2)
SP1: U1.32 (SP1)
SP2: U1.30 (SP2)
VDD: C6.1, C7.1, C13.1, C14.2, D2.C, D3.C, D4.C, J5.1, J8.1, Q1.2 (D), Q3.2 (D), Q5.2 (D), U1.29 (PVDD1), U1.53 (PVDD2), U1.54 (PVDD2)

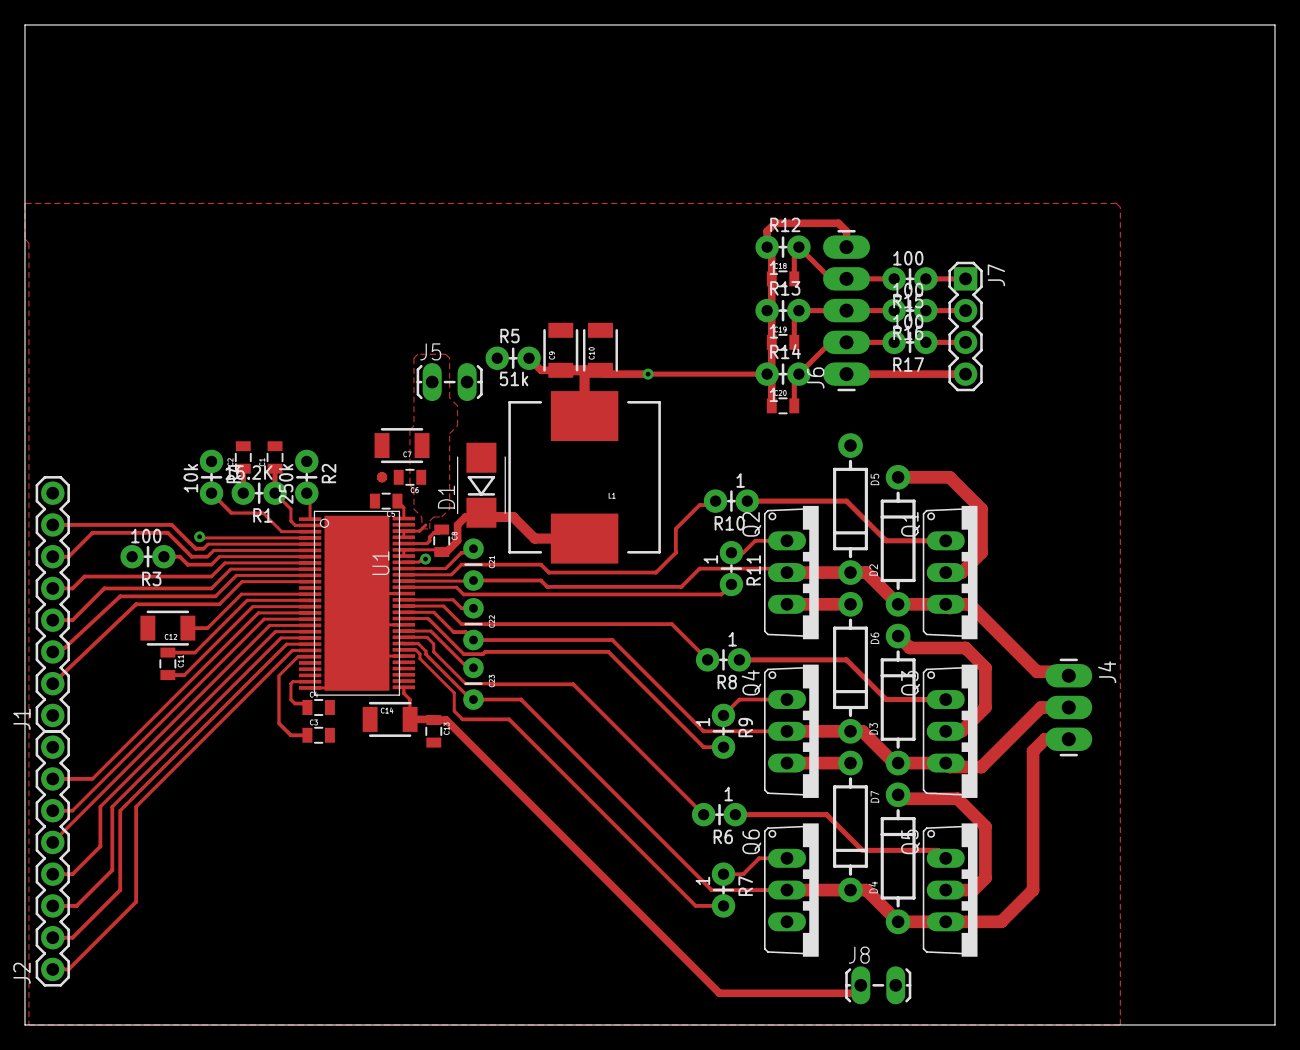
[picture p23: board gateDriverProto.brd from above]

Board: 1 copper layer, 100.0 x 80.0 mm, 62 parts (0 on the bottom side), 55 nets.
