Tommydag/BLDC-Motor-Controller/PCBs/Projects/MotorControllerOld/clockbrd.brd

## EAGLE design PCBs/Projects/MotorControllerOld/clockbrd.brd (2017-01-29, an earlier design)

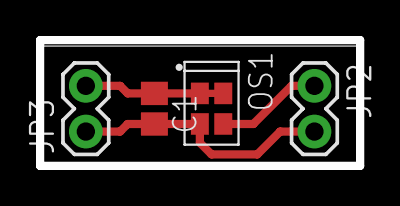
[picture p24: board clockbrd.brd from above]

Board: 2 copper layers, 17.8 x 7.0 mm, 5 parts (0 on the bottom side), 3 nets.

Parts:
C1: C0805
DRILEGEND: DRILEGEND
JP2, JP3: 1X02
OS1: OSC-OE-IQXO-793; 2.5X2-4-PAD

Connections:
CLK: JP2.1, OS1.3
GND: C1.2, JP2.2, JP3.1, OS1.2
VCC: C1.1, JP3.2, OS1.1, OS1.4
