Tommydag/BLDC-Motor-Controller/Software/BLDC_Software/BLDC_Testing_Project.cydsn/globals.h

/* ========================================
 *
 * Engineer: Tom D'Agostino
 * Project: STA EVT BLDC Motor Controller
 * Date: 7 Jan 2017
 * Description: Global Constant Definitions
 * Language: C
 * Target Hardware: PSOC5LP
 * Version: 0_1
 *
 * ========================================
*/

#ifndef GLOBALS_H
#define GLOBALS_H
/***************************************
* Header Files use
***************************************/

/***************************************
* Constants Definitions
***************************************/
#define TRUE                0x01
#define FALSE               0x00
    
/***************************************
* Data Struct Definitions
***************************************/

 #endif
/* [] END OF FILE */
