Tommydag/BLDC-Motor-Controller/(commit log)

2016-12-05 Initial Commit -Added Progress as of now
    [clockbrd.brd, gateDriverProto.sch, mcu_brd.sch]
2016-12-06 Start of main motor controller -See main.sch -Cleaned up some library issues with previously made parts
    [Main.sch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]
2016-12-09 Added Board file for gate driver board
    [Main.sch, gateDriverProto.brd]
2016-12-16 Added Parts, work on power input protection
    [Main.sch]
2016-12-16 Finished input protection sheet
    [Main.sch]
2016-12-16 gate driver halfway cleaned up
    [Main.sch]
2016-12-16 Gate driver completed
    [Main.sch]
2016-12-16 Added power fet part and start of psoc5lp part -further schematic cleaning done on the gate driver -datasheet for some of the new parts have been added
    [Main.sch]
2016-12-16 Freewheeling diodes selected and mcu created -documentation for fet module corrected -minor symbol changes
    [Main.sch]
2016-12-16 Updates to schematics
    [Main.sch]
2017-01-06 Added software to project repo -Workspace contains a testing project and a sample sensored bldc controller from cypress
2017-01-16 Major updates to connectors -ESD protection almost complete -TODOs: Packages for fet module, current sensor. -TODOs: Verify correct resistor/cap packages
    [Main.sch]
2017-01-19 Preparing for move to kiCad
    [Main.brd, Main.sch]
2017-01-22 Converted project to Kicad since autodesk took over eagle -I cant get the board size needed using eagle even with premium -cleanup still required
    [Main.brd, Main.kicad_pcb, Main.sch, Main_SS_1.sch, Main_SS_2.sch, Main_SS_3.sch, Main_SS_4.sch, Main_SS_5.sch]
2017-01-23 Schematic in eagle finished -decided to stick with eagle for the time being since the kicad switchover would take a lot of time -freewheeling diodes switched to vertical packages -footprint for psoc 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
    [Main.brd, Main.sch]
2017-01-23 PCB layout progress -completed first revision of input protection -added drc file which added 2 more layers and modified parameters of sparkfun's stock DRC -corrected schematic error which listed lab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
    [Main.brd, Main.sch]
2017-01-23 More work done on the buck converter of the drv8301
    [Main.brd, Main.sch]
2017-01-23 Finished gate driver layout -added the design rules check file that was omitted in a previous commit
    [Main.brd]
2017-01-24 Lots more layout complete -major micro controller rewiring -removed a connector and replaced it with a header -added some datasheets for cykit
    [Main.brd, Main.sch]
2017-01-24 First pass layout complete -still need to go over it with a fine toothed comb
    [Main.brd, Main.sch]
2017-01-24 fixed a couple airwires -Added keepout below 1206 resistors -TODO: current path from power input to fets needs to bet larger -TODO: silk screen fixes -TODO: DRV8301 solder mask fix -TODO: Mounting ho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
    [Main.brd, Main.sch]
2017-01-24 Fixed current path concerns -Arranged top fiducials
    [Main.brd, Main.sch]
2017-01-25 Lots of fine detail work -Mounting holes placed -Silk fixes and additions -SEM added to board
    [Main.brd, Main.sch]
2017-01-25 Laundry list of fixes -Changed feedback point for buck convert -Labeled layers in copper -Added filter cap to current sense line -Fixed footprint of acs758
    [Main.brd, Main.sch]
2017-01-25 Footprint updates and drc fixes -Additionally, filter cap added to throttle
    [Main.brd, Main.sch]
2017-01-26 RevA board sent to board house -lots of little silkscreen additions -tmp101 datasheet added -CAM files saved
    [Main.brd, Main.sch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]
2017-01-28 Removed Kicad folder from repo -Removed since because eagle was kept instead of transitioning
    [Main.brd, Main.kicad_pcb, Main.sch, Main_SS_1.sch, Main_SS_2.sch, Main_SS_3.sch, Main_SS_4.sch, Main_SS_5.sch]
2017-01-28 fixed untracked files
    [clockbrd.brd, gateDriverProto.brd, gateDriverProto.sch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]
2017-01-29 Added pdfs of RevB schematic and pcb -Cleaned schematic of RevB
    [Main.brd, Main.sch]
2017-01-30 Work on DRV8301 communication over SPI -Lots of additions in the topdesign that need to be fleshed out in the future
2017-01-30 Added BOM to cam files
    [bom.csv]
2017-01-31 BOM REV1 for PCB REVB
    [BOM_reformatted.xlsx]
2017-02-01 Added digikey friendly BOM -Added PurchaseOrders.7z which includes receipts from purchases made -PurchaseOrders.7z is currently encrypted until I have the time to remove personal data from pdfs
    [BOM_rev1_digikey_export.xls]
2017-02-18 Lots of software work, a datasheet update -Motor now running on revB board
2017-02-18 More playing around with throttle settings
2017-02-27 Starting work on Rev C, Rev B has been abandoned but not forgotten -Adding datasheets of some the the parts rec C will utilize -Added some power supply calculations -Added LT3045 and LT8631 parts in 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
    [Main.brd, Main.sch, RevC_PowerCalculations.xlsx]
2017-02-28 Gate driver circuitry added, many schematic updates -Some parts and datasheets also added
    [Main.brd, Main.sch]
2017-03-02 Bulk of schematic work finished, beginning layout
    [Main.brd, Main.sch, RevC_PowerCalculations.xlsx]
2017-03-02 Added test points to schematic -Restarted board
    [Main.brd, Main.sch]
2017-03-02 switching psu layout 50% done
    [Main.brd, Main.sch]
2017-03-02 LDO placed and routed
    [Main.brd, Main.sch]
2017-03-03 Major layout work
    [Main.brd, Main.sch]
2017-03-03 More signals run
    [Main.brd, Main.sch]
2017-03-03 Most Layout complete
    [Main.brd, Main.sch]
2017-03-03 Board mostly completed
    [Main.brd, Main.sch]
2017-03-04 All DRC errors fixed, labels applied, teardrop ULP run
    [Main.brd, Main.sch]
2017-03-10 Board Tag
    [Main.brd]
2017-03-16 Commiting the changes made in revC -Some documents related to revC design have also be included -some datasheets still missing
    [BOM_reformatted.xlsx, Main.brd, Main.sch, digikey-revC.csv, digikey-revC.xls, digikey-revC.xlsx, psoc_pinout.xlsx, revC-bom.xlsx]
